Miguel-SLO/2312_BadgePlace/doc/proces-verbaux/2312_SANTOS_ProcesVerbal_20-09-23.docx

# Diplôme SLO

# SANTOS Miguel

# 2312 Badge pour place de travail

# Procès-verbal du mercredi 20 septembre 2023

Présences | État des lieux
- Mr. Santos Miguel - Mr. Bovey Philippe | Programmation du module RFID réalisé. Configuration et programmation du module ESP32.
Problèmes rencontrés | Solutions proposées
- Problèmes de « exception générale » sur le PIC32 - Problèmes de communication avec les modules UART. | Analyse et débogage approfondi. [Problèmes résolus]
Décisions prises | Objectifs jusqu’à prochaine réunion
Réaliser la programmation du PCB jusqu’au vendredi et se concentrer sur la rédaction du rapport ensuite jusqu’au rendu. Préparer une démonstration pour les portes ouvertes | Rendu du rapport le 26/09 Rendu de l’affiche + résumé le 27/09 Portes ouvertes le 29/09

Prochaine réunion planifiée le :

N/A

Projet terminé

Destinataires du procès-verbal :
Grégoire Rossier Doyen de l’ETML-ES | Philippe Bovey Maître de diplôme
Lausanne, le 21 septembre 2023
