Miguel-SLO/2312_BadgePlace/doc/proces-verbaux/2312_SANTOS_ProcesVerbal_13-09-23.docx

# Diplôme SLO

# SANTOS Miguel

# 2312 Badge pour place de travail

# Procès-verbal du mercredi 13 septembre 2023

Présences | État des lieux
- Mr. Santos Miguel - Mr. Bovey Philippe | PCB entièrement monté sans problème apparent (reste à tester certaines lignes de communication)
Problèmes rencontrés | Solutions proposées
Court-circuit entre le VCC et le GND | Un pont entre deux vias s’était formés sous le microcontrôleur [Problème réglé]
Décisions prises | Objectifs jusqu’à prochaine réunion
Finir au plus vite la documentation sur le hardware et commencer celle de la partie software Réalisation du software selon priorités de la séance précédente | - Finir la documentation sur la partie hardware - Réaliser les diagrammes d’états du software - Mettre en lien les différentes parties du software pour pouvoir réaliser une démonstration - Etablir une communication avec le serveur externe

Prochaine réunion planifié le :

Mercredi 20 septembre 2023

15h00 – 16h00

Salle R110 ES

Destinataires du procès-verbal :
Grégoire Rossier Doyen de l’ETML-ES | Philippe Bovey Maître de diplôme
Lausanne, le 19 septembre 2023
