Miguel-SLO/2312_BadgePlace/doc/rapport/Rendu final/2312_BadgePlace_Planification.pdf

2312 Badge pour place de travail | Planning | 2023

## ETML⁻ES

Pré-étude

Design

Revue de schémas

Commande composants

PCB

Revue de PCB

Commande PCB

Montage et tests

Modélisation 3D

Firmware PCB

Software RPI

Mise en service

Documentation

Rendu mémoire

21.août

22.août

23.août

24.août

25.août

26.août

27.août

28.août

29.août

30.août

31.août
01.sept

02.sept

03.sept

04.sept

05.sept

06.sept

07.sept

08.sept

09.sept

10.sept

11.sept

12.sept

13.sept

14.sept

15.sept

Rendu affiche + résumé

Portes ouvertes

Présentation orale

Miguel Santos | SLO | 1

2312 Badge pour place de travail | Planning | 2023

## ETML⁻ES

Pré-étude

Design

Revue de schémas

Commande composants

PCB

Revue de PCB

Commande PCB

Montage et tests

Modélisation 3D

Firmware PCB

Software RPI

Mise en service

Documentation

Rendu mémoire

Rendu affiche + résumé

Portes ouvertes

Présentation orale

16.sept

17.sept

18.sept

19.sept

20.sept

21.sept

22.sept

23.sept

24.sept

25.sept

26.sept

27.sept

28.sept

29.sept

30.sept
01.oct

02.oct

03.oct

04.oct

05.oct

06.oct

07.oct

08.oct

Miguel Santos | SLO | 2
