Miguel-SLO/2312_BadgePlace/doc/rapport/sections/03_Design.tex

\section{Contexte}

    Les formations en École Supérieure se caractérisent par leur approche orientée sur la pratique.
    Dans le cadre de la formation ES, il est demandé la réalisation d'un projet complet lors de la deuxième année. Celle-ci a pour but de nous sensibiliser à toutes les étapes par lesquels un projet doit passer pour être concrétiser.

\section{But du projet}
    \lipsum[1]

\section{Cahier des charges}

    \lipsum[1]
    \lipsum[1]
