Miguel-SLO/2312_BadgePlace/doc/rapport/2312_BadgePlace_ModeDemploi.docx

2312

Mode d’emploi

Connexion / Communication Wi-Fi en cours

Erreur réseau / Wi-Fi introuvable

Connexion au Wi-Fi réussi

Badge RFID accepté

Badge RFID refusé

Avertissement de timeout

Miguel Santos SLO 1

ETML-ES Mode d’emploi 2312 Badge pour place de travail
