Miguel-SLO/2312_BadgePlace/doc/rapport/Rendu final/2312_annexe_firmware/bzrc.pdf

1 /*******************************************************************************
2 | * ________ _________ ____ ____ _____ ________ ______
3 | * |_ __ || _ _ ||_ \ / _||_ _| |_ __ |.' ____ \
4 | * | |_ \_||_/ | | \_| | \/ | | | ______ | |_ \_|| (___ \_|
5 | * | _| _ | | | |\ /| | | | _|______|| _| _ _.____`.
6 | * _| |__/ | _| |_ _| |_\/_| |_ _| |__/ | _| |__/ || \____) |
7 | * |________| |_____| |_____||_____||________| |________| \______.'
8 *
9 ******************************************************************************* 10 *
11 | * File : buzzer.c
12 | * Version : 1.0
13 *
14 ******************************************************************************* 15 *
16 * Description : Managing buzzer state machine and sequences
17 *
18 | * Thanks to robsoncouto on GitHub for musics !
19 | * https://github.com/robsoncouto/arduino-songs.git
20 *
21 ******************************************************************************* 22 *
23 | * Author : Miguel Santos
24 | * Date : 25.09.2023
25 *
26 ******************************************************************************* 27 *
28 | * MPLAB X : 5.45
29 | * XC32 : 2.50
30 | * Harmony : 2.06
31 *
32 ******************************************************************************/ 33
34 #include "bzr.h"
35 #include "peripheral/oc/plib_oc.h"
36
37 /******************************************************************************/ 38
39 /* Define the timer used by the buzzer */
40 #define BZR_TMR_ID TMR_ID_3
41
42 /* Define the OC output used by the buzzer */
43 #define BZR_OC_ID OC_ID_5
44
45 /* Set the volume of the buzzer by changing duty cycle */
46 #define BZR_VOLUME 0.1
47
48 /******************************************************************************/ 49
50 /* Define frequencies of notes in Hz */
51 #define NOTE_B0 31
52 #define NOTE_C1 33
53 #define NOTE_CS1 35
54 #define NOTE_D1 37
55 #define NOTE_DS1 39
56 #define NOTE_E1 41
57 #define NOTE_F1 44
58 #define NOTE_FS1 46
59 #define NOTE_G1 49
60 #define NOTE_GS1 52
61 #define NOTE_A1 55
62 #define NOTE_AS1 58
63 #define NOTE_B1 62
64 #define NOTE_C2 65
65 #define NOTE_CS2 69
66 #define NOTE_D2 73
67 #define NOTE_DS2 78
68 #define NOTE_E2 82
69 #define NOTE_F2 87
70 #define NOTE_FS2 93
71 #define NOTE_G2 98
72 #define NOTE_GS2 104
73 #define NOTE_A2 110

74 #define NOTE_AS2 117
75 #define NOTE_B2 123
76 #define NOTE_C3 131
77 #define NOTE_CS3 139
78 #define NOTE_D3 147
79 #define NOTE_DS3 156
80 #define NOTE_E3 165
81 #define NOTE_F3 175
82 #define NOTE_FS3 185
83 #define NOTE_G3 196
84 #define NOTE_GS3 208
85 #define NOTE_A3 220
86 #define NOTE_AS3 233
87 #define NOTE_B3 247
88 #define NOTE_C4 262
89 #define NOTE_CS4 277
90 #define NOTE_D4 294
91 #define NOTE_DS4 311
92 #define NOTE_E4 330
93 #define NOTE_F4 349
94 #define NOTE_FS4 370
95 #define NOTE_G4 392
96 #define NOTE_GS4 415
97 #define NOTE_A4 440
98 #define NOTE_AS4 466
99 #define NOTE_B4 494
100 #define NOTE_C5 523
101 #define NOTE_CS5 554
102 #define NOTE_D5 587
103 #define NOTE_DS5 622
104 #define NOTE_E5 659
105 #define NOTE_F5 698
106 #define NOTE_FS5 740
107 #define NOTE_G5 784
108 #define NOTE_GS5 831
109 #define NOTE_A5 880
110 #define NOTE_AS5 932
111 #define NOTE_B5 988
112 #define NOTE_C6 1047
113 #define NOTE_CS6 1109
114 #define NOTE_D6 1175
115 #define NOTE_DS6 1245
116 #define NOTE_E6 1319
117 #define NOTE_F6 1397
118 #define NOTE_FS6 1480
119 #define NOTE_G6 1568
120 #define NOTE_GS6 1661
121 #define NOTE_A6 1760
122 #define NOTE_AS6 1865
123 #define NOTE_B6 1976
124 #define NOTE_C7 2093
125 #define NOTE_CS7 2217
126 #define NOTE_D7 2349
127 #define NOTE_DS7 2489
128 #define NOTE_E7 2637
129 #define NOTE_F7 2794
130 #define NOTE_FS7 2960
131 #define NOTE_G7 3136
132 #define NOTE_GS7 3322
133 #define NOTE_A7 3520
134 #define NOTE_AS7 3729
135 #define NOTE_B7 3951
136 #define NOTE_C8 4186
137 #define NOTE_CS8 4435
138 #define NOTE_D8 4699
139 #define NOTE_DS8 4978
140 | #define REST 0
141
142 /******************************************************************************/ 143
144 /* All sequences are defined here */
145
146 /* Test sequence */

147 int16_t BZR_SEQUENCE_TEST[] = { 148 NOTE_A4,4, REST,4, NOTE_A4, 4,
149 };
150
151 /* Super Mario Bros theme - by Koji Kondo*/
152 int16_t BZR_SEQUENCE_MARIO[] = {
153 NOTE_E5, 8, NOTE_E5,8, REST,8, NOTE_E5,8, REST,8, NOTE_C5,8, NOTE_E5,8, //1 154 NOTE_G5,4, REST,4, NOTE_G4,8, REST,4,
155 NOTE_C5,-4, NOTE_G4,8, REST,4, NOTE_E4,-4, // 3
156 NOTE_A4,4, NOTE_B4,4, NOTE_AS4,8, NOTE_A4,4,
157 NOTE_G4,-8, NOTE_E5,-8, NOTE_G5,-8, NOTE_A5,4, NOTE_F5,8, NOTE_G5,8, 158 REST,8, NOTE_E5,4,NOTE_C5,8, NOTE_D5,8, NOTE_B4,-4,
159 NOTE_C5,-4, NOTE_G4,8, REST,4, NOTE_E4,-4, // repeats from 3
160 NOTE_A4,4, NOTE_B4,4, NOTE_AS4,8, NOTE_A4,4,
161 NOTE_G4,-8, NOTE_E5,-8, NOTE_G5,-8, NOTE_A5,4, NOTE_F5,8, NOTE_G5,8,
162 REST,8, NOTE_E5,4,NOTE_C5,8, NOTE_D5,8, NOTE_B4,-4,
163 REST,4, NOTE_G5,8, NOTE_FS5,8, NOTE_F5,8, NOTE_DS5,4, NOTE_E5,8,//7
164 REST,8, NOTE_GS4,8, NOTE_A4,8, NOTE_C4,8, REST,8, NOTE_A4,8, NOTE_C5,8, NOTE_D5,8, 165 REST,4, NOTE_DS5,4, REST,8, NOTE_D5,-4,
166 NOTE_C5,2, REST,2,
167 REST,4, NOTE_G5,8, NOTE_FS5,8, NOTE_F5,8, NOTE_DS5,4, NOTE_E5,8,//repeats from 7 168 REST,8, NOTE_GS4,8, NOTE_A4,8, NOTE_C4,8, REST,8, NOTE_A4,8, NOTE_C5,8, NOTE_D5,8, 169 REST,4, NOTE_DS5,4, REST,8, NOTE_D5,-4,
170 NOTE_C5,2, REST,2,
171 NOTE_C5,8, NOTE_C5,4, NOTE_C5,8, REST,8, NOTE_C5,8, NOTE_D5,4,//11
172 NOTE_E5,8, NOTE_C5,4, NOTE_A4,8, NOTE_G4,2,
173 NOTE_C5,8, NOTE_C5,4, NOTE_C5,8, REST,8, NOTE_C5,8, NOTE_D5,8, NOTE_E5,8,//13 174 REST,1,
175 NOTE_C5,8, NOTE_C5,4, NOTE_C5,8, REST,8, NOTE_C5,8, NOTE_D5,4,
176 NOTE_E5,8, NOTE_C5,4, NOTE_A4,8, NOTE_G4,2,
177 NOTE_E5,8, NOTE_E5,8, REST,8, NOTE_E5,8, REST,8, NOTE_C5,8, NOTE_E5,4, 178 NOTE_G5,4, REST,4, NOTE_G4,4, REST,4,
179 NOTE_C5,-4, NOTE_G4,8, REST,4, NOTE_E4,-4, // 19
180 NOTE_A4,4, NOTE_B4,4, NOTE_AS4,8, NOTE_A4,4,
181 NOTE_G4,-8, NOTE_E5,-8, NOTE_G5,-8, NOTE_A5,4, NOTE_F5,8, NOTE_G5,8, 182 REST,8, NOTE_E5,4, NOTE_C5,8, NOTE_D5,8, NOTE_B4,-4,
183 NOTE_C5,-4, NOTE_G4,8, REST,4, NOTE_E4,-4, // repeats from 19
184 NOTE_A4,4, NOTE_B4,4, NOTE_AS4,8, NOTE_A4,4,
185 NOTE_G4,-8, NOTE_E5,-8, NOTE_G5,-8, NOTE_A5,4, NOTE_F5,8, NOTE_G5,8, 186 REST,8, NOTE_E5,4, NOTE_C5,8, NOTE_D5,8, NOTE_B4,-4,
187 NOTE_E5,8, NOTE_C5,4, NOTE_G4,8, REST,4, NOTE_GS4,4,//23
188 NOTE_A4,8, NOTE_F5,4, NOTE_F5,8, NOTE_A4,2,
189 NOTE_D5,-8, NOTE_A5,-8, NOTE_A5,-8, NOTE_A5,-8, NOTE_G5,-8, NOTE_F5,-8, 190 NOTE_E5,8, NOTE_C5,4, NOTE_A4,8, NOTE_G4,2, //26
191 NOTE_E5,8, NOTE_C5,4, NOTE_G4,8, REST,4, NOTE_GS4,4,
192 NOTE_A4,8, NOTE_F5,4, NOTE_F5,8, NOTE_A4,2,
193 NOTE_B4,8, NOTE_F5,4, NOTE_F5,8, NOTE_F5,-8, NOTE_E5,-8, NOTE_D5,-8, 194 NOTE_C5,8, NOTE_E4,4, NOTE_E4,8, NOTE_C4,2,
195 NOTE_E5,8, NOTE_C5,4, NOTE_G4,8, REST,4, NOTE_GS4,4,//repeats from 23 196 NOTE_A4,8, NOTE_F5,4, NOTE_F5,8, NOTE_A4,2,
197 NOTE_D5,-8, NOTE_A5,-8, NOTE_A5,-8, NOTE_A5,-8, NOTE_G5,-8, NOTE_F5,-8, 198 NOTE_E5,8, NOTE_C5,4, NOTE_A4,8, NOTE_G4,2, //26
199 NOTE_E5,8, NOTE_C5,4, NOTE_G4,8, REST,4, NOTE_GS4,4,
200 NOTE_A4,8, NOTE_F5,4, NOTE_F5,8, NOTE_A4,2,
201 NOTE_B4,8, NOTE_F5,4, NOTE_F5,8, NOTE_F5,-8, NOTE_E5,-8, NOTE_D5,-8, 202 NOTE_C5,8, NOTE_E4,4, NOTE_E4,8, NOTE_C4,2,
203 NOTE_C5,8, NOTE_C5,4, NOTE_C5,8, REST,8, NOTE_C5,8, NOTE_D5,8, NOTE_E5,8, 204 REST,1,
205 NOTE_C5,8, NOTE_C5,4, NOTE_C5,8, REST,8, NOTE_C5,8, NOTE_D5,4, //33
206 NOTE_E5,8, NOTE_C5,4, NOTE_A4,8, NOTE_G4,2,
207 NOTE_E5,8, NOTE_E5,8, REST,8, NOTE_E5,8, REST,8, NOTE_C5,8, NOTE_E5,4, 208 NOTE_G5,4, REST,4, NOTE_G4,4, REST,4,
209 NOTE_E5,8, NOTE_C5,4, NOTE_G4,8, REST,4, NOTE_GS4,4,
210 NOTE_A4,8, NOTE_F5,4, NOTE_F5,8, NOTE_A4,2,
211 NOTE_D5,-8, NOTE_A5,-8, NOTE_A5,-8, NOTE_A5,-8, NOTE_G5,-8, NOTE_F5,-8, 212 NOTE_E5,8, NOTE_C5,4, NOTE_A4,8, NOTE_G4,2, //40
213 NOTE_E5,8, NOTE_C5,4, NOTE_G4,8, REST,4, NOTE_GS4,4,
214 NOTE_A4,8, NOTE_F5,4, NOTE_F5,8, NOTE_A4,2,
215 NOTE_B4,8, NOTE_F5,4, NOTE_F5,8, NOTE_F5,-8, NOTE_E5,-8, NOTE_D5,-8, 216 NOTE_C5,8, NOTE_E4,4, NOTE_E4,8, NOTE_C4,2,
217 //game over sound
218 NOTE_C5,-4, NOTE_G4,-4, NOTE_E4,4, //45
219 NOTE_A4,-8, NOTE_B4,-8, NOTE_A4,-8, NOTE_GS4,-8, NOTE_AS4,-8, NOTE_GS4,-8,

220 NOTE_G4,8, NOTE_D4,8, NOTE_E4,-2,
221
222 };
223 /* Dart Vader theme (Imperial March) - Star wars */
224 int16_t BZR_SEQUENCE_IMPERIAL[] = {
225 NOTE_A4, -4, NOTE_A4, -4, NOTE_A4, 16, NOTE_A4, 16,
226 | NOTE_A4, 16, NOTE_A4, 16, NOTE_F4, 8, REST, 8,
227 NOTE_A4, -4, NOTE_A4, -4, NOTE_A4, 16, NOTE_A4, 16,
228 | NOTE_A4, 16, NOTE_A4, 16, NOTE_F4, 8, REST, 8,
229 | NOTE_A4, 4, NOTE_A4, 4, NOTE_A4, 4,
230 | NOTE_F4, -8, NOTE_C5, 16, NOTE_A4, 4,
231 | NOTE_F4, -8, NOTE_C5, 16, NOTE_A4, 2,
232 | NOTE_E5, 4, NOTE_E5, 4, NOTE_E5, 4,
233 | NOTE_F5, -8, NOTE_C5, 16, NOTE_A4, 4,
234 | NOTE_F4, -8, NOTE_C5, 16, NOTE_A4, 2,
235 | NOTE_A5, 4, NOTE_A4, -8, NOTE_A4, 16,
236 | NOTE_A5, 4, NOTE_GS5, -8, NOTE_G5, 16,
237 | NOTE_DS5, 16, NOTE_D5, 16, NOTE_DS5, 8, REST, 8,
238 | NOTE_A4, 8, NOTE_DS5, 4, NOTE_D5, -8, NOTE_CS5, 16,
239 | NOTE_C5, 16, NOTE_B4, 16, NOTE_C5, 16, REST, 8,
240 | NOTE_F4, 8, NOTE_GS4, 4, NOTE_F4, -8, NOTE_A4, -16,
241 | NOTE_C5, 4, NOTE_A4, -8, NOTE_C5, 16, NOTE_E5, 2,
242 | NOTE_A5, 4, NOTE_A4, -8, NOTE_A4, 16,
243 | NOTE_A5, 4, NOTE_GS5, -8, NOTE_G5, 16,
244 | NOTE_DS5, 16, NOTE_D5, 16, NOTE_DS5, 8, REST, 8,
245 | NOTE_A4, 8, NOTE_DS5, 4, NOTE_D5, -8, NOTE_CS5, 16,
246 | NOTE_C5, 16, NOTE_B4, 16, NOTE_C5, 16, REST, 8,
247 | NOTE_F4, 8, NOTE_GS4, 4, NOTE_F4, -8, NOTE_A4, -16,
248 | NOTE_A4, 4, NOTE_F4, -8, NOTE_C5, 16,
249 | NOTE_A4, 2,
250 };
251
252 /******************************************************************************/ 253
254 /* Hold informations about sequences */
255 S_BZR_SEQ BZR_SEQUENCES[] = {
256 /* TESTING */
257 {
258 .tempo = 200,
259 .size = sizeof(BZR_SEQUENCE_TEST), 260 .notes = BZR_SEQUENCE_TEST,
261 },
262 /* MARIO BROS SONG */
263 {
264 .tempo = 200,
265 .size = sizeof(BZR_SEQUENCE_MARIO), 266 .notes = BZR_SEQUENCE_MARIO,
267 },
268 /* IMPERIAL MARCH */
269 {
270 .tempo = 120,
271 .size = sizeof(BZR_SEQUENCE_IMPERIAL), 272 .notes = BZR_SEQUENCE_IMPERIAL,
273 },
274 };
275
276 /******************************************************************************/ 277
278 /* Declaration of global application data */
279 BZR_DATA bzrData;
280
281 /******************************************************************************/ 282
283 /* Static functions declaration */
284
285 static void BZR_SetFrequency(uint16_t frequency);
286 static void BZR_SetCounter(int8_t tempo);
287
288 /******************************************************************************/ 289
290 /**
291 * @brief BZR_Initialize
292 *

293 * Initialize buzzer state machine 294 *
295 * @param void
296 * @return void
297 */
298 void BZR_Initialize ( void )
299 {
300 /* Place the buzzer state machine in its initial state. */ 301 bzrData.state = BZR_STATE_IDLE;
302
303 /* Flag to indicate a new sequence available */
304 bzrData.newSequence = false;
305
306 /* Calculate timer frequency only one time */
307 bzrData.tmrFrequency = (uint32_t)(SYS_CLK_FREQ /
308 PLIB_TMR_PrescaleGet(BZR_TMR_ID)); 309
310 /* Init counter used to count time of notes */
311 CNT_Initialize(&bzrData.counterPlay, 0x00);
312 }
313
314 /******************************************************************************/ 315
316 /**
317 * @brief BZR_Tasks
318 *
319 * Execute buzzer state machine, should be called cyclically 320 *
321 * @param void
322 * @return void
323 */
324 void BZR_Tasks ( void )
325 {
326
327 /* Check the application's current state. */ 328 switch ( bzrData.state )
329 {
330 /* Buzzer waiting for new sequence */ 331 case BZR_STATE_IDLE:
332 {
333 if(bzrData.newSequence)
334 {
335 bzrData.state = BZR_STATE_NOTE; 336 }
337 break;
338 }
339
340 /* Buzzer getting the note to play */
341 case BZR_STATE_NOTE:
342 {
343 BZR_SetFrequency(bzrData.currentNote[0]); 344 BZR_SetCounter(bzrData.currentNote[1]); 345 bzrData.state = BZR_STATE_PLAYING;
346 break;
347 }
348
349 /* Buzzer playing the note and waiting */ 350 case BZR_STATE_PLAYING:
351 {
352 if(CNT_Check(&bzrData.counterPlay))
353 {
354 if(bzrData.currentNote >= bzrData.lastNote) 355 {
356 PLIB_TMR_Stop(BZR_TMR_ID);
357 PLIB_OC_Disable(BZR_OC_ID);
358 bzrData.newSequence = false; 359 bzrData.state = BZR_STATE_IDLE; 360 }
361 else
362 {
363 bzrData.currentNote += 2; 364 bzrData.state = BZR_STATE_NOTE; 365 }

366 }
367 break;
368 }
369
370 /* The default state should never be executed. */
371 default:
372 {
373 /* TODO: Handle error in application's state machine. */ 374 break;
375 }
376 }
377 }
378
379 /******************************************************************************/ 380
381 /**
382 * @brief BZR_PlaySequence
383 *
384 * Play a music sequence using the state machine
385 *
386 | * @param | E_BZR_SEQ song Call the music you wann play !
387 * @return void
388 */
389 void BZR_PlaySequence(E_BZR_SEQ song)
390 {
391 bzrData.sequence = BZR_SEQUENCES[song].notes; 392
393 bzrData.tempo = BZR_SEQUENCES[song].tempo; 394
395 bzrData.currentNote = bzrData.sequence;
396
397 bzrData.lastNote = bzrData.sequence + BZR_SEQUENCES[song].size / 2 - 2; 398
399 bzrData.newSequence = true;
400 }
401
402 /******************************************************************************/ 403
404 /**
405 * @brief BZR_SetFrequency
406 *
407 * Set the frequency of the timer to play a note 408 * Start the timer and OC except if frequency is 0 409 *
410 | * @param | uint16_t frequency Frequency to play
411 * @return void
412 */
413 static void BZR_SetFrequency(uint16_t frequency) 414 {
415 uint16_t period_tmr;
416
417 PLIB_TMR_Stop(BZR_TMR_ID); 418 PLIB_OC_Disable(BZR_OC_ID); 419
420 if(frequency != 0)
421 {
422 period_tmr = (uint16_t)( bzrData.tmrFrequency / frequency); 423
424 PLIB_TMR_Period16BitSet(BZR_TMR_ID, period_tmr);
425 PLIB_OC_PulseWidth16BitSet(BZR_OC_ID, period_tmr * BZR_VOLUME); 426
427 PLIB_TMR_Start(BZR_TMR_ID);
428 PLIB_OC_Enable(BZR_OC_ID);
429 }
430 }
431
432 /******************************************************************************/ 433
434 /**
435 * @brief BZR_SetCounter
436 *
437 * Set the duration of the note, using musical tempo 438 * (whole, half, quarter, eigth, ...)

439 *
440 | * @param | int8_t tempo note tempo
441 * @return void
442 */
443 static void BZR_SetCounter(int8_t tempo) 444 {
445 uint32_t counter_ms;
446
447 if(tempo > 0)
448 {
449 counter_ms = (uint32_t)((60000 * 4 / bzrData.tempo) / tempo); 450 }
451 else if(tempo < 0)
452 {
453 counter_ms = (uint32_t)((60000 * 4 / bzrData.tempo)/ abs(tempo)); 454 counter_ms = counter_ms * 1.5;
455 }
456 else
457 {
458 counter_ms = 0;
459 }
460
461 CNT_Set(&bzrData.counterPlay, counter_ms); 462 CNT_Reset(&bzrData.counterPlay);
463 }
464
465 /******************************************************************************/ 466
467 /* End of File ****************************************************************/ 468
