Miguel-SLO/2312_BadgePlace/doc/rapport/Rendu final/2312_annexe_firmware/esph.pdf

1 /*******************************************************************************
2 | * ________ _________ ____ ____ _____ ________ ______
3 | * |_ __ || _ _ ||_ \ / _||_ _| |_ __ |.' ____ \
4 | * | |_ \_||_/ | | \_| | \/ | | | ______ | |_ \_|| (___ \_|
5 | * | _| _ | | | |\ /| | | | _|______|| _| _ _.____`.
6 | * _| |__/ | _| |_ _| |_\/_| |_ _| |__/ | _| |__/ || \____) |
7 | * |________| |_____| |_____||_____||________| |________| \______.'
8 *
9 ******************************************************************************* 10 *
11 | * File : esp.h
12 | * Version : 1.0
13 *
14 ******************************************************************************* 15 *
16 * Description : Managing ESP32 state machine and commands
17 *
18 ******************************************************************************* 19 *
20 | * Author : Miguel Santos
21 | * Date : 25.09.2023
22 *
23 ******************************************************************************* 24 *
25 | * MPLAB X : 5.45
26 | * XC32 : 2.50
27 | * Harmony : 2.06
28 *
29 ******************************************************************************/ 30
31 #ifndef _ESP_H
32 #define _ESP_H
33
34 /******************************************************************************/ 35
36 #include <stdint.h>
37 #include <stdbool.h>
38 #include "system_config.h"
39 #include "system_definitions.h" 40 #include "modules/fifo.h"
41 #include "modules/counter.h"
42
43 /******************************************************************************/ 44
45 /* Buffers sizes */
46
47 #define ESP_FIFO_SIZE 50 48 #define AT_CMD_SIZE 50
49 #define AT_DATA_SIZE 50
50 #define AT_ACK_SIZE 10
51
52 /******************************************************************************/ 53
54 /* AT commands to send */
55 | #define AT_CMD_AT "AT"
56 | #define AT_CMD_RST "AT+RST"
57 #define AT_CMD_CWMODEIS "AT+CWMODE=1"
58 | #define AT_CMD_CWMODE "AT+CWMODE?"
59 | #define AT_CMD_CWJAP "AT+CWJAP=\"ES-SLO-2\",\"slo-etml-es\""
60
61 /* AT acknowledge responses */
62 | #define AT_ACK_OK "OK"
63 | #define AT_ACK_ERROR "ERROR"
64
65 /******************************************************************************/ 66
67 /* Structure of packets communication as defined by ESP32 datasheet */
68 typedef struct
69 {
70 char command[AT_CMD_SIZE];
71 char data[AT_DATA_SIZE]; 72 char ack[AT_ACK_SIZE];
73

74 } S_AT_PACKET;
75
76 /******************************************************************************/ 77
78 /* ESP state machine */

### 79 typedef enum

80 {
81 /* Waiting for a command */ 82 ESP_STATE_IDLE,
83
84 /* Transmitting a command */ 85 ESP_STATE_TRANSMIT,
86
87 /* Receiving a command */
88 ESP_STATE_RECEIVE,
89
90 /* Translating the UART message */ 91 ESP_STATE_TRANSLATE,
92
93 /* Waiting for main application */ 94 ESP_STATE_WAIT,
95
96 } E_ESP_STATES;
97
98 /******************************************************************************/ 99
100 /* ESP32 structure of global data */
101 typedef struct
102 {
103 /* Application's current states */ 104 E_ESP_STATES state;
105
106 /* Applications's flags */
107 bool transmit;
108 bool receive;
109 bool translate;
110 bool wait;
111 bool newMessage;
112
113 /* Applications COUNTERS */ 114 S_Counter cntReceive;
115 S_Counter cntWait;
116
117 /* Application's FIFOS descriptors */ 118 S_Fifo fifoDesc_tx;
119 S_Fifo fifoDesc_rx;
120
121 /* Application's FIFOS buffers */ 122 uint8_t fifoBuff_tx[ESP_FIFO_SIZE]; 123 uint8_t fifoBuff_rx[ESP_FIFO_SIZE]; 124
125 /* Buffer to store response commands */ 126 char resBuffer[ESP_FIFO_SIZE];
127
128 /* Pointer to last char received */ 129 char *p_resBuffer;
130
131 /* Store response as different fields */ 132 S_AT_PACKET atResponse;
133
134 } ESP_DATA;
135
136 /******************************************************************************/ 137
138 /**
139 * @brief ESP_Initialize
140 *
141 * Initialize ESP32 state machine, counters and FIFOs 142 *
143 * @param void
144 * @return void
145 */
146 void ESP_Initialize ( void );

147
148 /******************************************************************************/ 149
150 /**
151 * @brief ESP_Tasks
152 *
153 * Execute ESP32 state machine, should be called cyclically 154 *
155 * @param void
156 * @return void
157 */
158 void ESP_Tasks( void );
159
160 /******************************************************************************/ 161
162 /**
163 * @brief ESP_SendCommand
164 *
165 * Send a command to the ESP32, managed by state machine
166 *
167 * @param char Command to send ; Use constant definitions
168 * @return bool True = command send ; False = Not allowed to send a command 169 */
170 bool ESP_SendCommand( char *command );
171
172 /******************************************************************************/ 173
174 #endif /* _ESP_H */
175
176 /* End of File ****************************************************************/ 177
