Miguel-SLO/2312_BadgePlace/doc/rapport/Rendu final/2312_annexe_firmware/SerialTimerc.pdf

1 /*******************************************************************************
2 | * ________ _________ ____ ____ _____ ________ ______
3 | * |_ __ || _ _ ||_ \ / _||_ _| |_ __ |.' ____ \
4 | * | |_ \_||_/ | | \_| | \/ | | | ______ | |_ \_|| (___ \_|
5 | * | _| _ | | | |\ /| | | | _|______|| _| _ _.____`.
6 | * _| |__/ | _| |_ _| |_\/_| |_ _| |__/ | _| |__/ || \____) |
7 | * |________| |_____| |_____||_____||________| |________| \______.'
8 *
9 ******************************************************************************* 10 *
11 | * File : SerialTimer.c
12 | * Version : 1.0
13 *
14 ******************************************************************************* 15 *
16 * Description : Emulate a serial port on a GPIO pin using a timer
17 *
18 ******************************************************************************* 19 *
20 | * Author : Miguel Santos
21 | * Date : 14.09.2023
22 *
23 ******************************************************************************* 24 *
25 | * MPLAB X : 5.45
26 | * XC32 : 2.50
27 | * Harmony : 2.06
28 *
29 ******************************************************************************/ 30
31 #include "system_definitions.h"
32 #include "SerialTimer.h"
33
34 /* Pin where the serial datas will be output */
35 #define SERIAL_PIN LATDbits.LATD0
36
37 /* Pin to control the timer related to the serial emulator */ 38 #define STR_TMR_ID DRV_TMR_INDEX_1
39
40 /* Number of bits to transmit per data */
41 #define SERIAL_BITS 5
42
43 /******************************************************************************/ 44
45 uint8_t strBuffer[STR_BUFFER_SIZE];
46 uint8_t *strPointer;
47 uint8_t *strLast;
48 uint8_t bitPosition;
49
50 /******************************************************************************/ 51
52 void STR_Init( void )
53 {
54 uint8_t i_buffer;
55
56 for(i_buffer = 0 ; i_buffer < STR_BUFFER_SIZE ; i_buffer++) 57 {
58 strBuffer[i_buffer] = STR_BUFFER_DEFAULT;
59 }
60 strPointer = strBuffer;
61 bitPosition= 0;
62 }
63
64 /******************************************************************************/ 65
66 void STR_AddBuffer(uint8_t *data, uint8_t size)
67 {
68 uint8_t i_data;
69
70 for(i_data = 0; i_data < size ; i_data++) 71 {
72 strBuffer[i_data] = *(data + i_data); 73 }

74
75 strLast = strBuffer + size - 1;
76 }
77
78 /******************************************************************************/ 79

### 80 void STR_Start( void )

81 {
82 DRV_TMR_Start(STR_TMR_ID);
83 }
84
85 /******************************************************************************/ 86

### 87 void STR_CallBack( void )

88 {
89 SERIAL_PIN = (*strPointer >> bitPosition) & 0x01; 90
91 bitPosition++;
92
93 /* Go back to lsb when reached limit */

### 94 if(bitPosition>= SERIAL_BITS)

95 {
96 bitPosition= 0;
97 strPointer++;
98 }
99
100 /* Disable timer when reached end of buffer */ 101 if(strPointer > strLast)
102 {
103 DRV_TMR_Stop(STR_TMR_ID);
104 strPointer = strBuffer; 105 }
106 }
107
108 /* End of File ****************************************************************/ 109
