Miguel-SLO/2312_BadgePlace/doc/captures/clearance_esp32.png

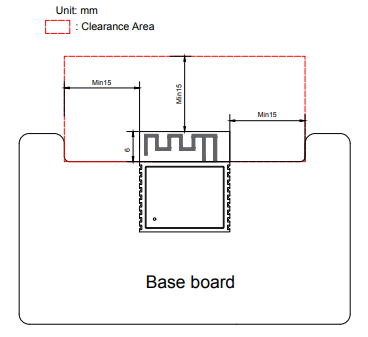
doc/captures/clearance_esp32.png
