Miguel-SLO/2312_BadgePlace/doc/captures/ESP32_Boot_putty.PNG

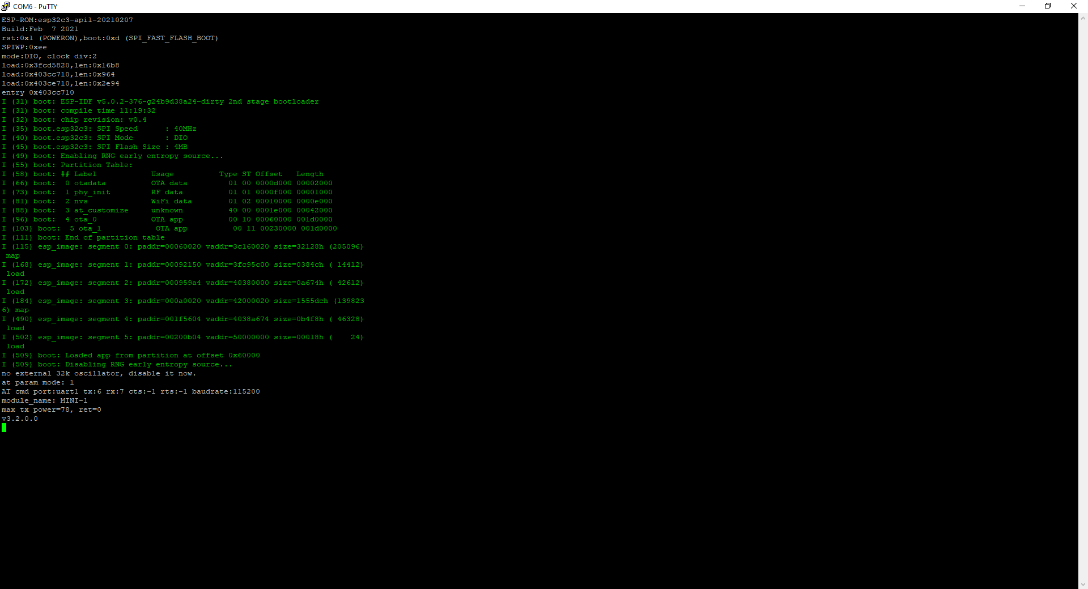
doc/captures/ESP32_Boot_putty.PNG
