Miguel-SLO/2312_BadgePlace/doc/captures/ESP/CMD_AT.png

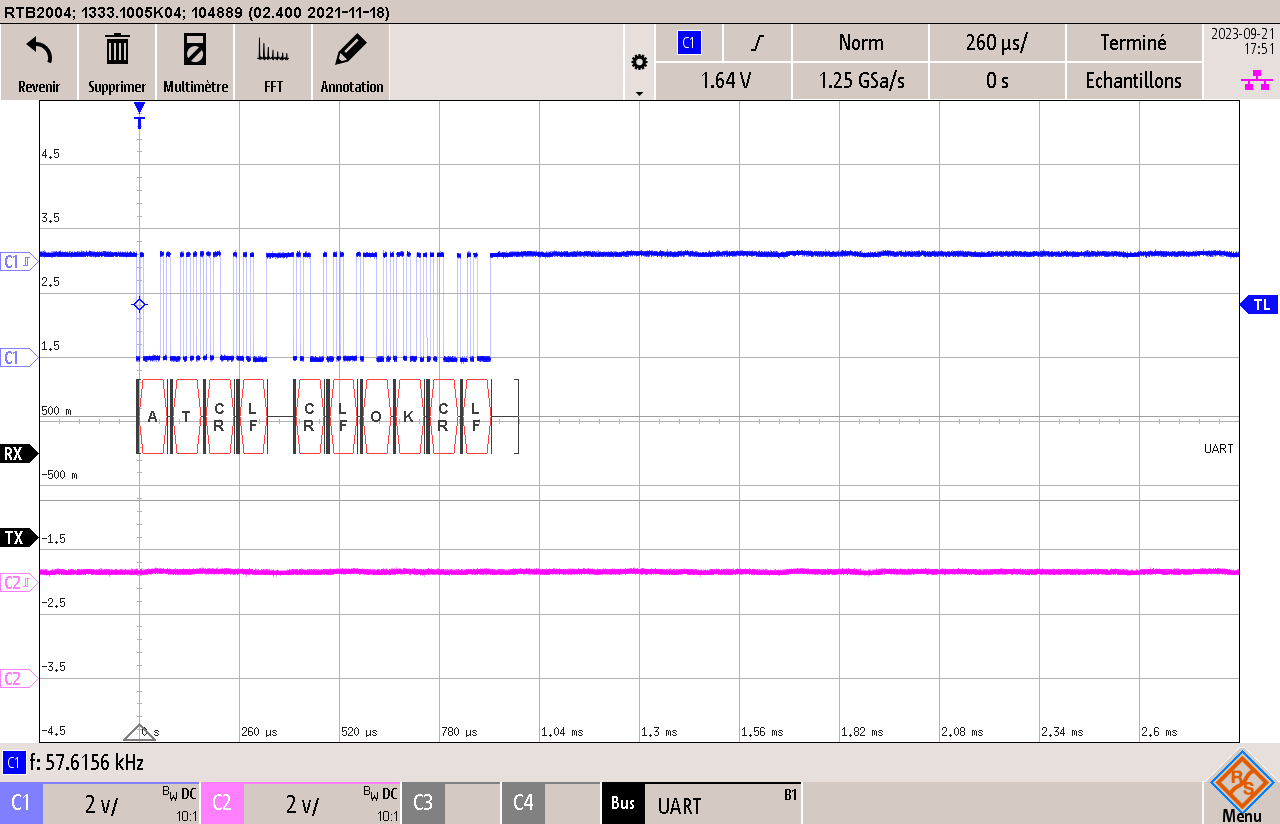
doc/captures/ESP/CMD_AT.png
