Miguel-SLO/2312_BadgePlace/doc/captures/ESP/WifiGotIP.png

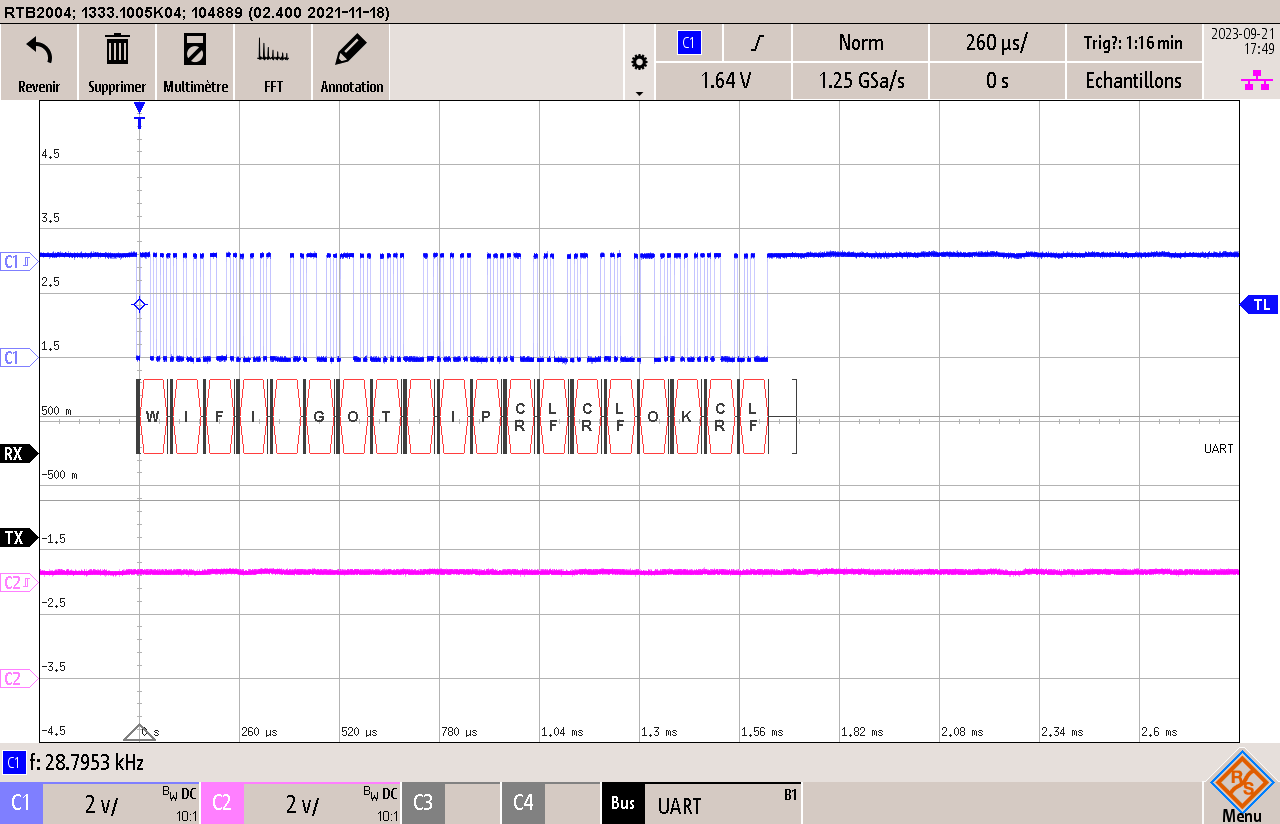
doc/captures/ESP/WifiGotIP.png
