Miguel-SLO/2312_BadgePlace/doc/captures/flash_esp32_c3.PNG

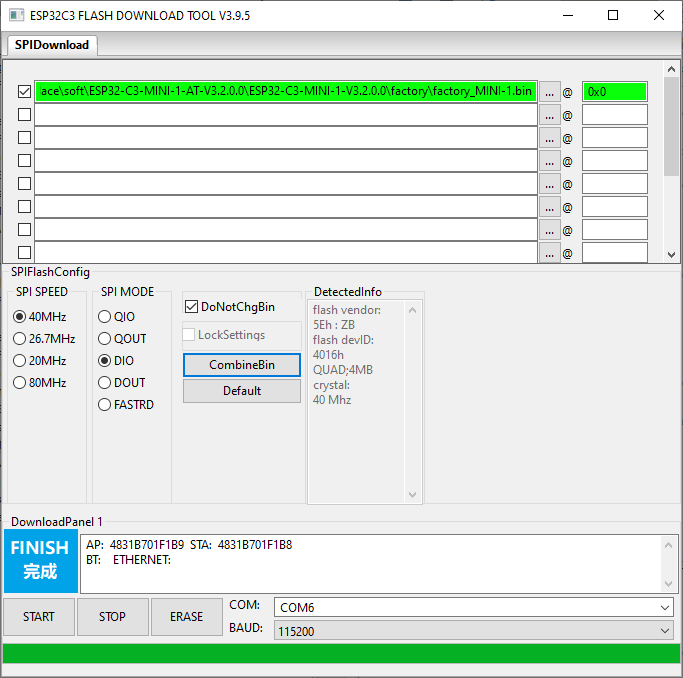
doc/captures/flash_esp32_c3.PNG
