Miguel-SLO/2312_BadgePlace/doc/captures/MPLAB/Configuration_USART.PNG

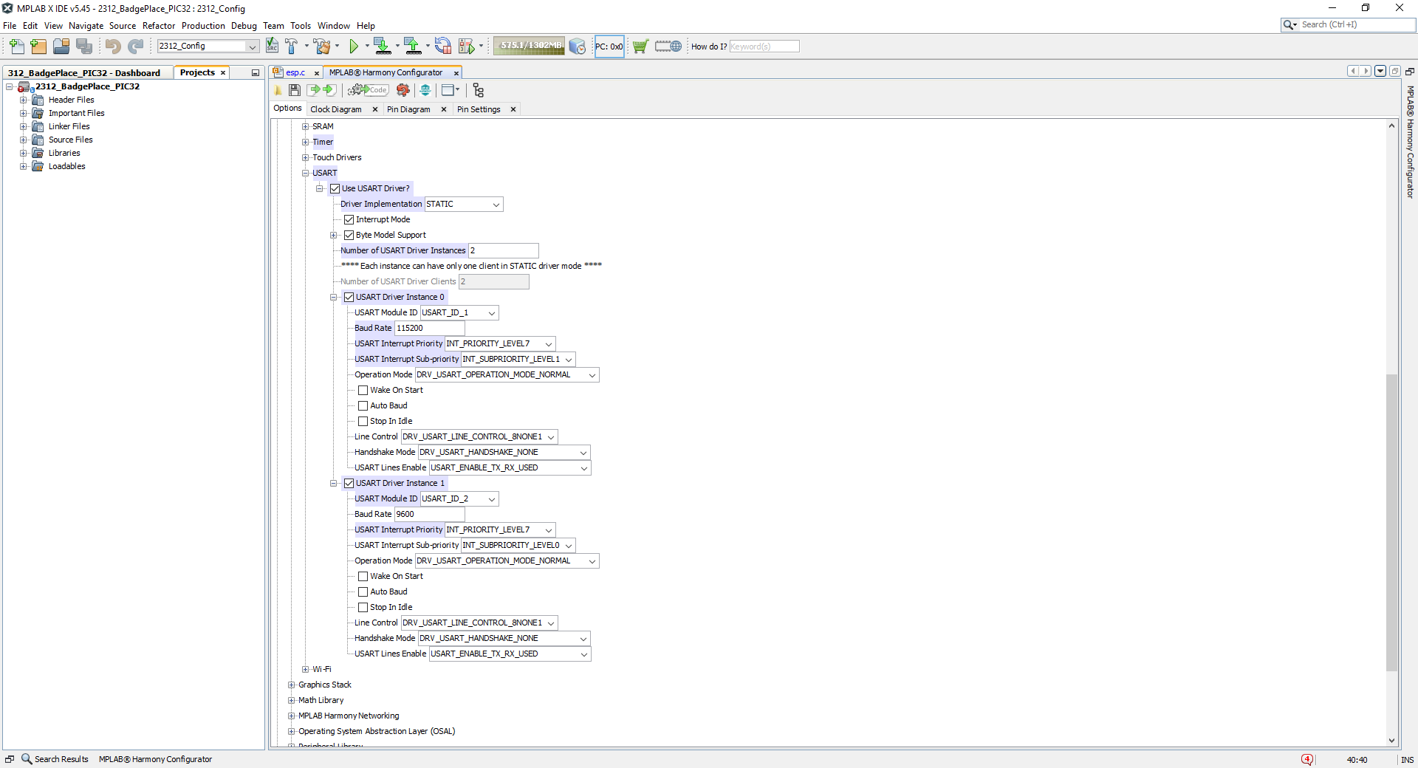
doc/captures/MPLAB/Configuration_USART.PNG
