Miguel-SLO/2312_BadgePlace/doc/captures/MPLAB/réception_command-ATCWINIT.png

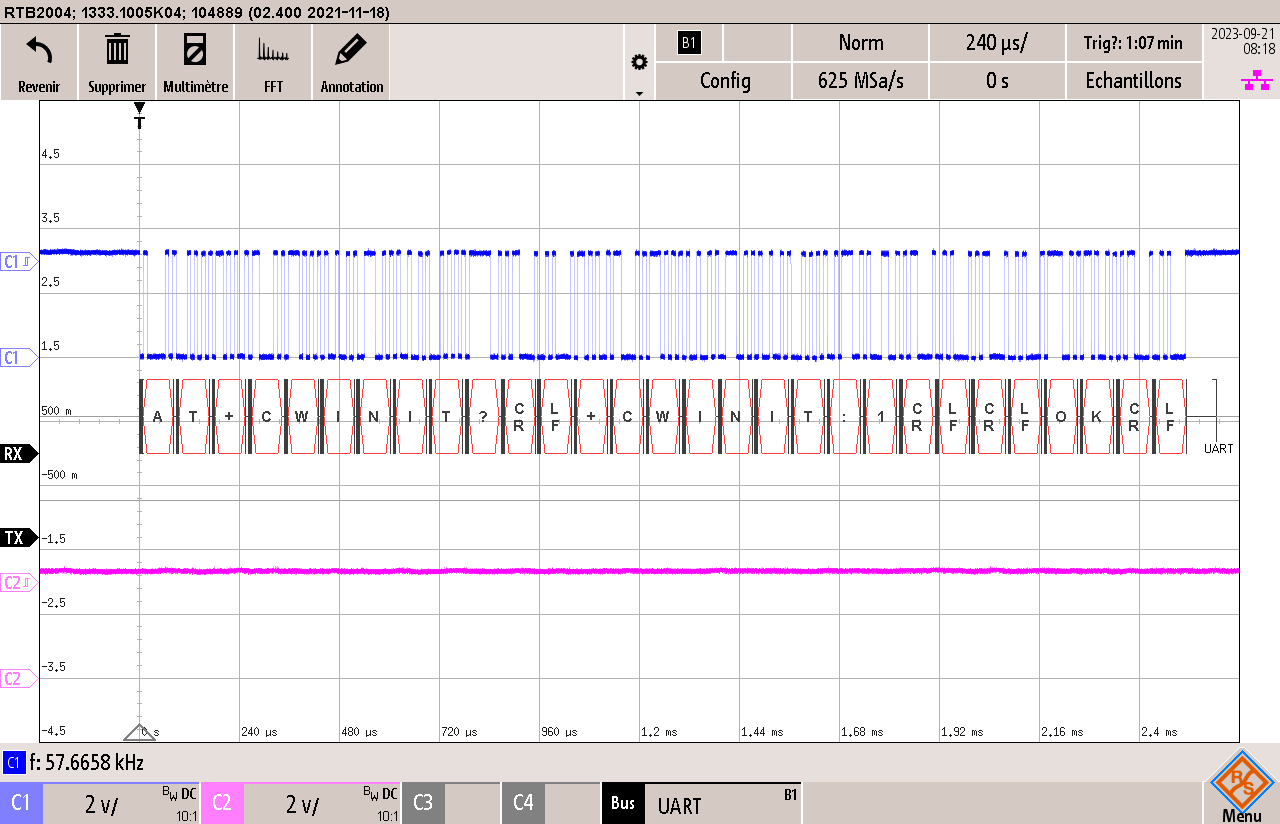
doc/captures/MPLAB/réception_command-ATCWINIT.png
