Miguel-SLO/2312_BadgePlace/doc/captures/pic32_config_timers.PNG

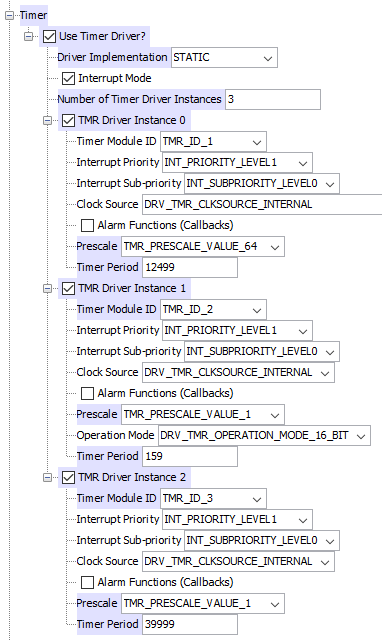
doc/captures/pic32_config_timers.PNG
