Miguel-SLO/2312_BadgePlace/doc/captures/pic32_config_usart.PNG

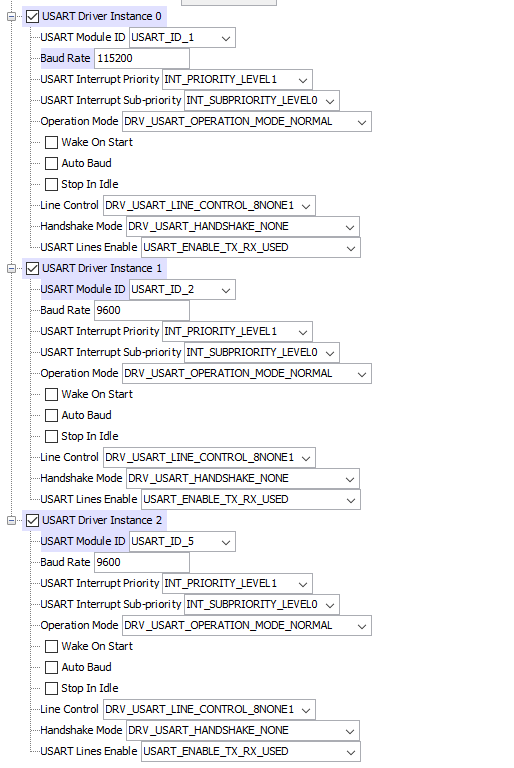
doc/captures/pic32_config_usart.PNG
