Miguel-SLO/2312_BadgePlace/doc/captures/placemement_esp32.png

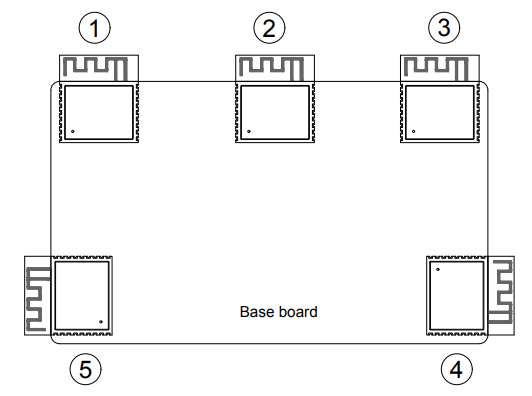
doc/captures/placemement_esp32.png
