Miguel-SLO/2312_BadgePlace/doc/captures/placemement_esp32_annoté.png

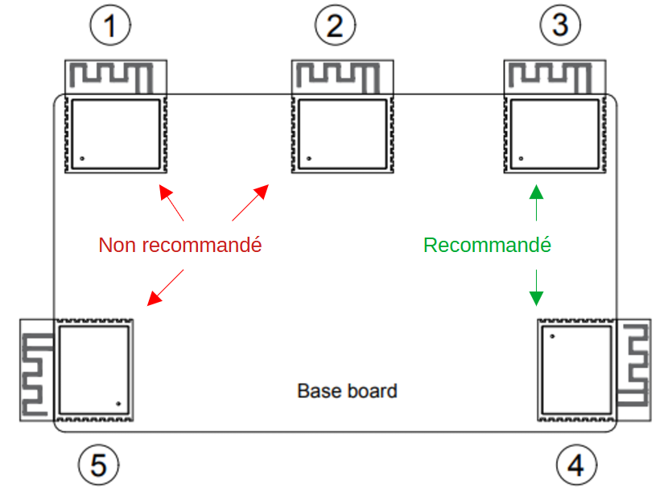
doc/captures/placemement_esp32_annoté.png
