Miguel-SLO/2312_BadgePlace/doc/firmware/ConfigHarmony/Harmony_OC.PNG

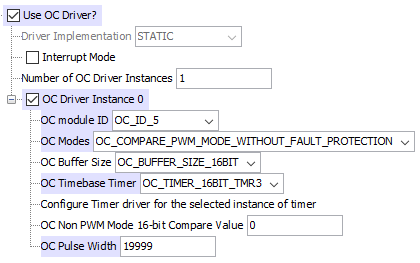
doc/firmware/ConfigHarmony/Harmony_OC.PNG
