Miguel-SLO/2312_BadgePlace/doc/firmware/ConfigHarmony/Harmony_TMR.PNG

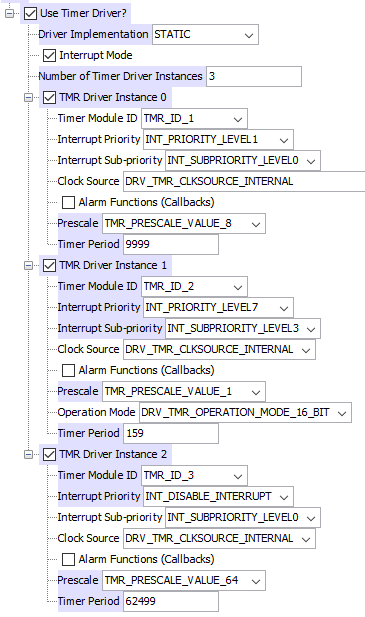
doc/firmware/ConfigHarmony/Harmony_TMR.PNG
