Miguel-SLO/2312_BadgePlace/doc/firmware/ConfigHarmony/Harmony_UART.PNG

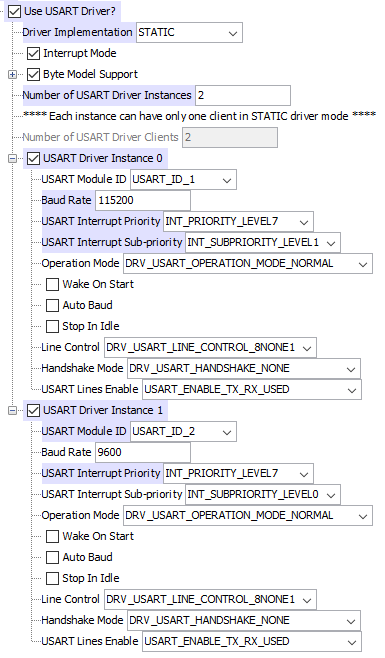
doc/firmware/ConfigHarmony/Harmony_UART.PNG
