Miguel-SLO/2312_BadgePlace/doc/rapport/2312_SchemasBlocs/2312_Images_Schemas/bluetooth.png

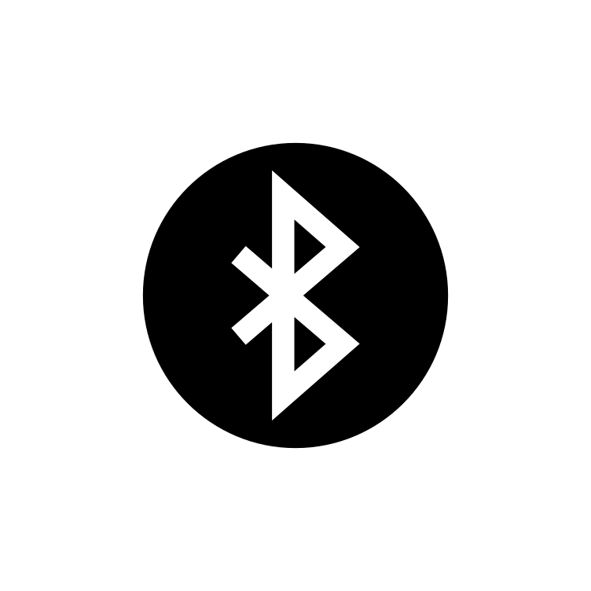
doc/rapport/2312_SchemasBlocs/2312_Images_Schemas/bluetooth.png
