Miguel-SLO/2312_BadgePlace/hard/2312_BadgePlaceTravail-BOM-TEMPLATE.xlsx

ETML-ES |  | Liste de matériel
Nom du projet : |  | Badge pour place de travail |  | Auteur : | Miguel Santos |  | PCB : | A
N° de projet : |  | 2312 |  | Date : | 2023-08-29 |  | Version : | 1.0
Column=Description | Column=Designator | Column=Quantity | Column=Manufacturer 1 | Column=Manufacturer Part Number 1 | Column=Supplier 1 | Column=Supplier Part Number 1 | Column=Supplier Unit Price 1 | Column=In stock
