Miguel-SLO/2312_BadgePlace/hard/2312_Boitier/2312_FullCase.step

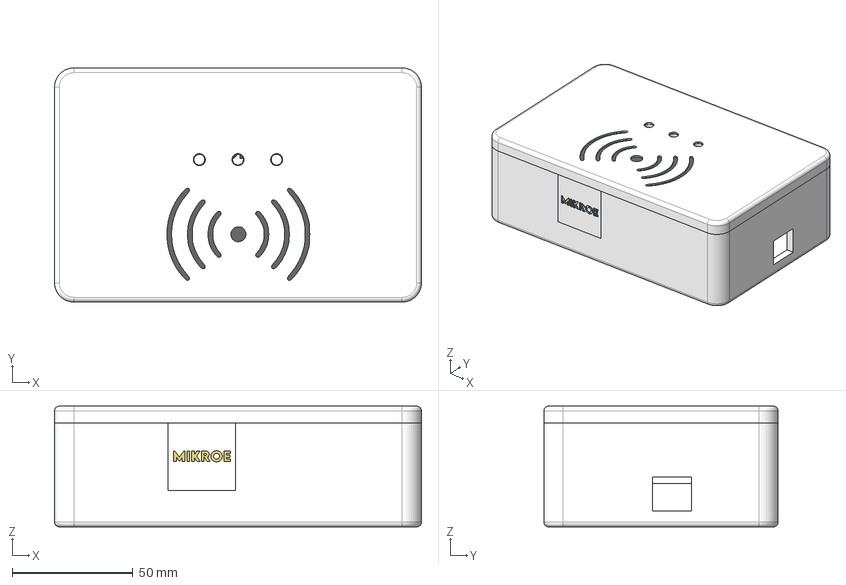
[picture p99: CAD file, 2023-09-27]
hard/2312_Boitier/2312_FullCase.step
152.0 x 97.0 x 50.0 mm
Bottom_case
Bottom_text
top_case
Corps001
Mikroe_cache
Corps
