Miguel-SLO/2312_BadgePlace/hard/2312_Boitier/2312_Case-2312_Bottom.step

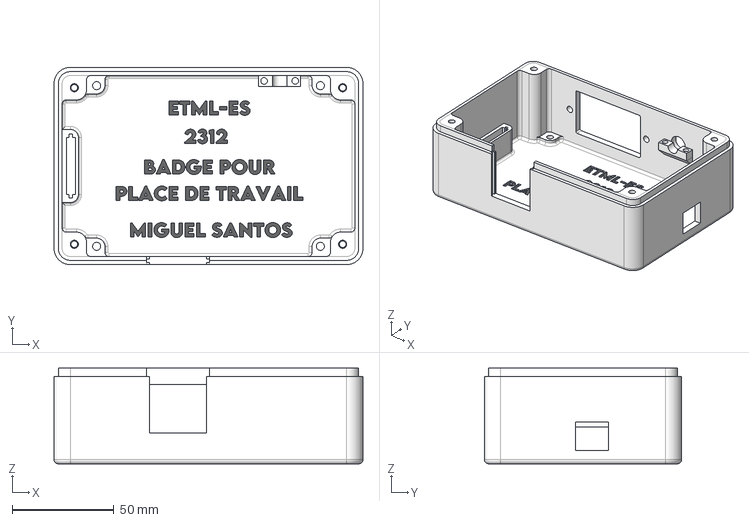
[picture p101: CAD file, 2023-10-04]
hard/2312_Boitier/2312_Case-2312_Bottom.step
152.0 x 97.0 x 47.0 mm
Bottom_case
Bottom_text
