Miguel-SLO/2312_BadgePlace/hard/2312_Composants/#_STEP-EXTERNE/e_0100.2571_002.step

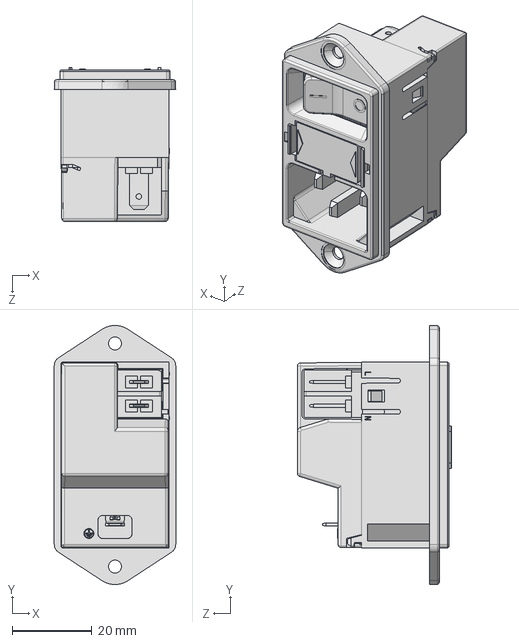
[picture p102: CAD file, 2023-08-31]
hard/2312_Composants/#_STEP-EXTERNE/e_0100.2571_002.step
30.5 x 65.0 x 38.7 mm
