Miguel-SLO/2312_BadgePlace/hard/2312_Composants/ADW1203HLW/ADW1203HLW.step

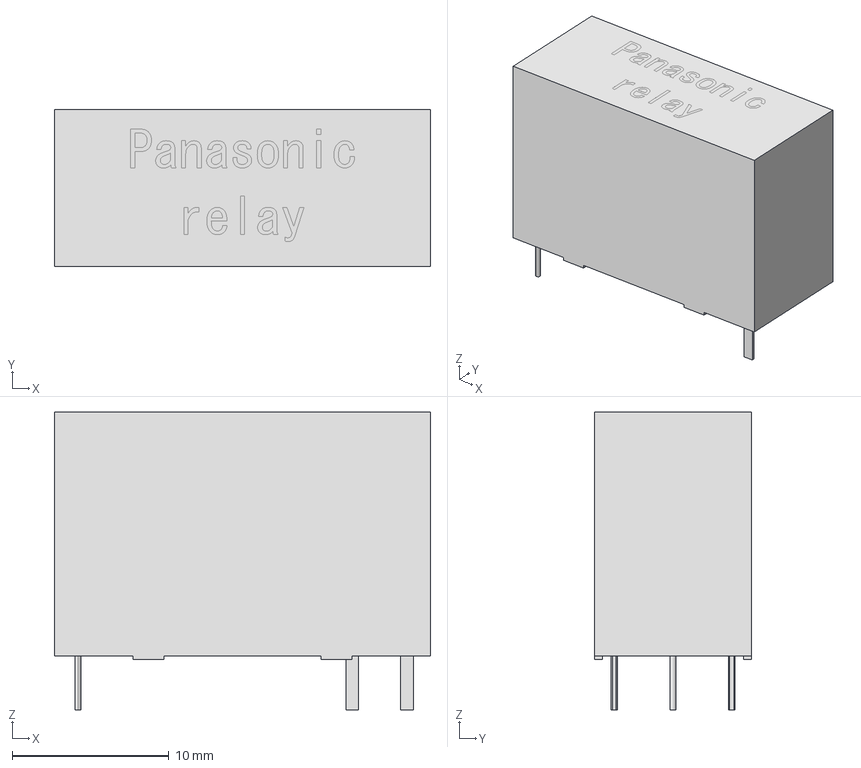
[picture p103: CAD file, 2023-08-25]
hard/2312_Composants/ADW1203HLW/ADW1203HLW.step
24.0 x 10.0 x 19.0 mm
