Miguel-SLO/2312_BadgePlace/hard/2312_Composants/CEM-1201_42/CUI_CEM-1201_42.step

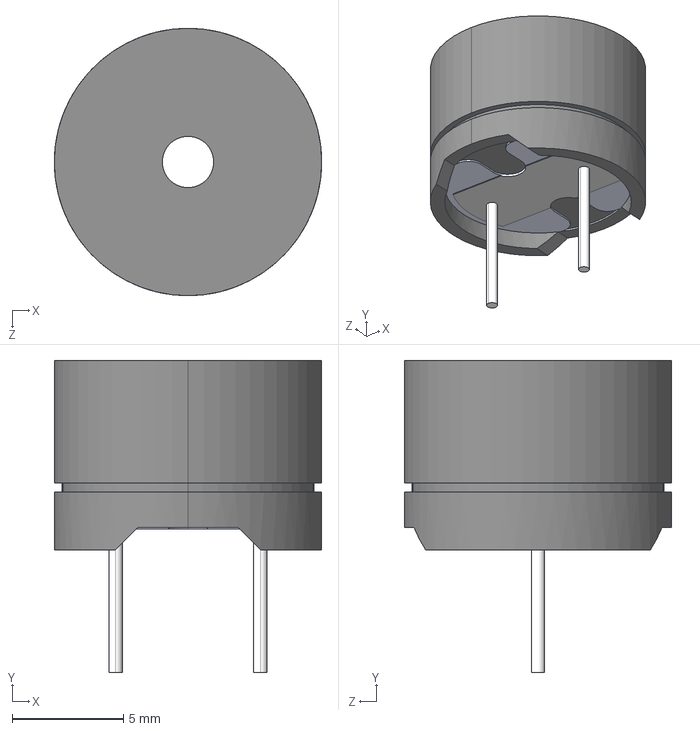
[picture p104: CAD file, 2023-08-27]
hard/2312_Composants/CEM-1201_42/CUI_CEM-1201_42.step
12.0 x 14.0 x 12.0 mm
