Miguel-SLO/2312_BadgePlace/hard/2312_Composants/CRJ011-ML3-TH/CUI_DEVICES_CRJ011-ML3-TH.step

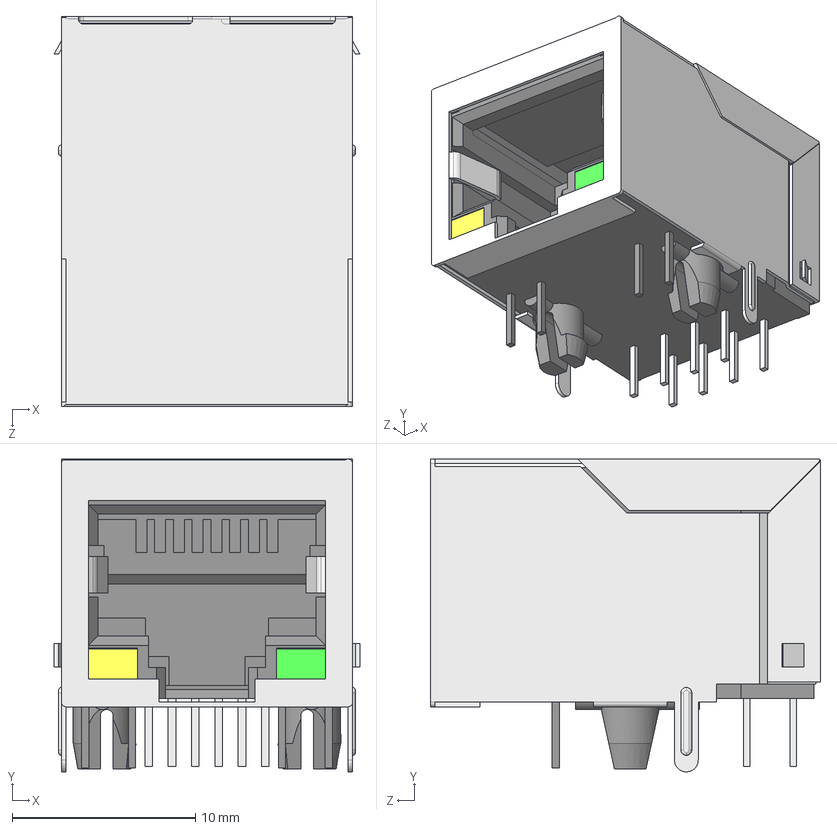
[picture p105: CAD file, 2023-08-26]
hard/2312_Composants/CRJ011-ML3-TH/CUI_DEVICES_CRJ011-ML3-TH.step
16.7 x 17.1 x 21.3 mm
