Miguel-SLO/2312_BadgePlace/hard/2312_Composants/CUI_CMT-0904-83T/CMT-0904-83T.step

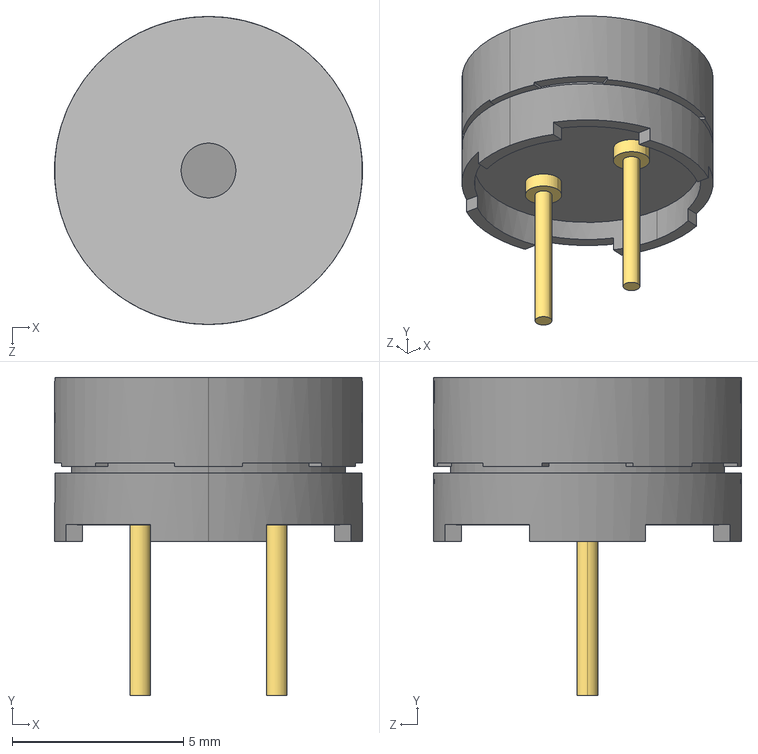
[picture p106: CAD file, 2023-08-27]
hard/2312_Composants/CUI_CMT-0904-83T/CMT-0904-83T.step
9.00 x 9.30 x 9.00 mm
