Miguel-SLO/2312_BadgePlace/hard/2312_Composants/ESP32-C3-WROOM-02-N4/ESP32-C3-WROOM-02-N4.stp

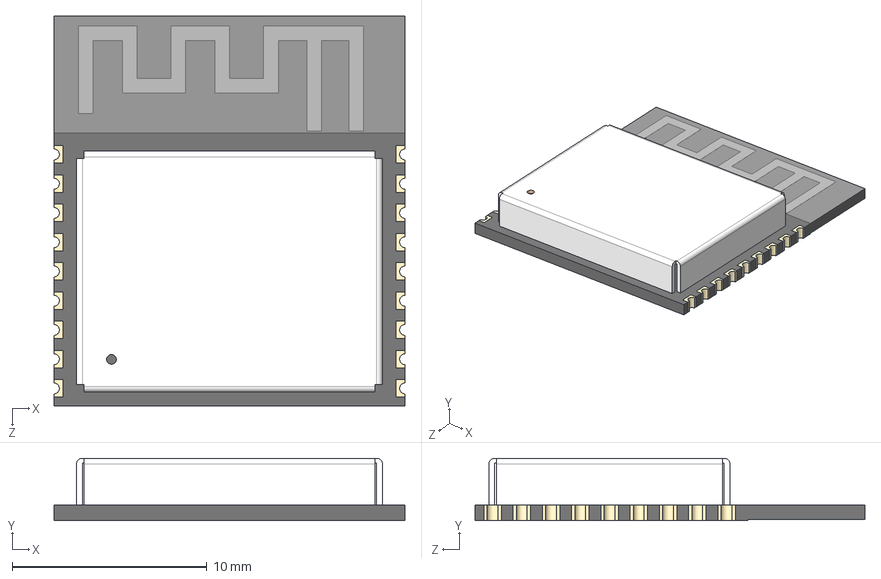
[picture p107: CAD file, 2023-08-27]
hard/2312_Composants/ESP32-C3-WROOM-02-N4/ESP32-C3-WROOM-02-N4.stp
18.0 x 3.20 x 20.0 mm
