Miguel-SLO/2312_BadgePlace/hard/2312_Composants/LAN8720A-CP-TR-ABC/QFN24-6X6_MC_MCH.step

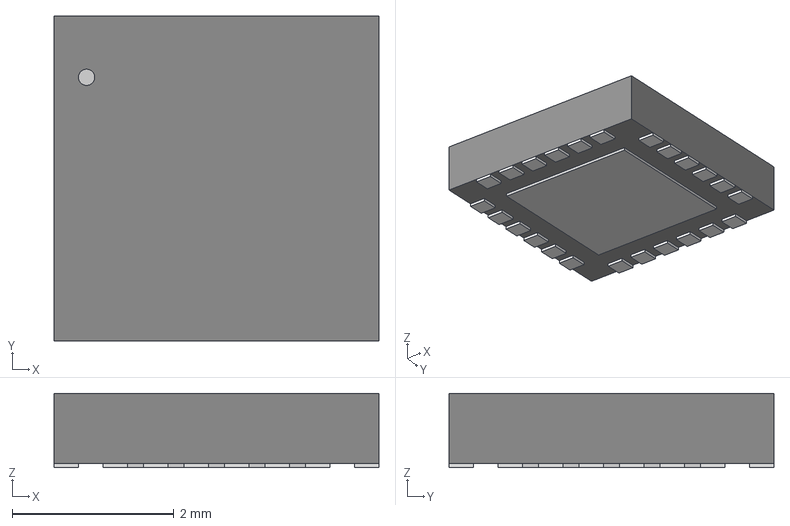
[picture p108: CAD file, 2023-08-26]
hard/2312_Composants/LAN8720A-CP-TR-ABC/QFN24-6X6_MC_MCH.step
4.01 x 4.01 x 0.917 mm
