Miguel-SLO/2312_BadgePlace/hard/2312_Composants/MBR0580S1-7/MBR0580S1-7_DIO.step

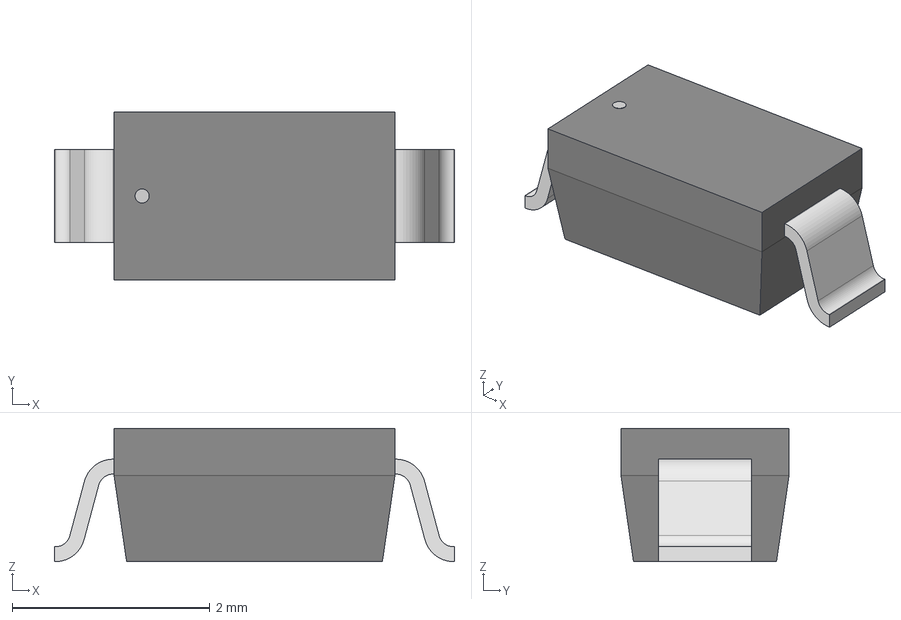
[picture p109: CAD file, 2023-08-27]
hard/2312_Composants/MBR0580S1-7/MBR0580S1-7_DIO.step
4.05 x 1.70 x 1.35 mm
