Miguel-SLO/2312_BadgePlace/hard/2312_Composants/MMBTA06-7-F/SOT23.stp

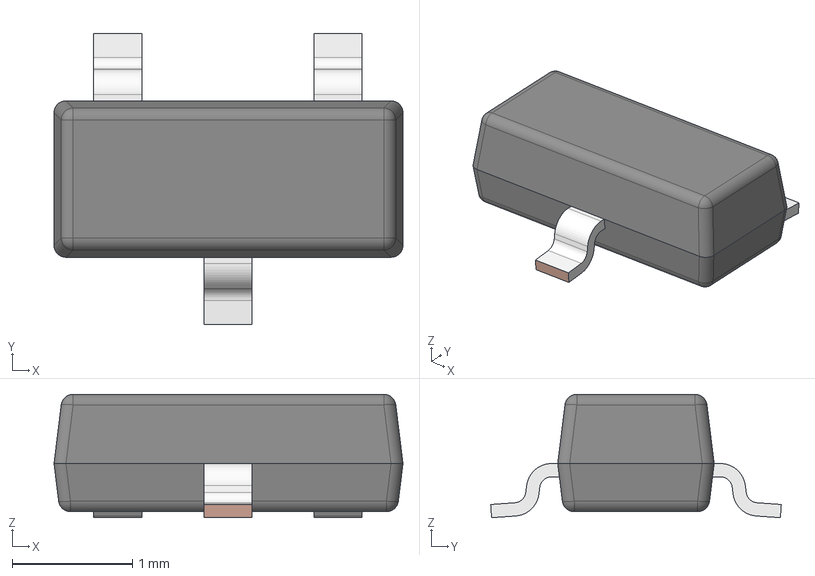
[picture p110: CAD file, 2023-08-27]
hard/2312_Composants/MMBTA06-7-F/SOT23.stp
2.90 x 2.42 x 1.03 mm
CP01
CP02
LDF
