Miguel-SLO/2312_BadgePlace/hard/2312_Composants/PIC32MX795F512H-80I-PT/TQFP64_10x10MC_MCH.step

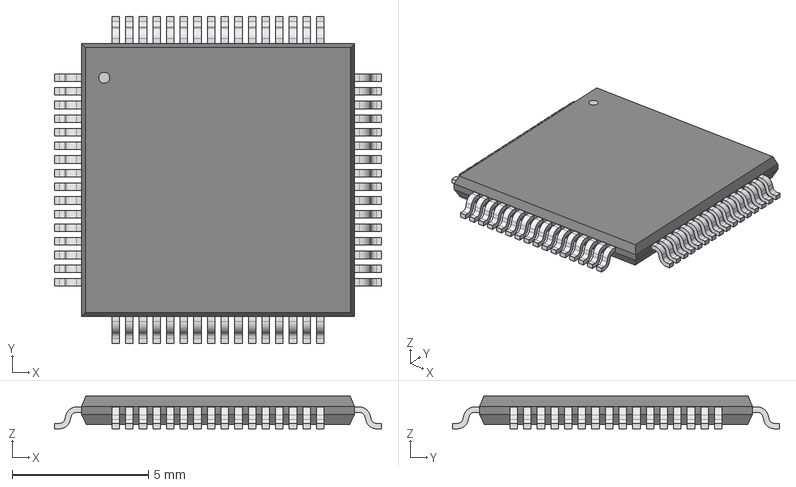
[picture p111: CAD file, 2023-08-26]
hard/2312_Composants/PIC32MX795F512H-80I-PT/TQFP64_10x10MC_MCH.step
12.0 x 12.0 x 1.20 mm
