Miguel-SLO/2312_BadgePlace/hard/2312_Composants/RAC05-3.3SK/RAC05-3.3SK.STEP

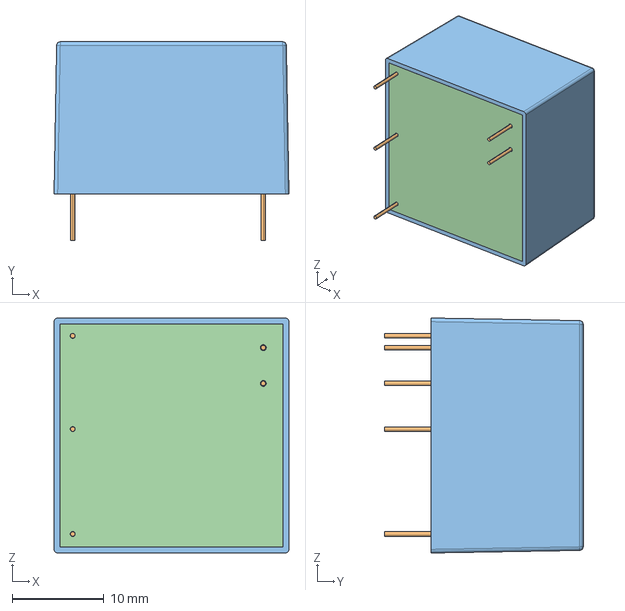
[picture p112: CAD file, 2023-08-25]
hard/2312_Composants/RAC05-3.3SK/RAC05-3.3SK.STEP
25.6 x 21.6 x 25.6 mm
