Miguel-SLO/2312_BadgePlace/hard/2312_Composants/TLC5973D/D0008A.stp

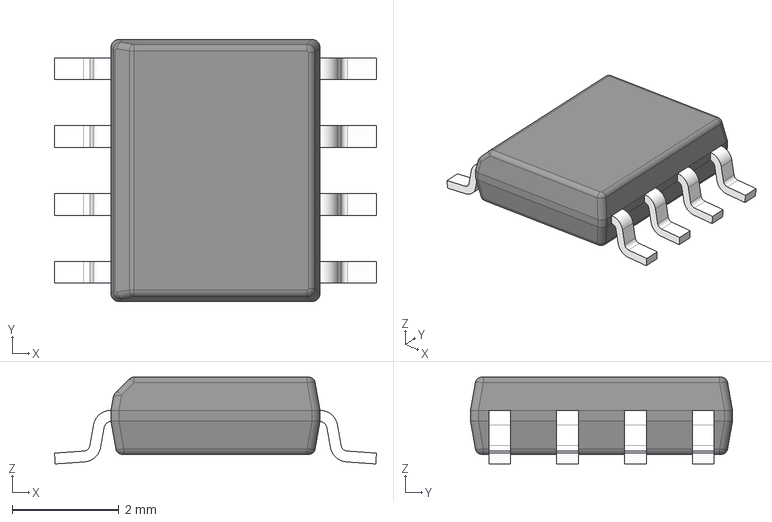
[picture p113: CAD file, 2023-08-27]
hard/2312_Composants/TLC5973D/D0008A.stp
6.02 x 4.90 x 1.63 mm
BODY-SO
LEAD-D0008A x 8
