Miguel-SLO/2312_BadgePlace/hard/2312_Boitier/2312_Case-2312_Top.3mf

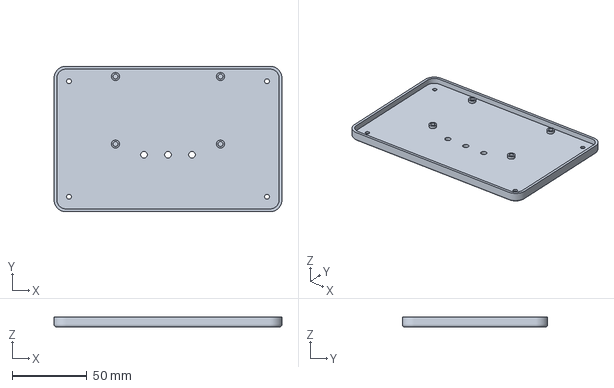
[picture p115: CAD file, 2023-10-04]
hard/2312_Boitier/2312_Case-2312_Top.3mf
152.0 x 97.0 x 7.00 mm
