Miguel-SLO/2312_BadgePlace/hard/2312_Composants/#_STEP-EXTERNE/Chilli_UART-B1.step

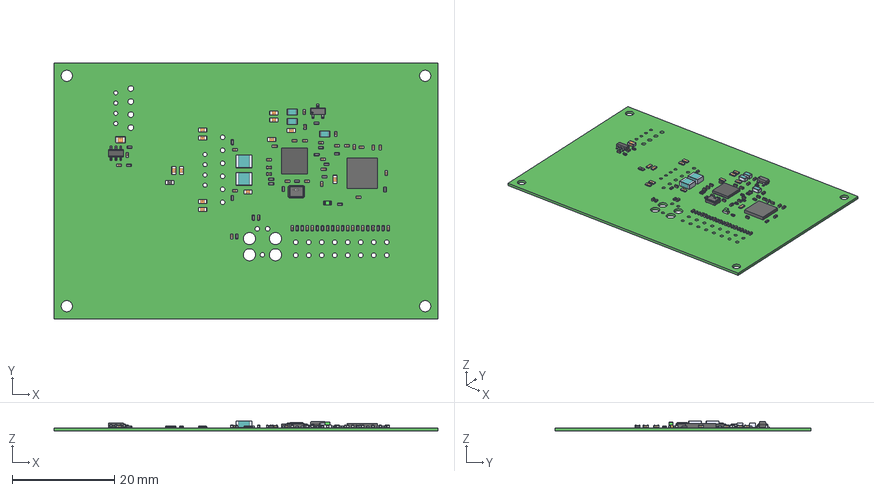
[picture p116: CAD file, 2023-08-31]
hard/2312_Composants/#_STEP-EXTERNE/Chilli_UART-B1.step
75.0 x 50.0 x 2.04 mm
Board
User_Library-Chip_Resistor2 x 28
cap_0402 x 39
User_Library-SOT457_body
User_Library-SOT457_pin x 6
User_Library-0805_SMD_Capacitor
User_Library-0603_SMD_Capacitor(1) x 12
User_Library-Chip_Inductor_(3) x 3
User_Library-0603_SMD_Resistor
User_Library-MAX9984
User_Library-ABM8G
User_Library-SOT23-3
Extruded
User_Library-led0603_GRE
