Miguel-SLO/2312_BadgePlace/hard/2312_Boitier/2312_BadgePlace_3D/2312_Top_case.stl

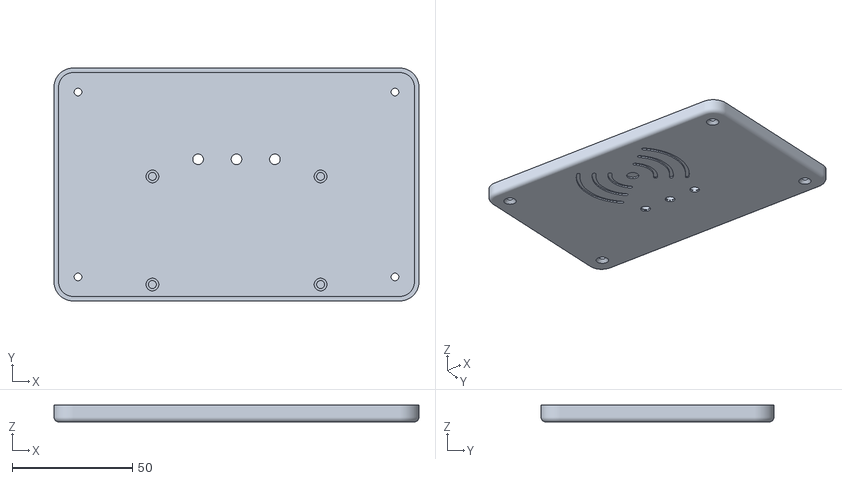
[picture p117: CAD file, 2023-09-27]
hard/2312_Boitier/2312_BadgePlace_3D/2312_Top_case.stl
152.0 x 97.0 x 7.00
