Miguel-SLO/2312_BadgePlace/hard/2312_Boitier/2312_Case-2312_Holder.3mf

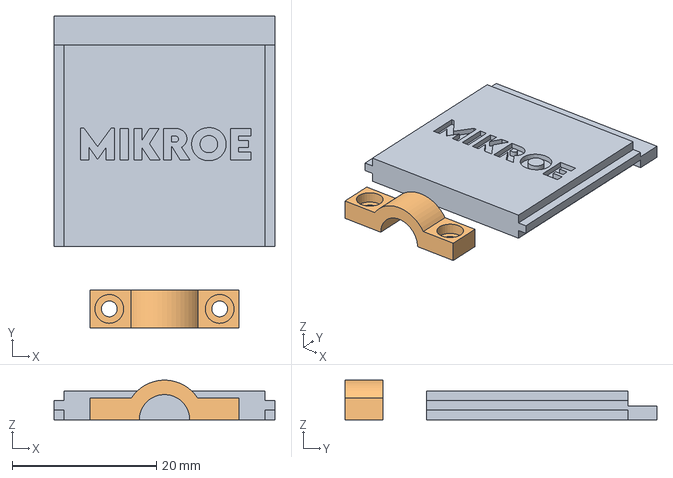
[picture p118: CAD file, 2023-09-28]
hard/2312_Boitier/2312_Case-2312_Holder.3mf
30.6 x 43.2 x 5.49 mm
2312_Case-2312_Mikroe.stl
2312_Case-2312_Holder.stl
