Miguel-SLO/2312_BadgePlace/hard/2312_Boitier/2312_BadgePlace_3D/2312_Cable_holder.stl

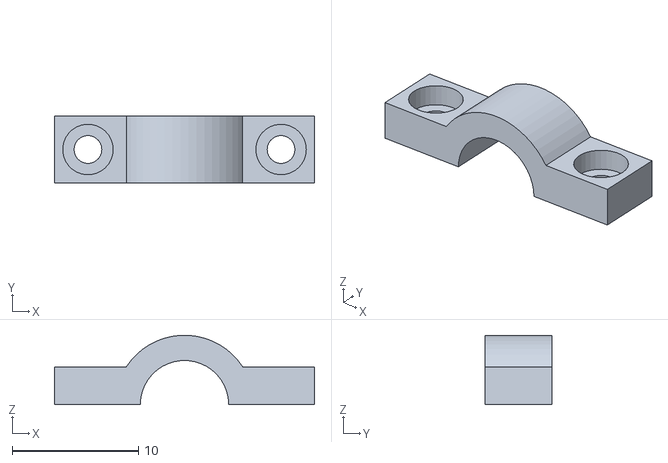
[picture p119: CAD file, 2023-09-27]
hard/2312_Boitier/2312_BadgePlace_3D/2312_Cable_holder.stl
20.6 x 5.30 x 5.49
