Miguel-SLO/2312_BadgePlace/hard/2312_Boitier/2312_Case-2312_Mikroe.stl

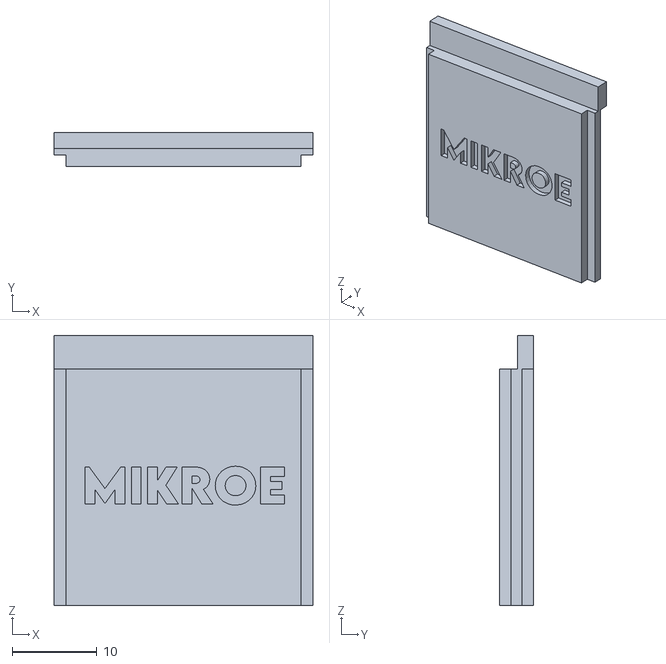
[picture p120: CAD file, 2023-09-27]
hard/2312_Boitier/2312_Case-2312_Mikroe.stl
30.6 x 4.00 x 31.9
