Miguel-SLO/2312_BadgePlace/(list of files, cad)

Other CAD files:
hard/2312_Boitier/2312_Case-2312_Bottom.3mf
hard/2312_Boitier/2312_Case-2312_Bottom.stl
hard/2312_Boitier/2312_Case-2312_Holder.stl
hard/2312_Boitier/2312_Case-2312_Top.stl
