Miguel-SLO/2312_BadgePlace/doc/rapport/Rendu final/2312_BadgePlace_Schematiques.pdf

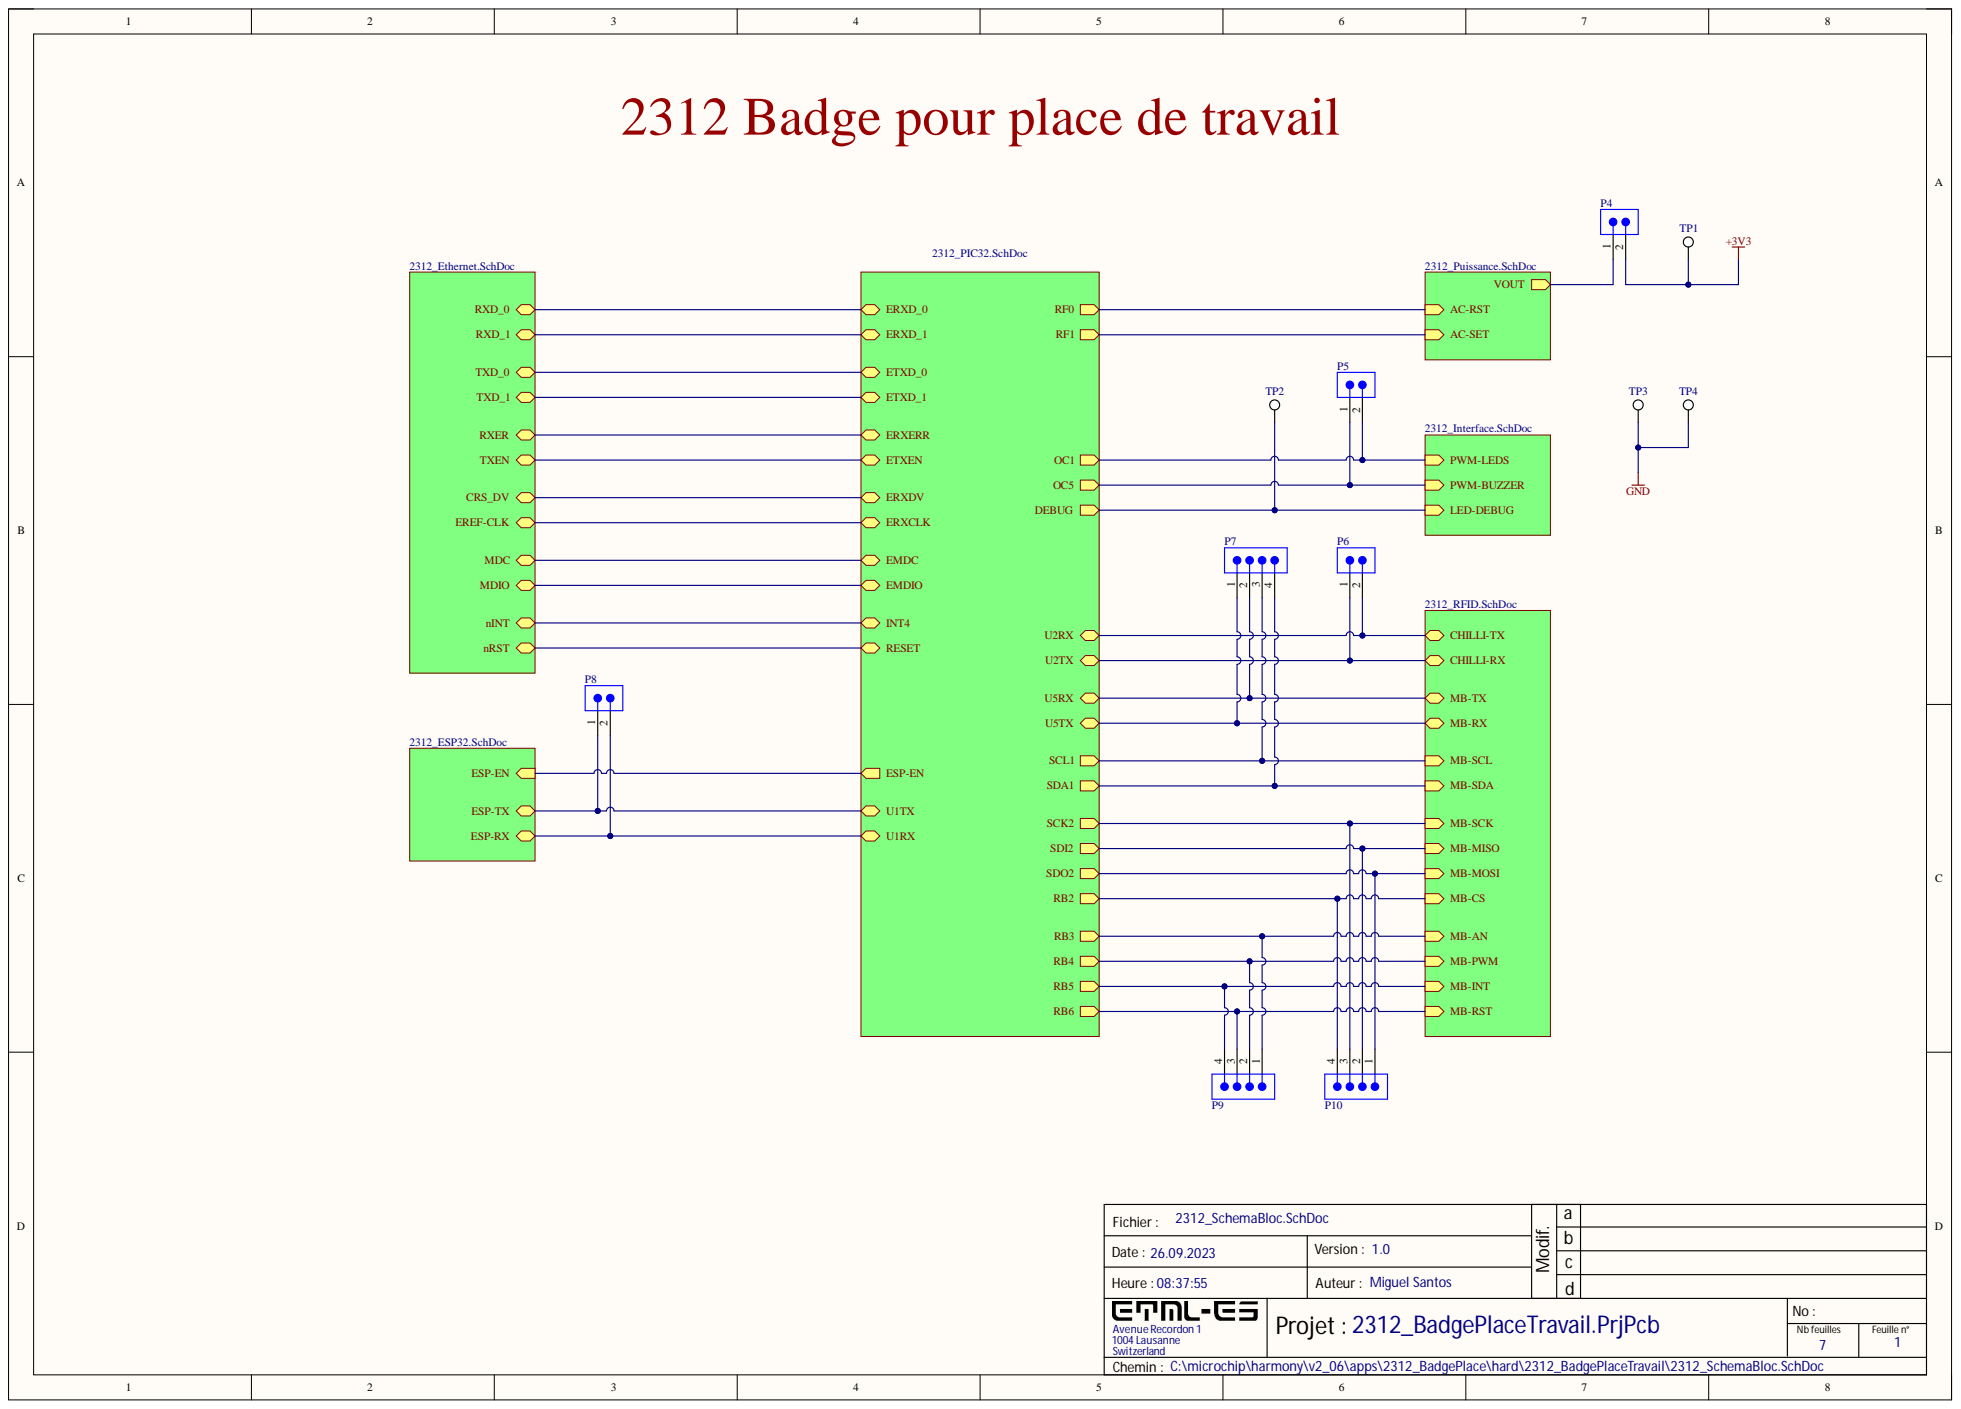
[picture p125: page 1]

2312 Badge pour place de travail

2 3 1 2_SchemaBloc. SchDoc Fichie r :

abcd

Date : 2 6. 09. 2023 | Ve rsion : 1 . 0

H eure : 08: 3 7 : 55 | Auteur : Miguel Santos
Aven ue Reco rd o n La usa e Switzerland | Projet : 2312_BadgePlaceT ravail.PrjPcb | No

N b feuilles | Feuille n°

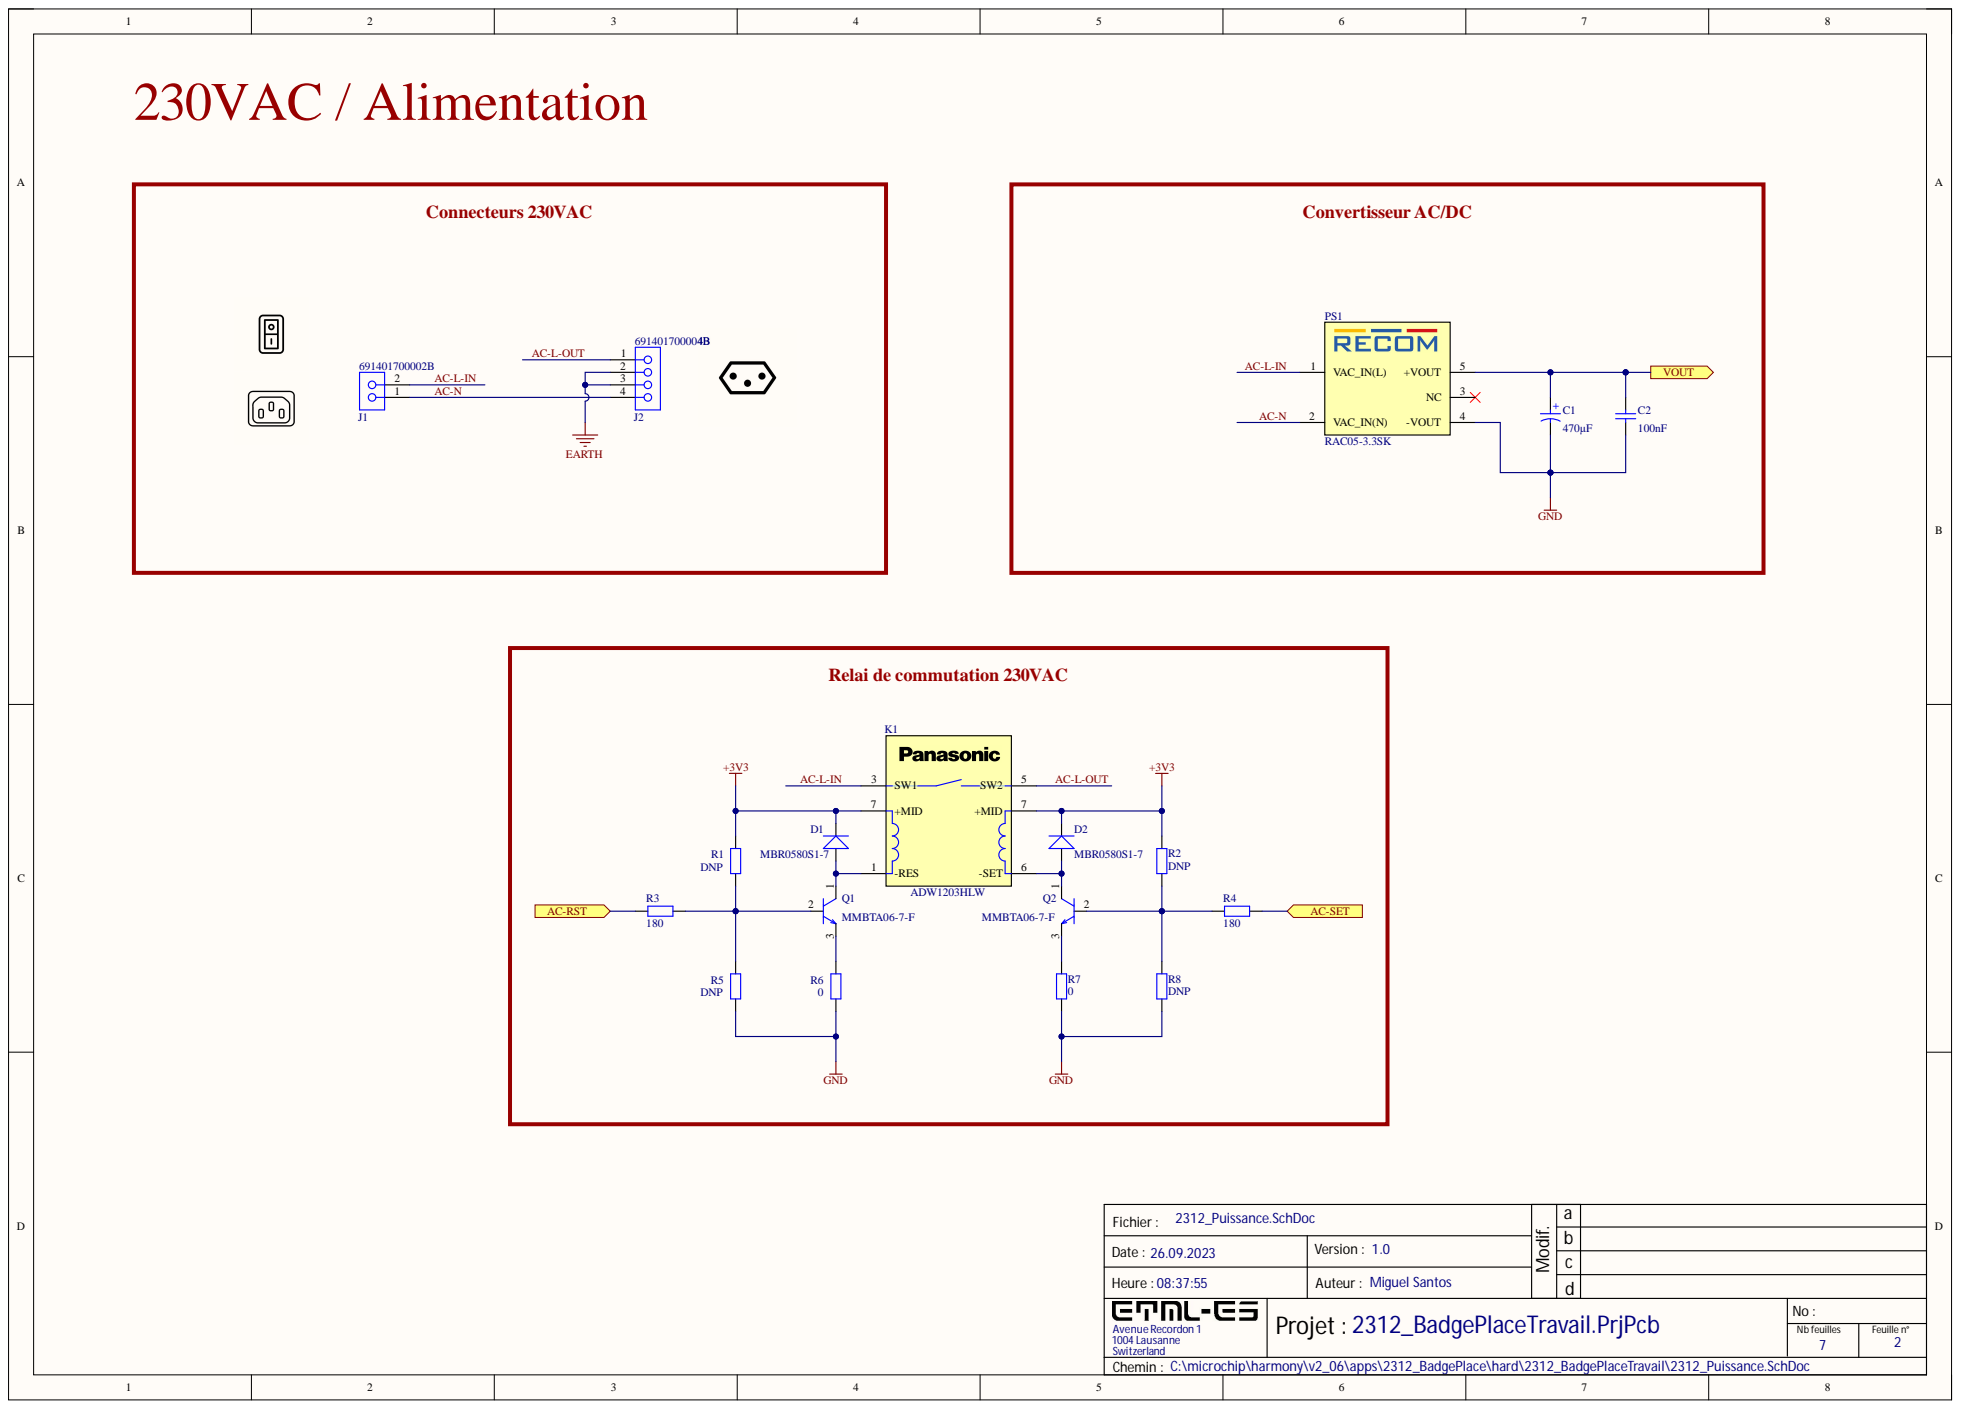
[picture p126: page 2]

2312_Puissance.SchDoc Fichier : | | a

Date : 26.09.2023 | Version : 1.0

Heure : 08:37:55 | Auteur : Miguel Santos
Avenue Recordon 1 1004 Lausanne Switzerland | Projet : 2312_BadgePlaceTravail.PrjPcb | No :

Nb feuilles | Feuille n°

Chemin : C:\microchip\harmony\v2_06\apps\2312_BadgePlace\hard\2312_BadgePlaceTravail\2312_Puissance.SchDoc

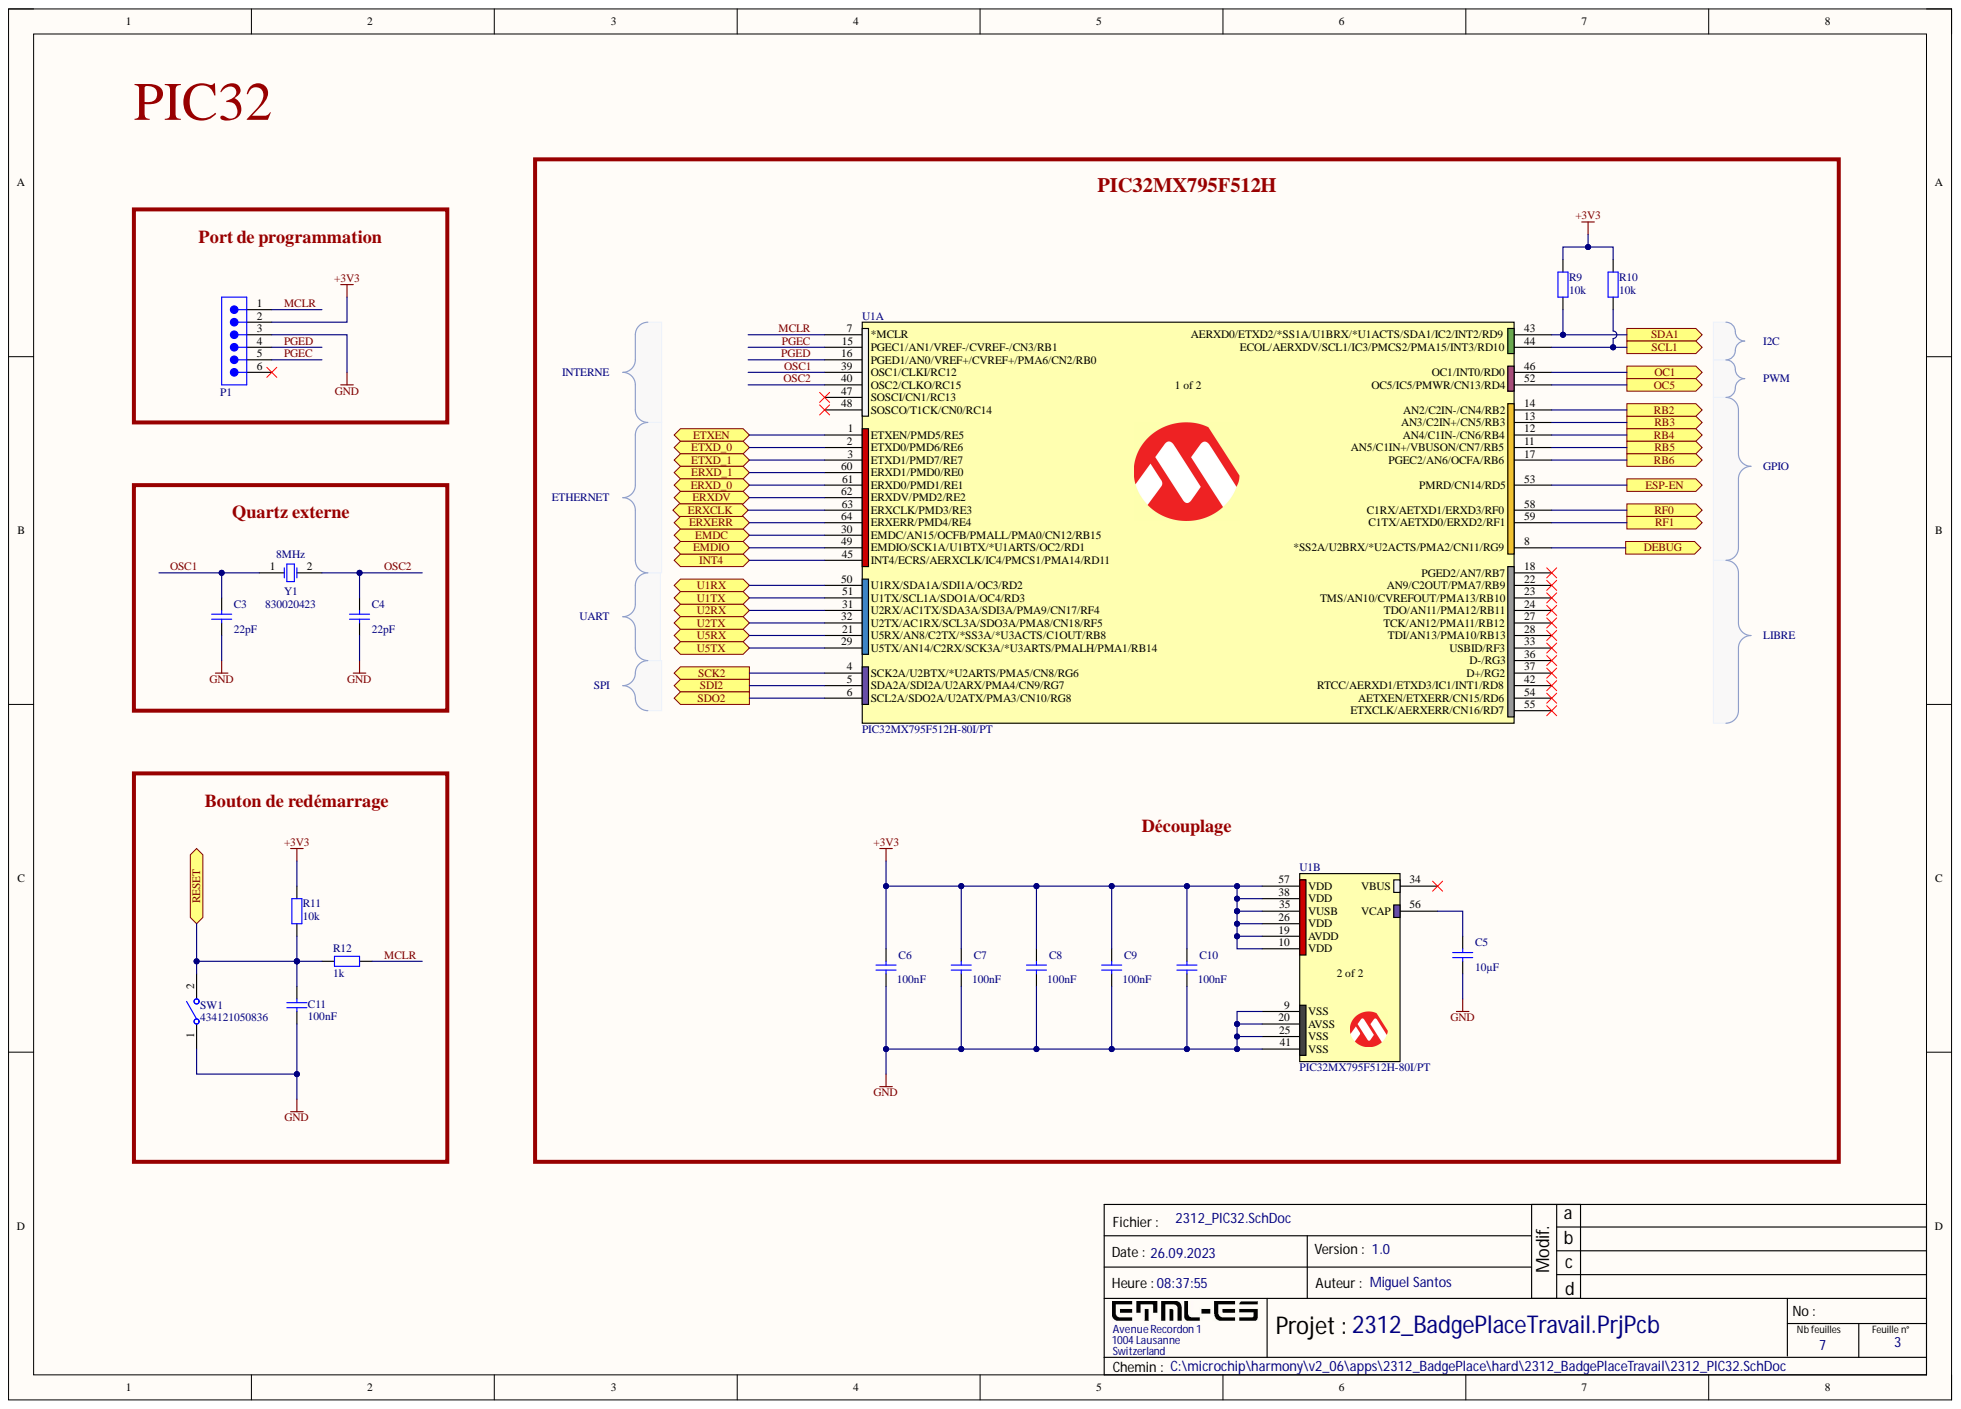
[picture p127: page 3]

2 3 1 2_PI C3 2 . SchDoc Fichie r :

abcd

Date : 2 6. 09. 2023 | Ve rsion : 1 . 0

H eure : 08: 3 7 : 55 | Auteur : Miguel Santos

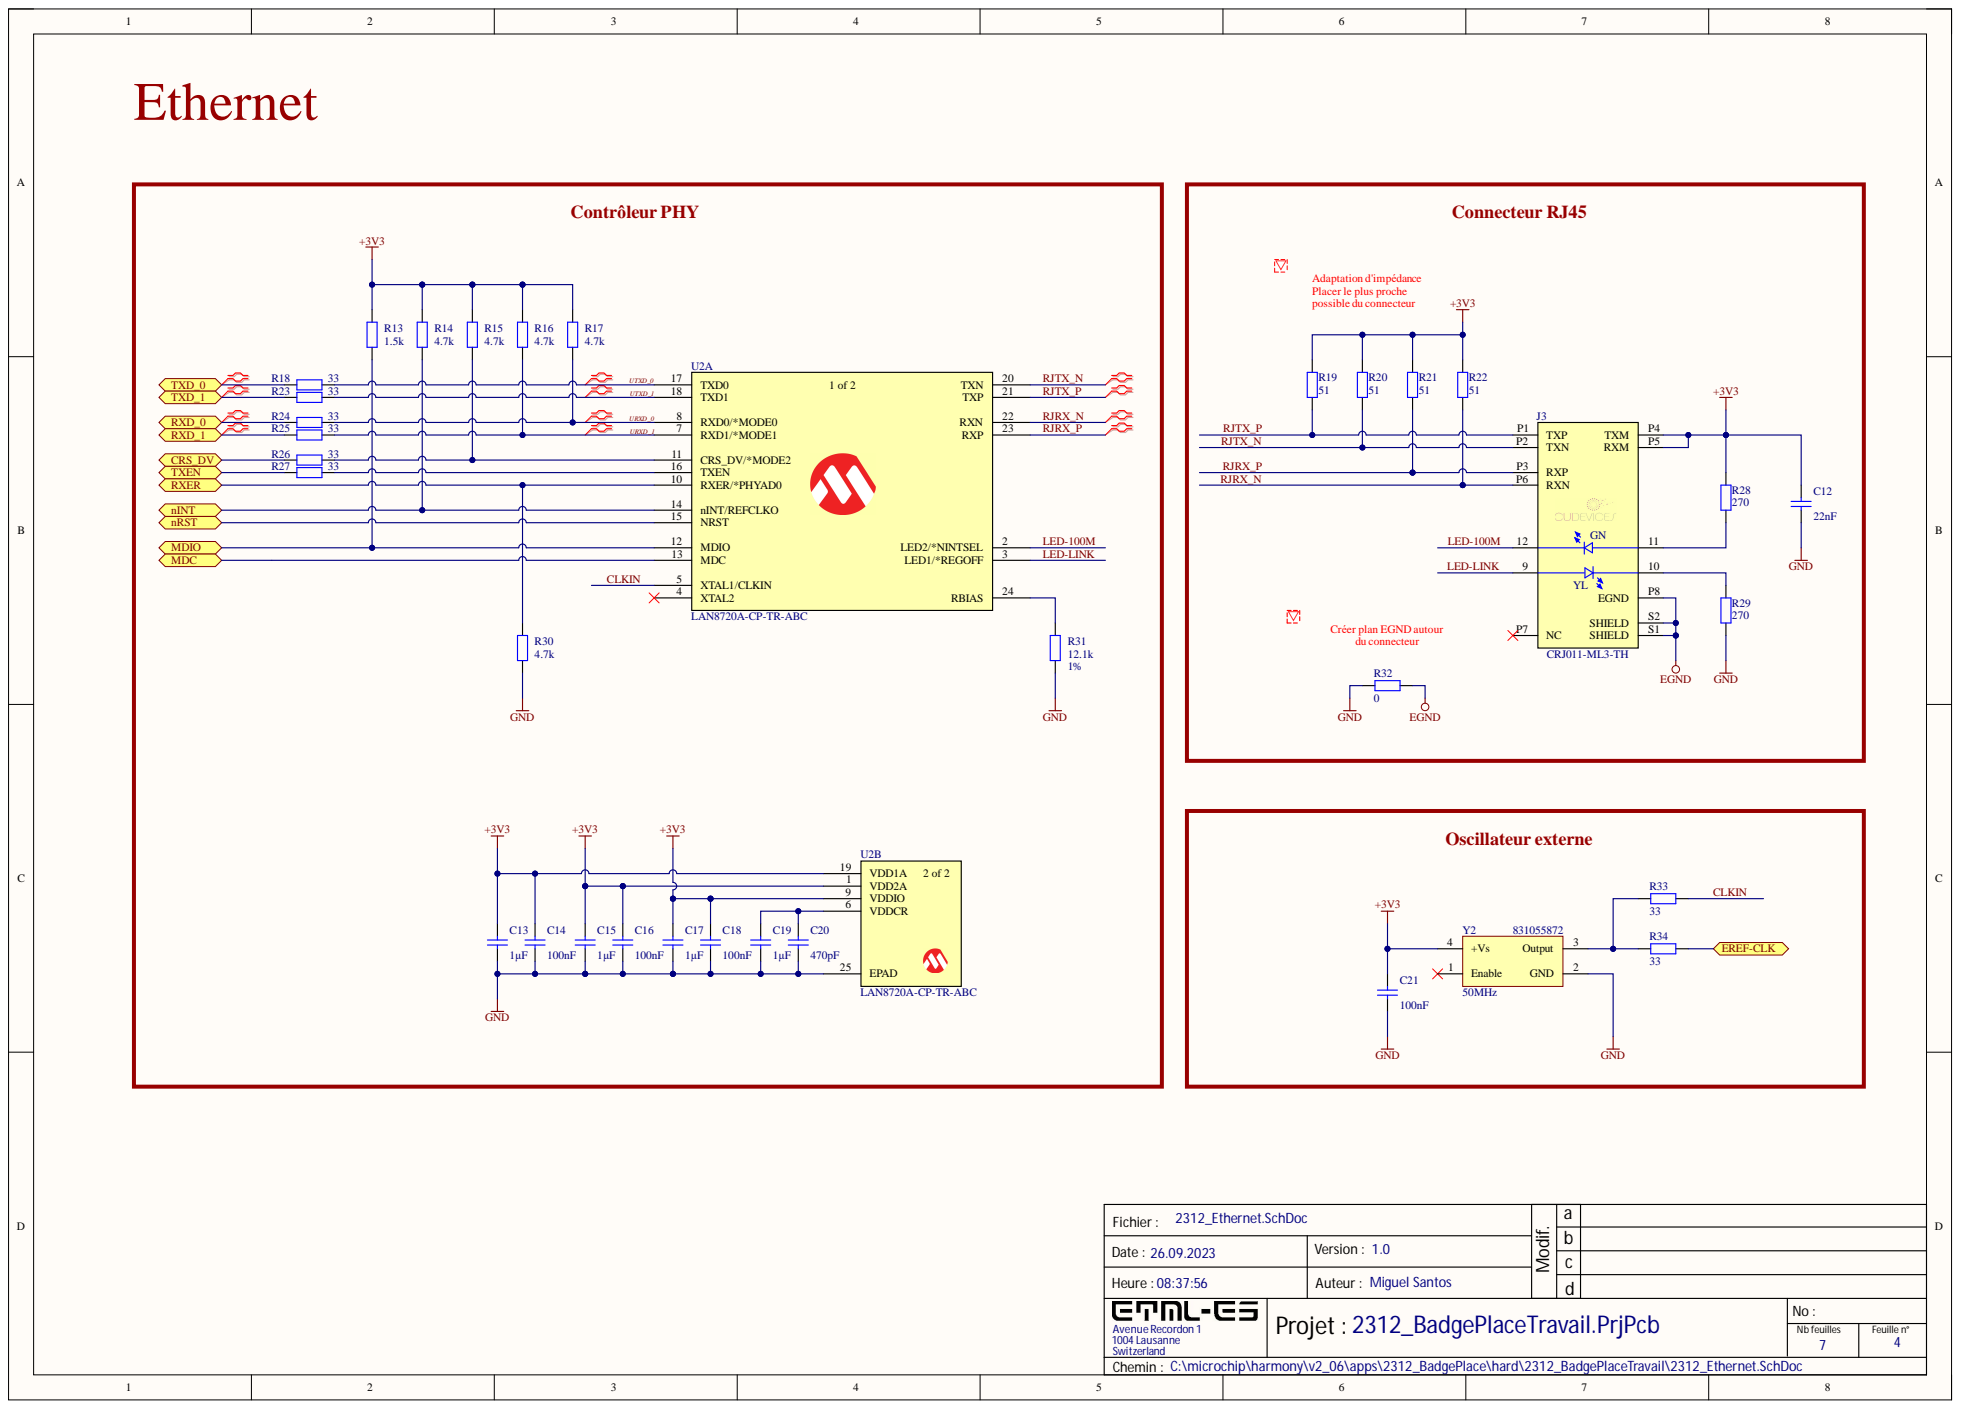
[picture p128: page 4]

Adaptation d'impédance
Placer le plus proche
possible du connecteur

nINT/REFCLKO 14
NRST 15

+3V3 | | MDIO 12

CLKIN | XTAL1/CLKIN 5

Créer plan EGND autour
du connecteur

2312_Ethernet.SchDoc Fichier : | | a

Date : 26.09.2023 | Version : 1.0

Heure : 08:37:56 | Auteur : Miguel Santos

Chemin : C:\microchip\harmony\v2_06\apps\2312_BadgePlace\hard\2312_BadgePlaceTravail\2312_Ethernet.SchDoc

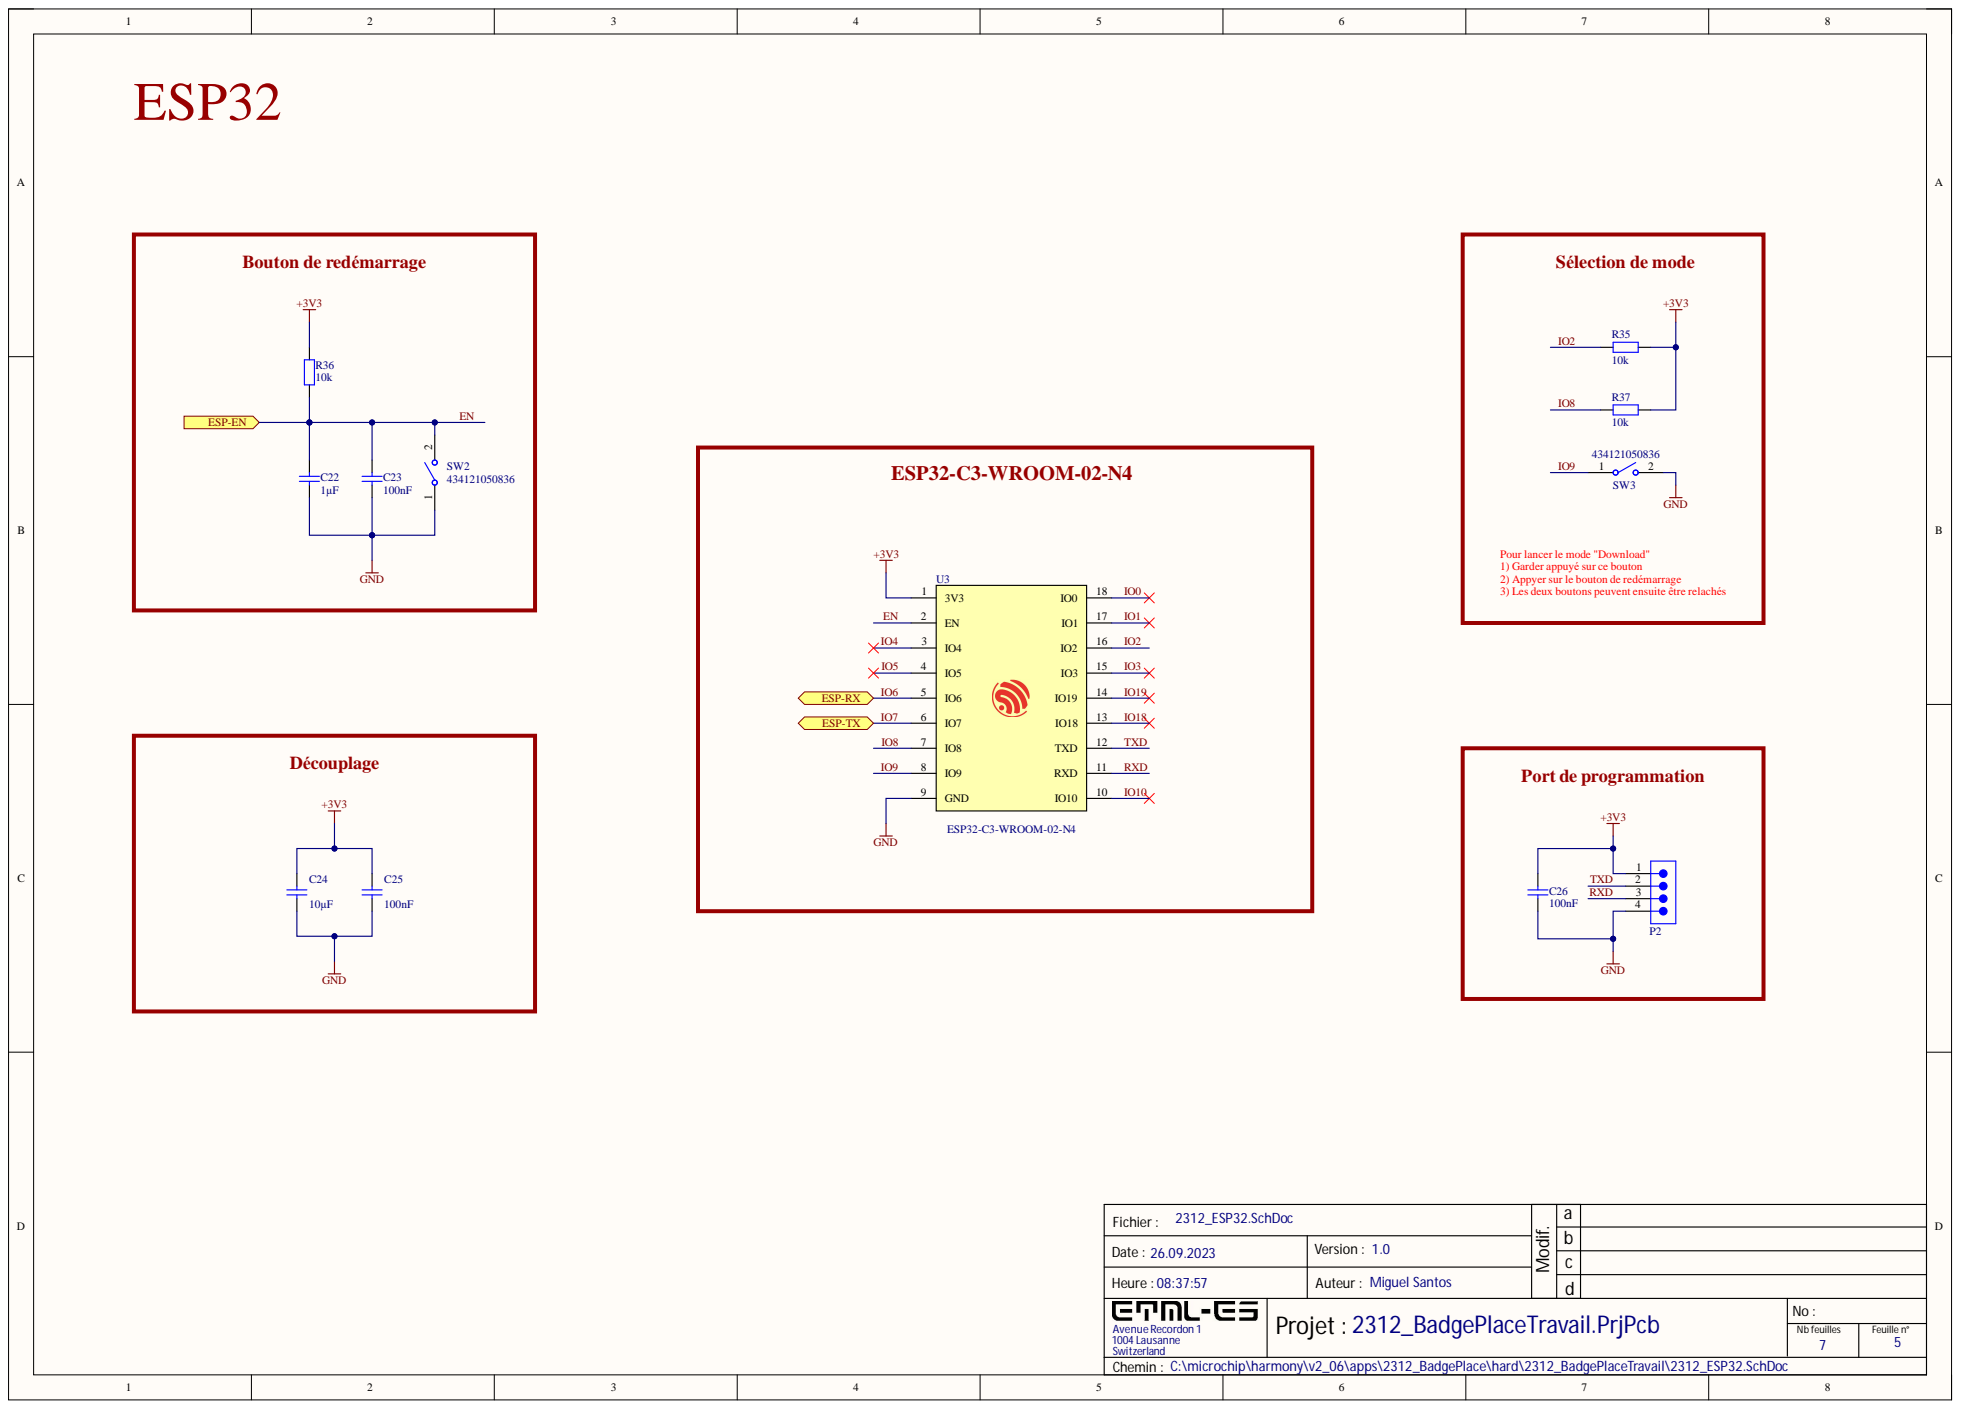
[picture p129: page 5]

lancer
Garder appuy
Appyer
Les deux boutons peuvent ensui

2 3 1 2_ESP3 2 . SchD oc Fichie r :

abcd

Date : 2 6. 09. 2023 | Ve rsion : 1 . 0

H eure : 08: 3 7 : 57 | Auteur : Miguel Santos

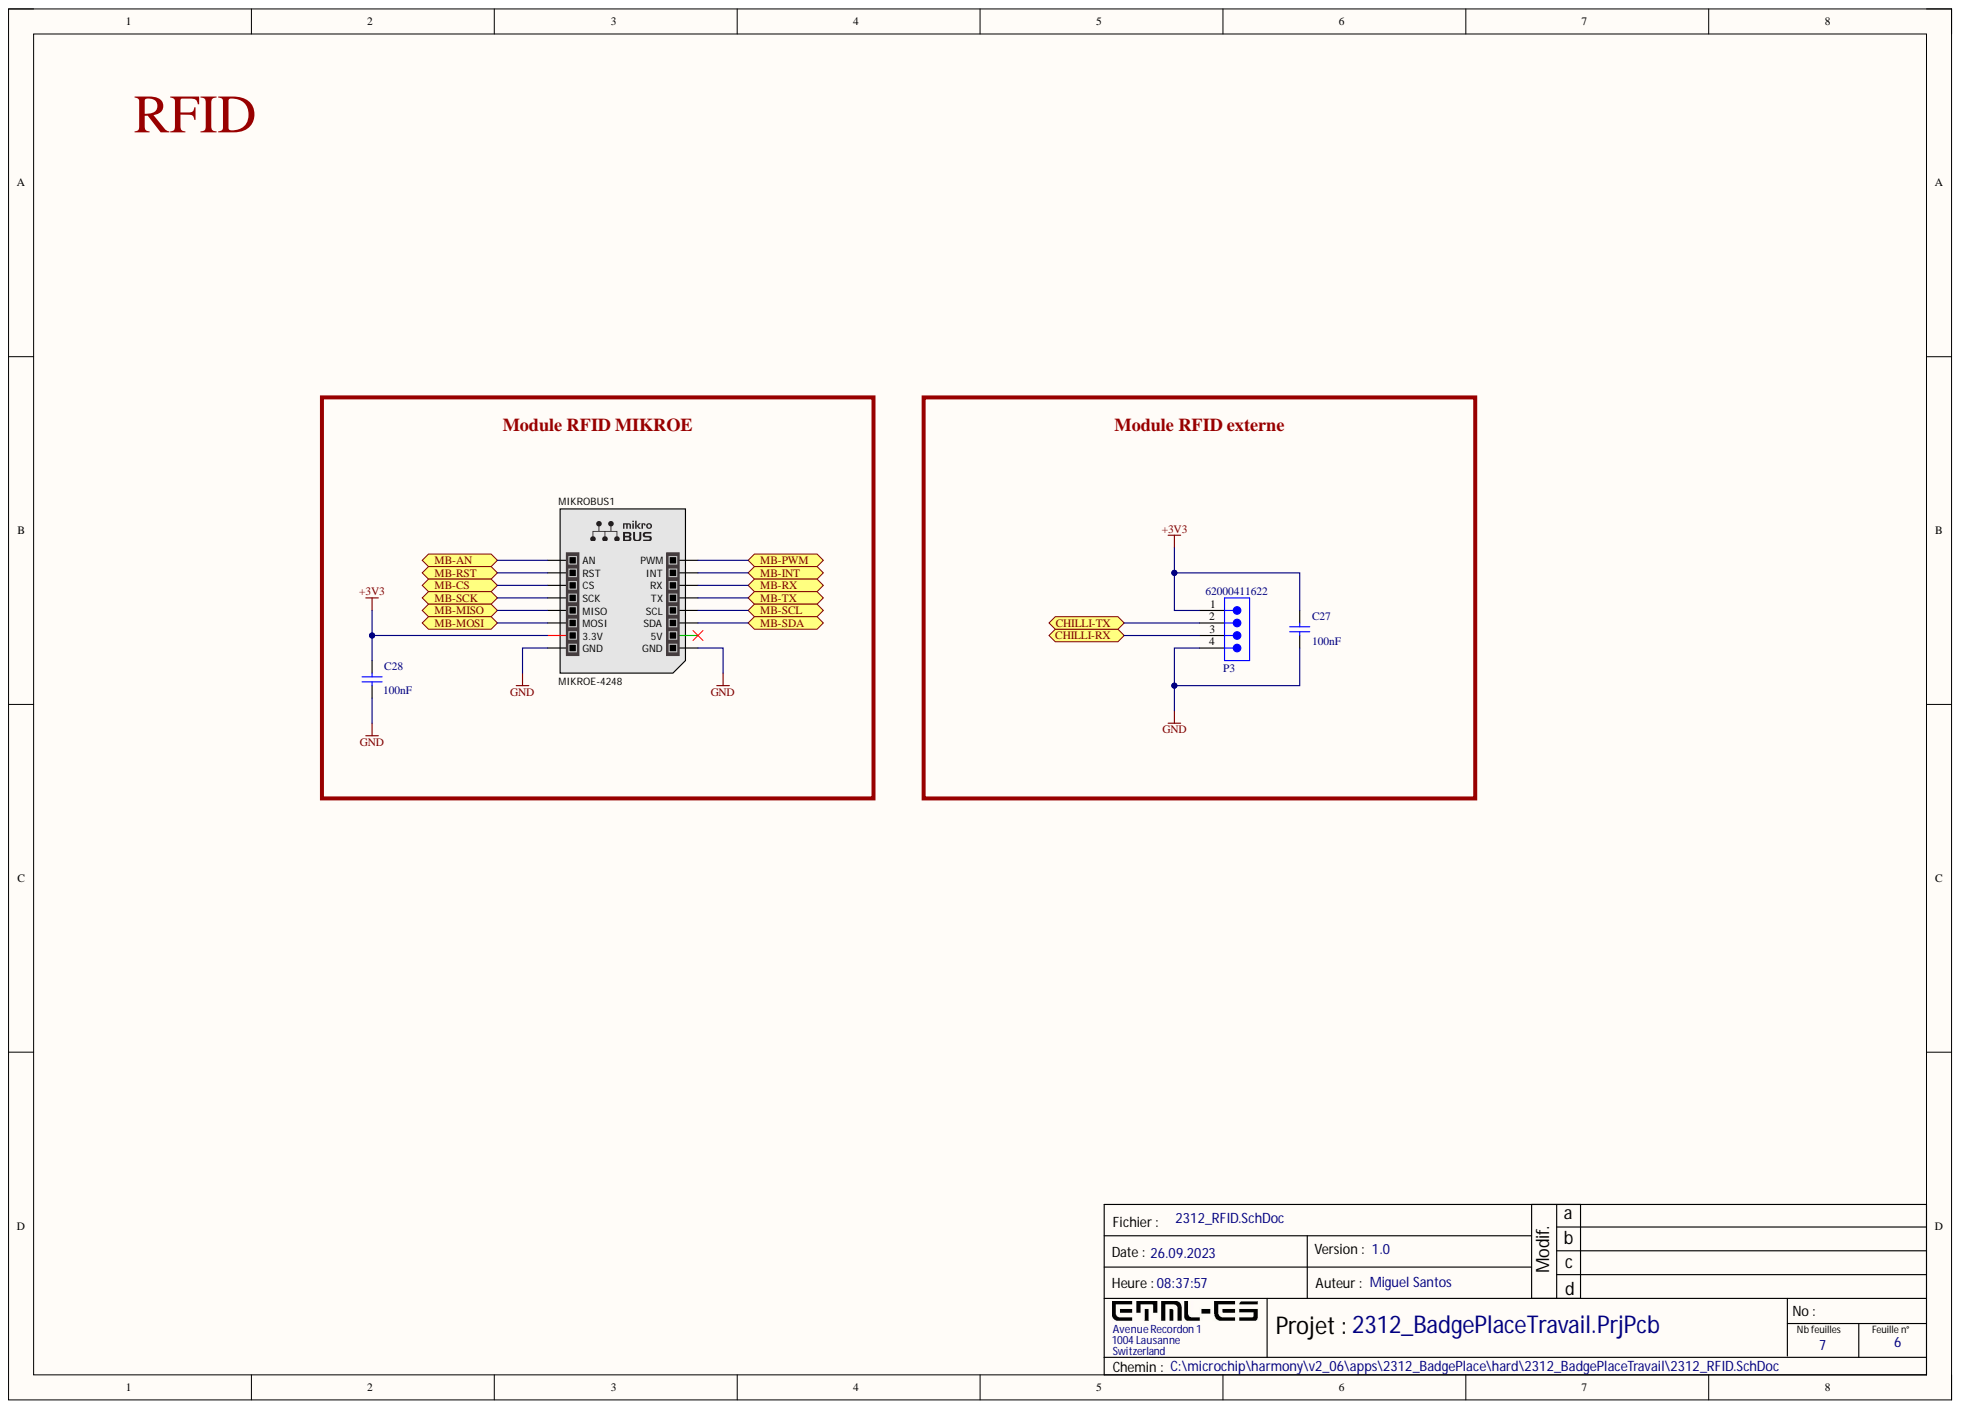
[picture p130: page 6]

2 3 1 2_R F I D . SchDoc Fichie r :

abcd

Date : 2 6. 09. 2023 | Ve rsion : 1 . 0

H eure : 08: 3 7 : 57 | Auteur : Miguel Santos

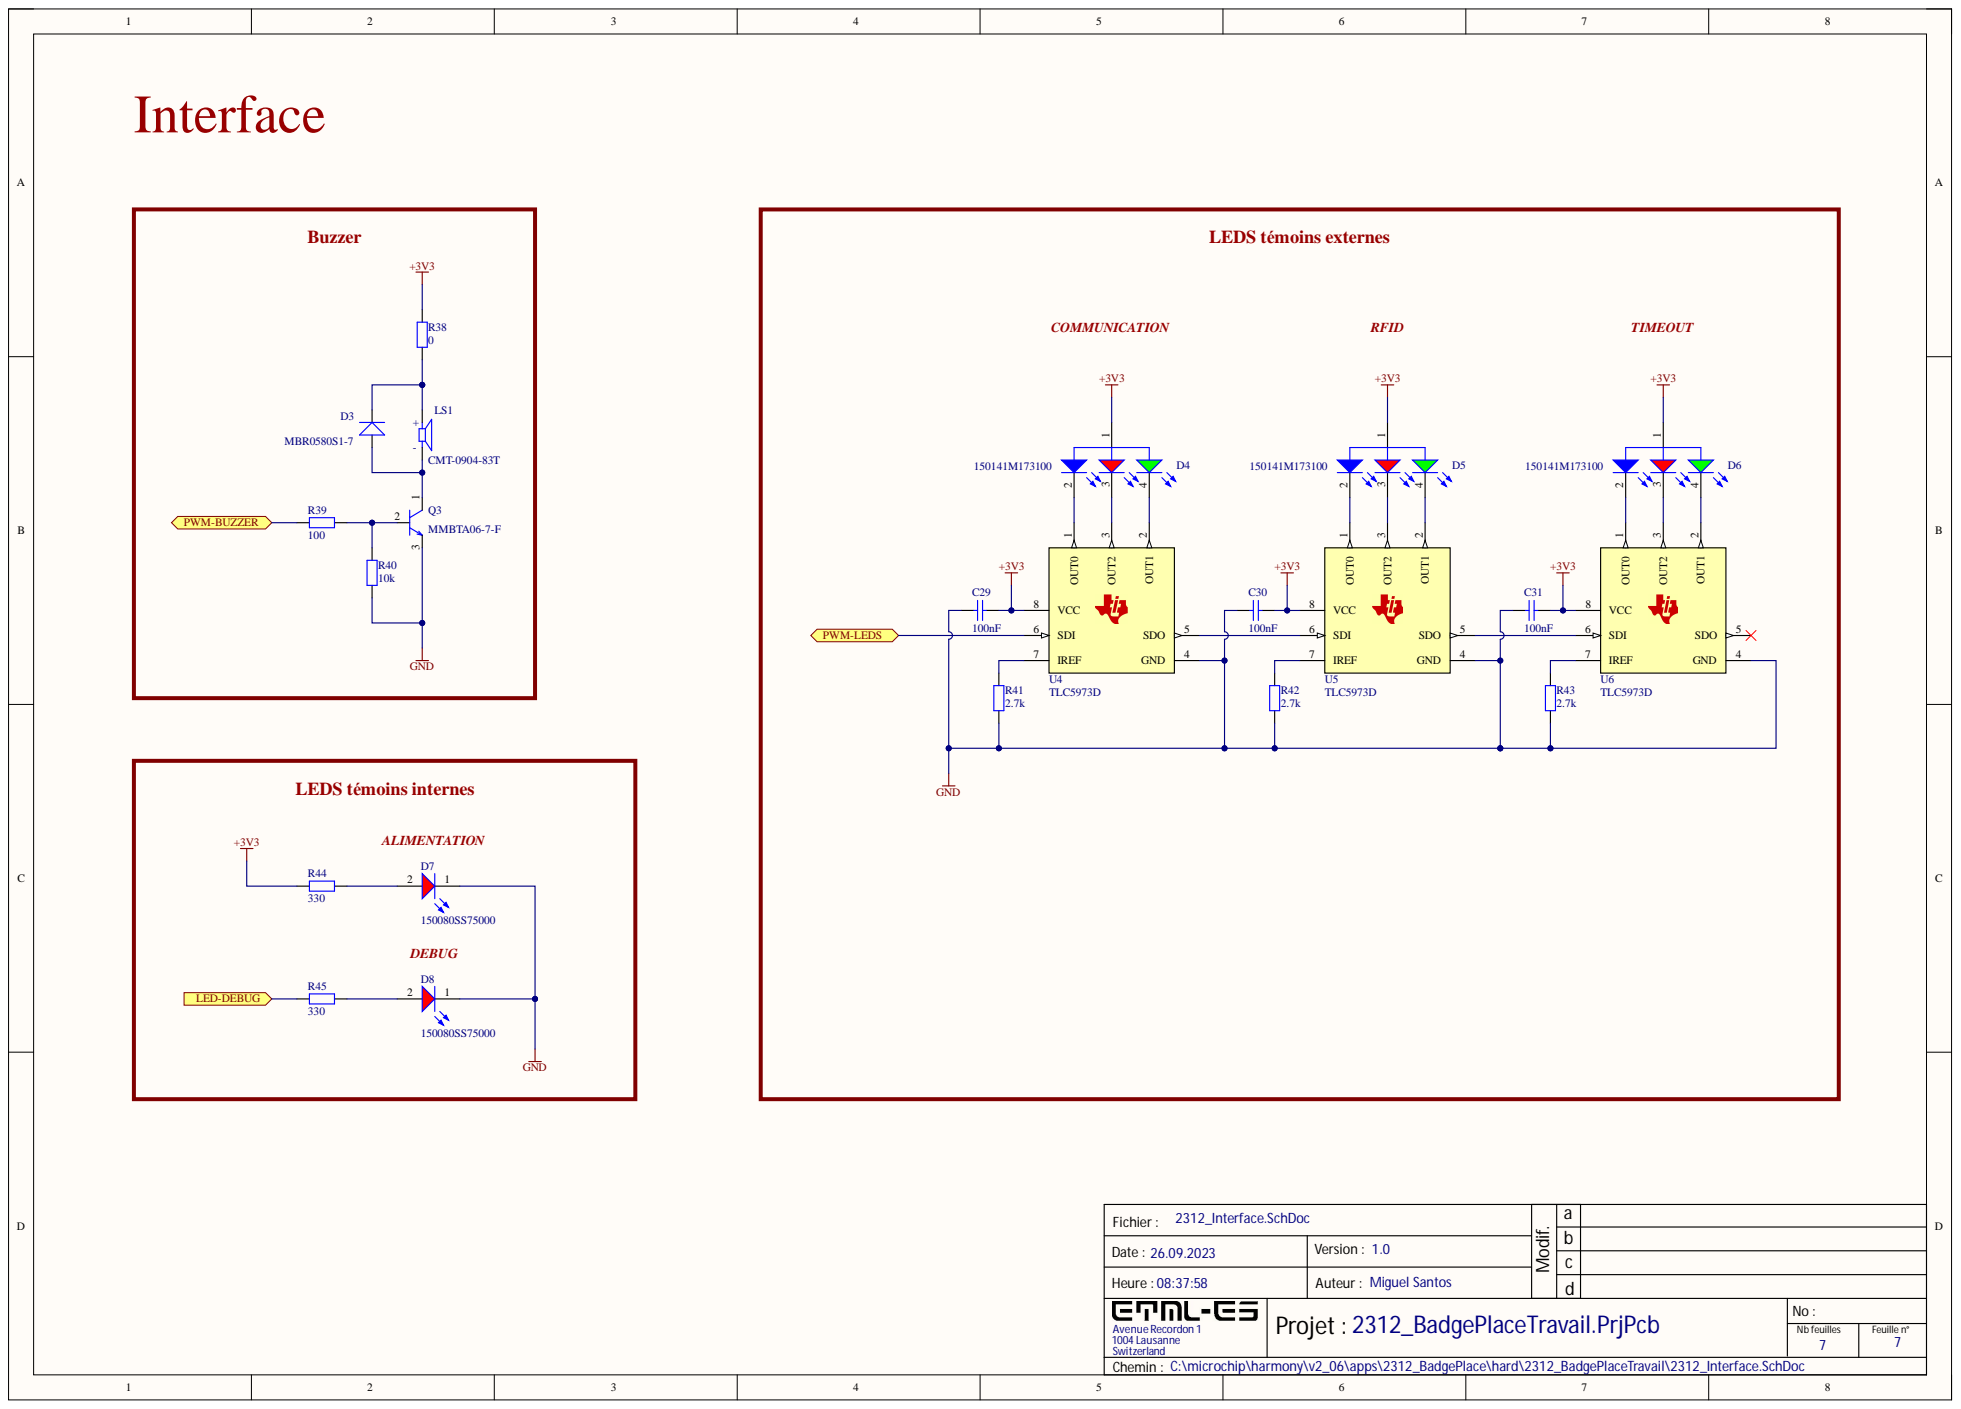
[picture p131: page 7]

2312_Interface.SchDoc Fichier : | | a

Date : 26.09.2023 | Version : 1.0

Heure : 08:37:58 | Auteur : Miguel Santos

Chemin : C:\microchip\harmony\v2_06\apps\2312_BadgePlace\hard\2312_BadgePlaceTravail\2312_Interface.SchDoc
