Miguel-SLO/2312_BadgePlace/hard/2312_BadgePlaceTravail/2312_BadgePlaceTravail.pdf

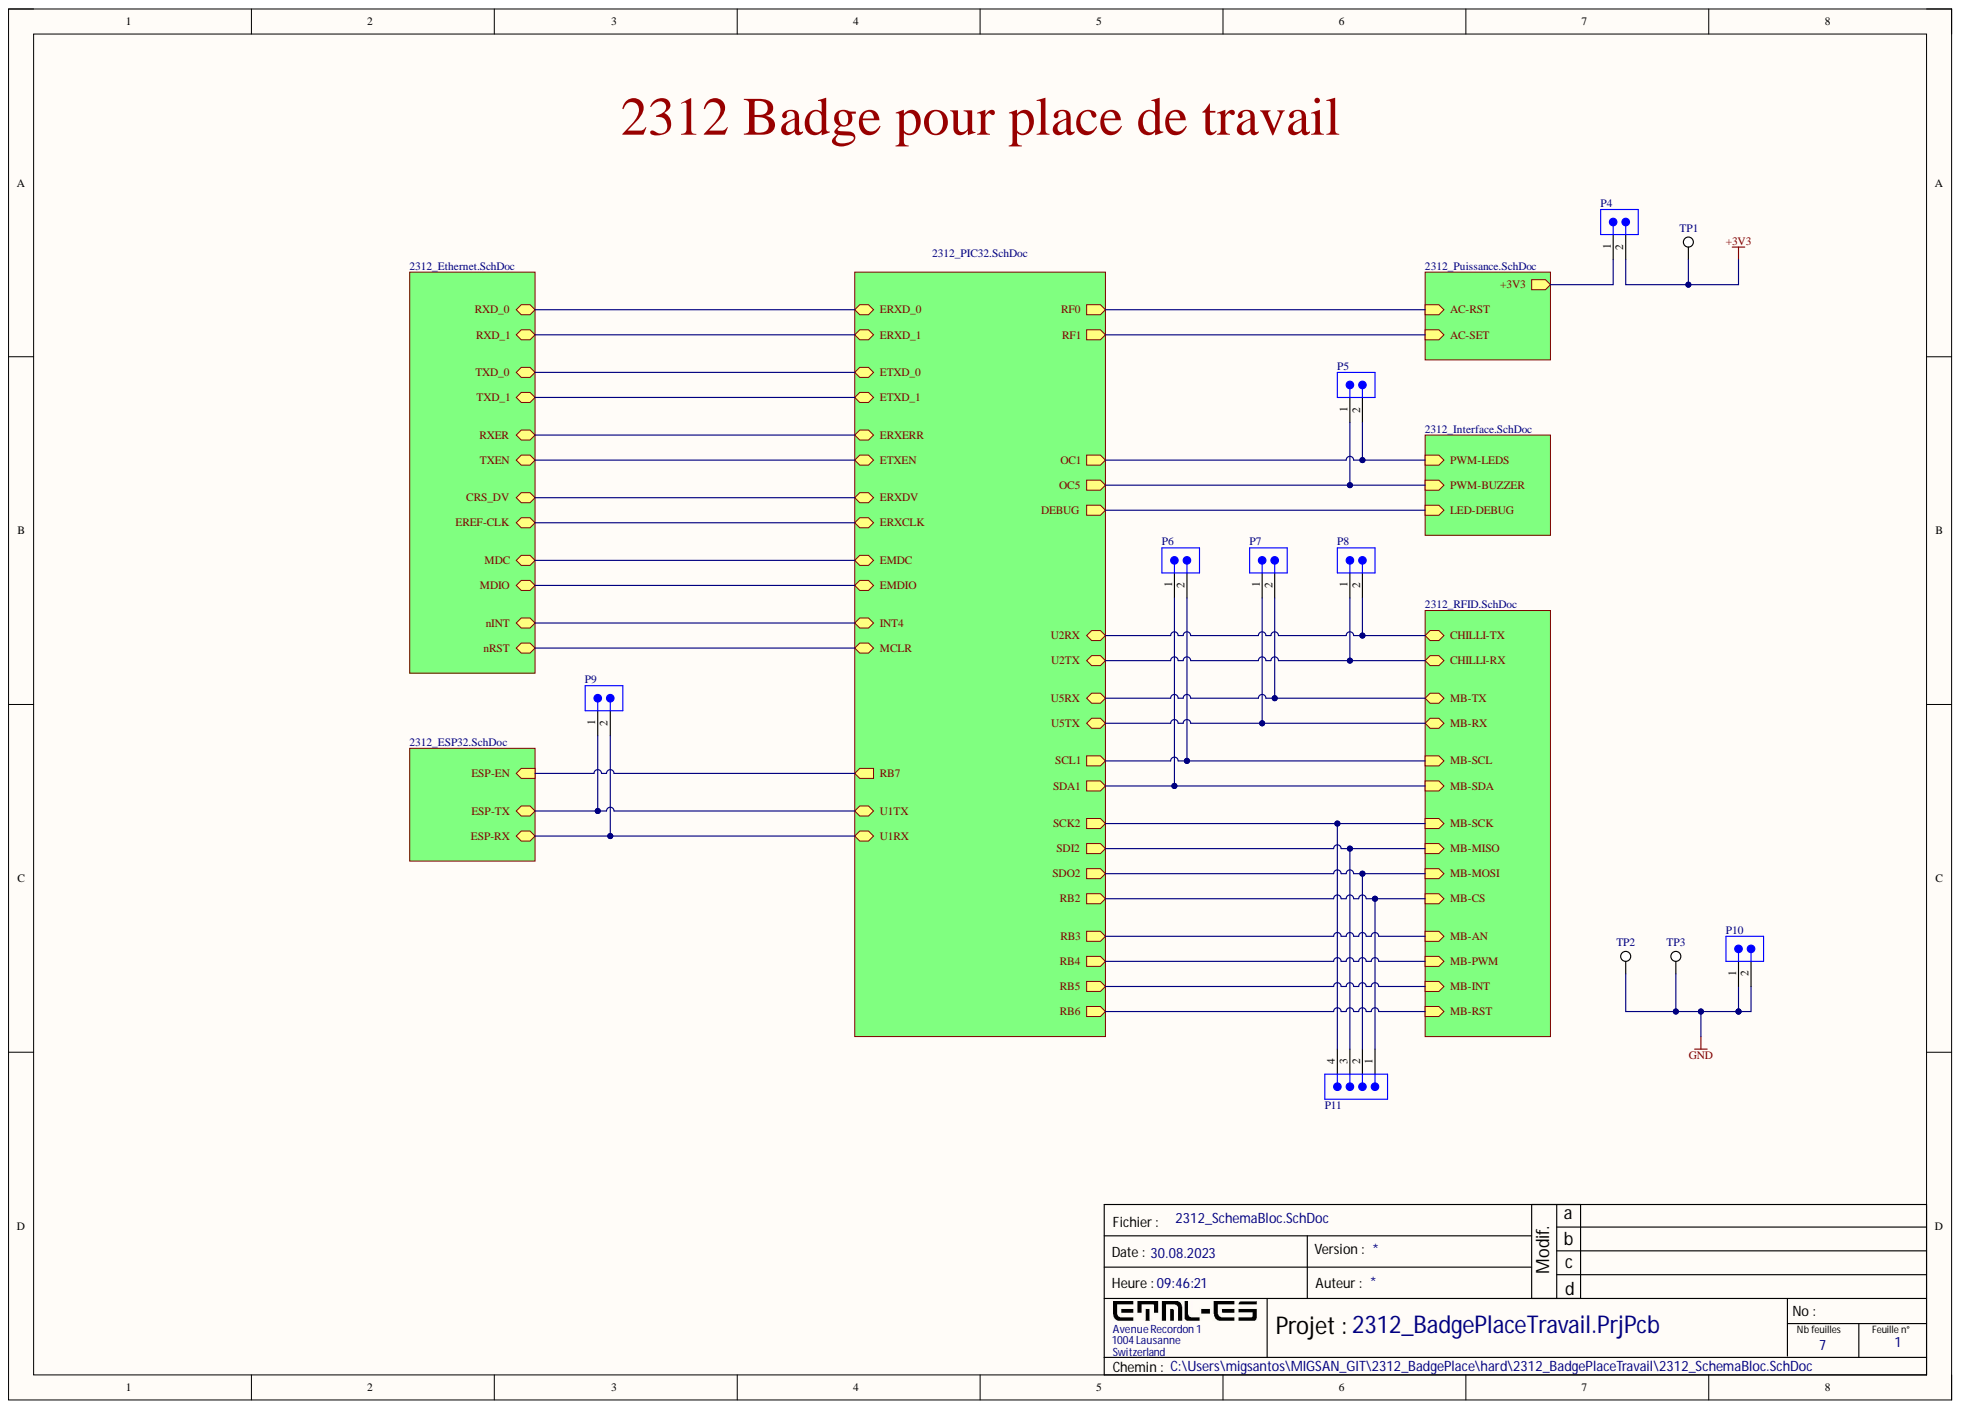
[picture p132: page 1]

2312 Badge pour place de travail

2 3 1 2_SchemaB loc. SchDoc F i chi e r :

abcd

Date : 30. 08. 2023 | Ve rsion : *

H eure : 09: 46: 21 | Auteur : *
Aven ue Reco rd o n La usa e Switzerland | Projet : 2312_BadgePlaceT ravail.PrjPcb | No

N b feuilles | Feuille n°

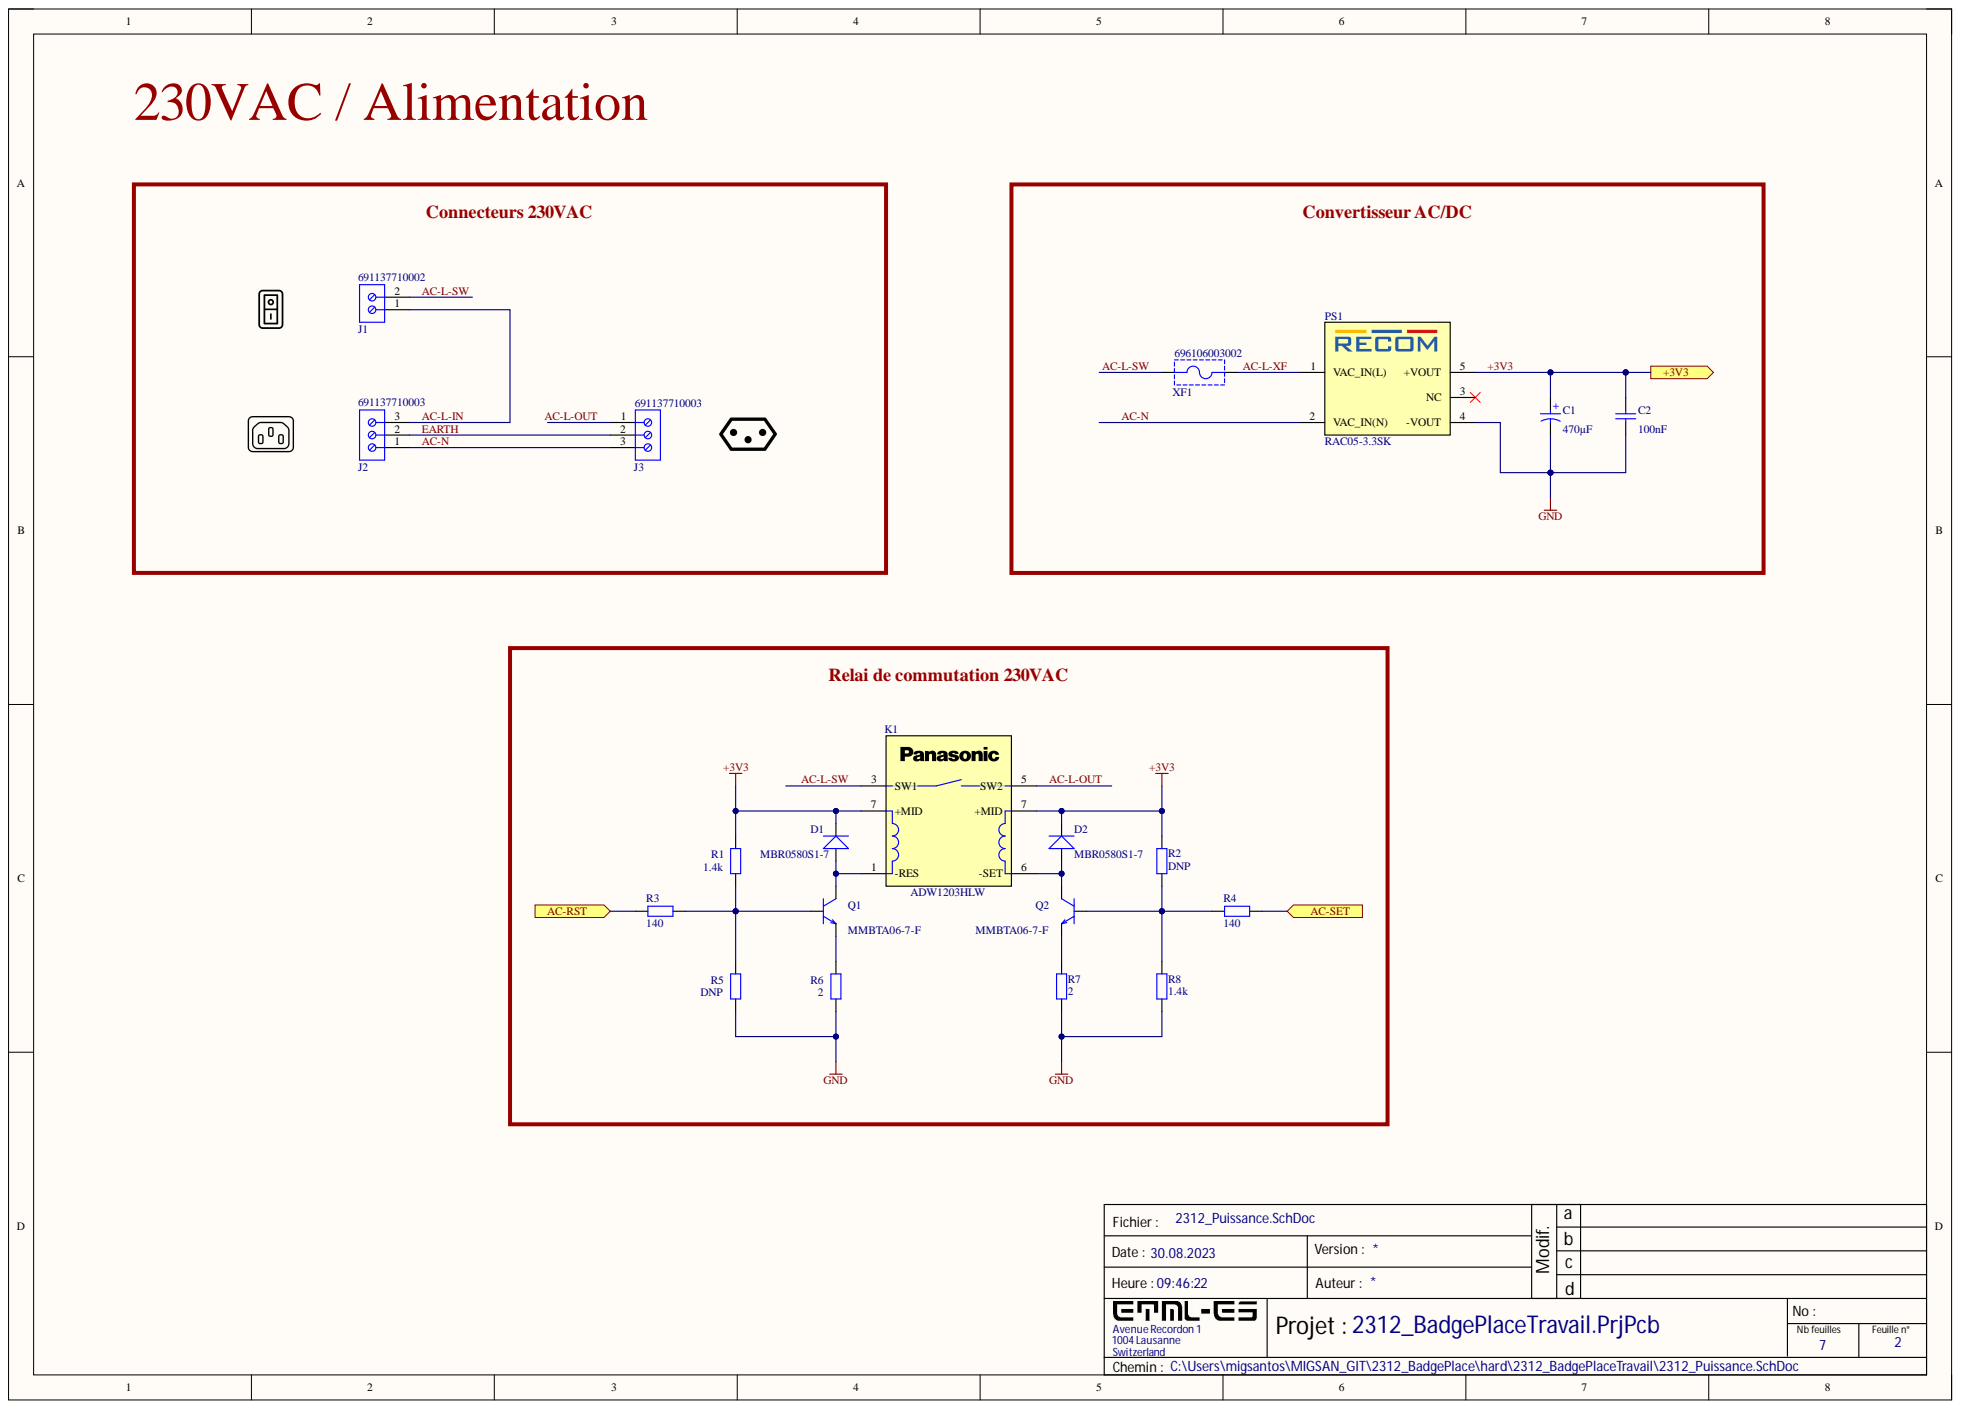
[picture p133: page 2]

2312_Puissance.SchDoc Fichier : | | a

Date : 30.08.2023 | Version : *

Heure : 09:46:22 | Auteur : *
Avenue Recordon 1 1004 Lausanne Switzerland | Projet : 2312_BadgePlaceTravail.PrjPcb | No :

Nb feuilles 7 | Feuille n° 2

Chemin : C:\Users\migsantos\MIGSAN_GIT\2312_BadgePlace\hard\2312_BadgePlaceTravail\2312_Puissance.SchDoc

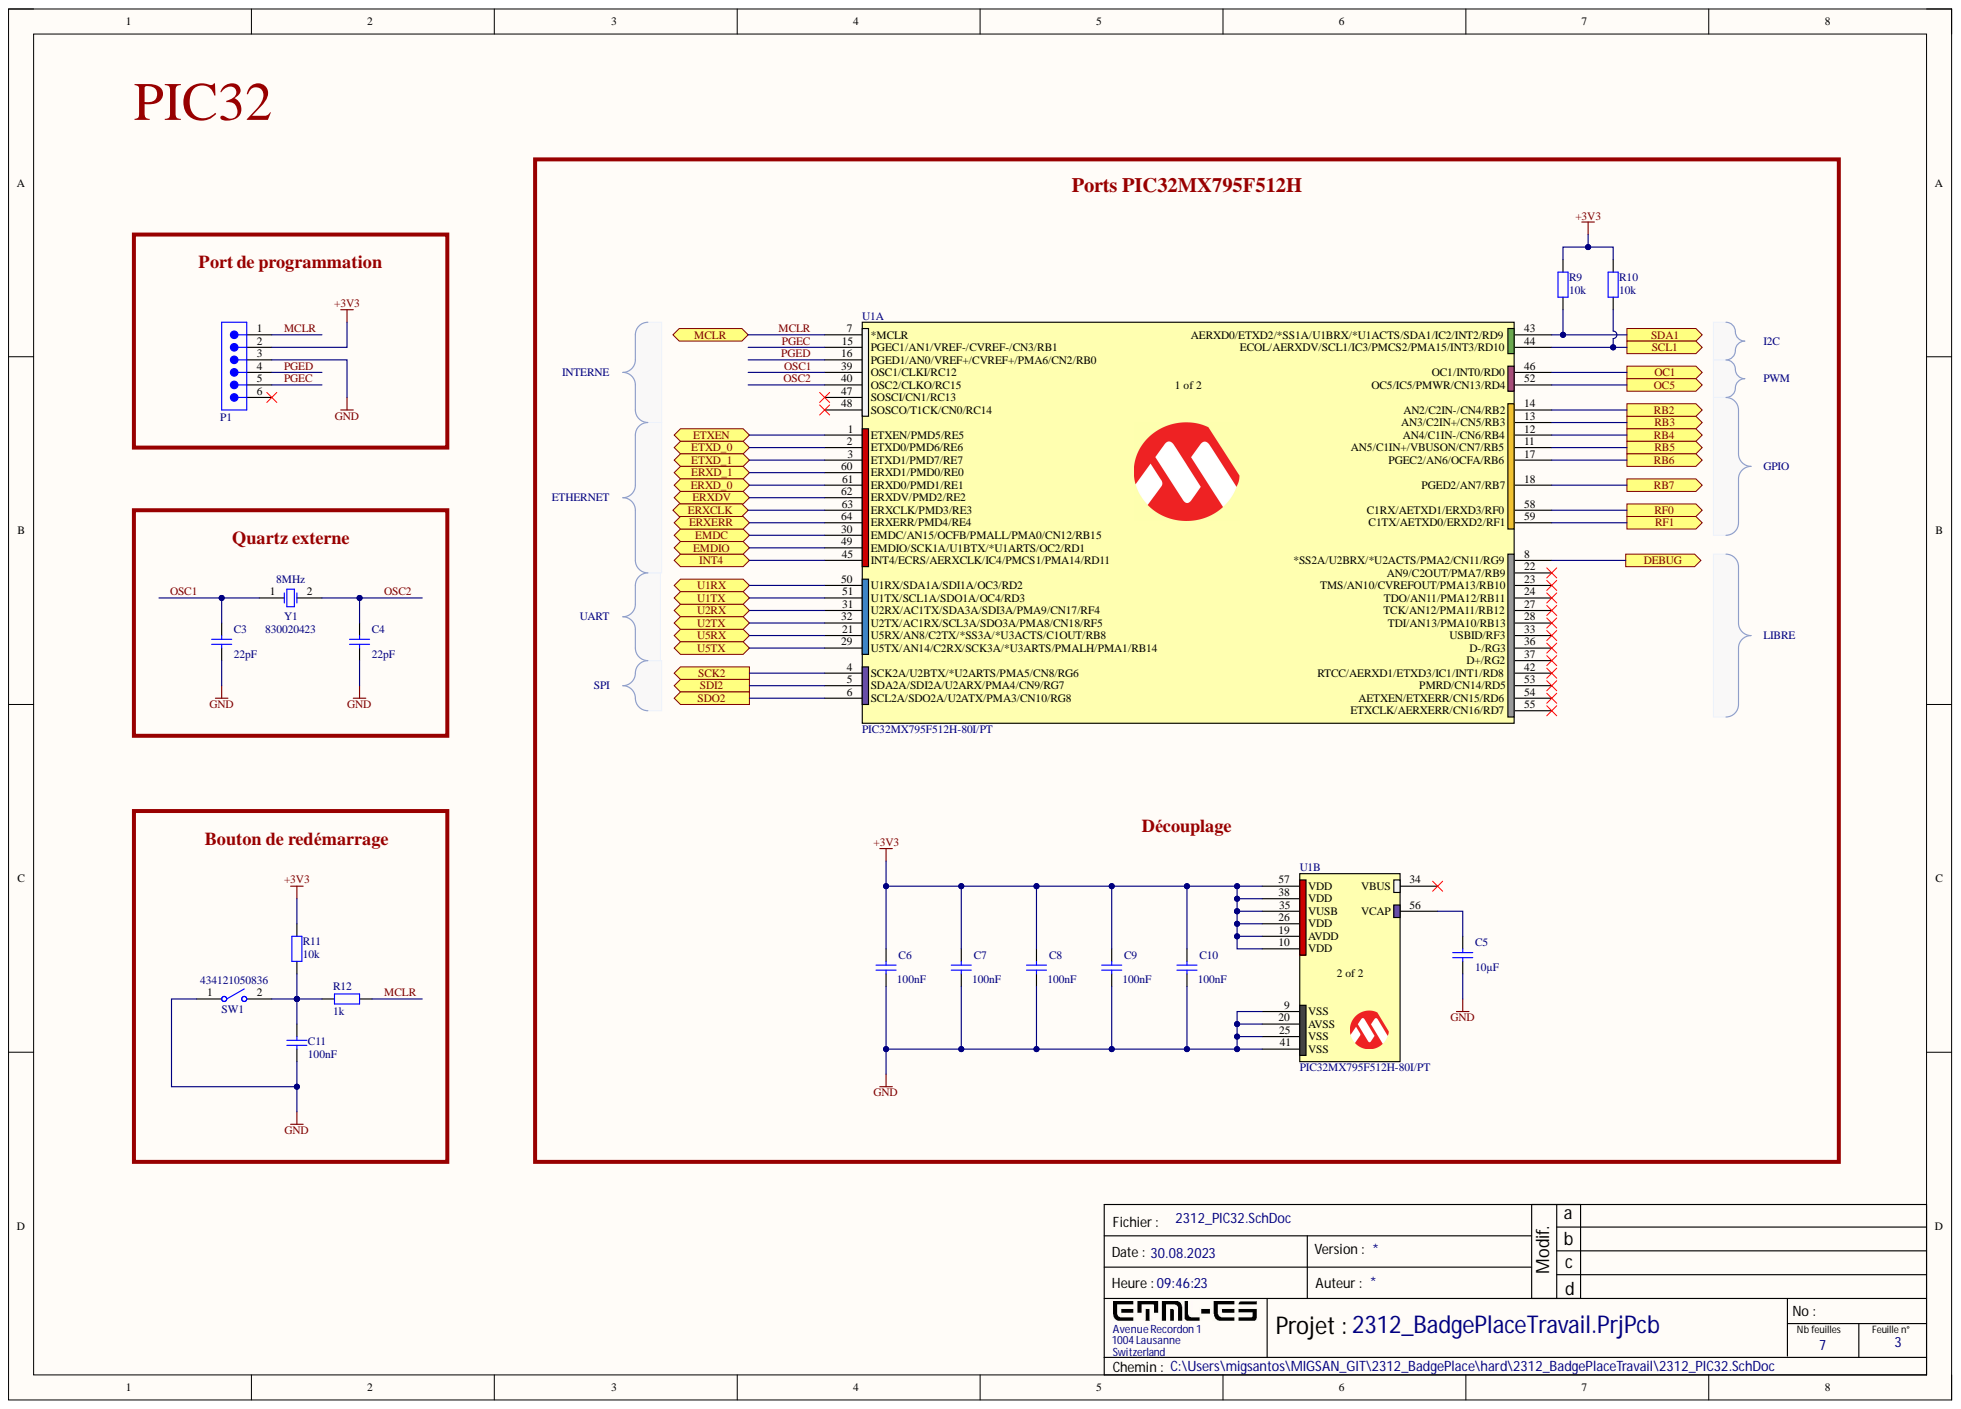
[picture p134: page 3]

2 3 1 2_PI C3 2 . SchDoc F i chi e r :

abcd

Date : 30. 08. 2023 | Ve rsion : *

H eure : 09: 46: 23 | Auteur : *

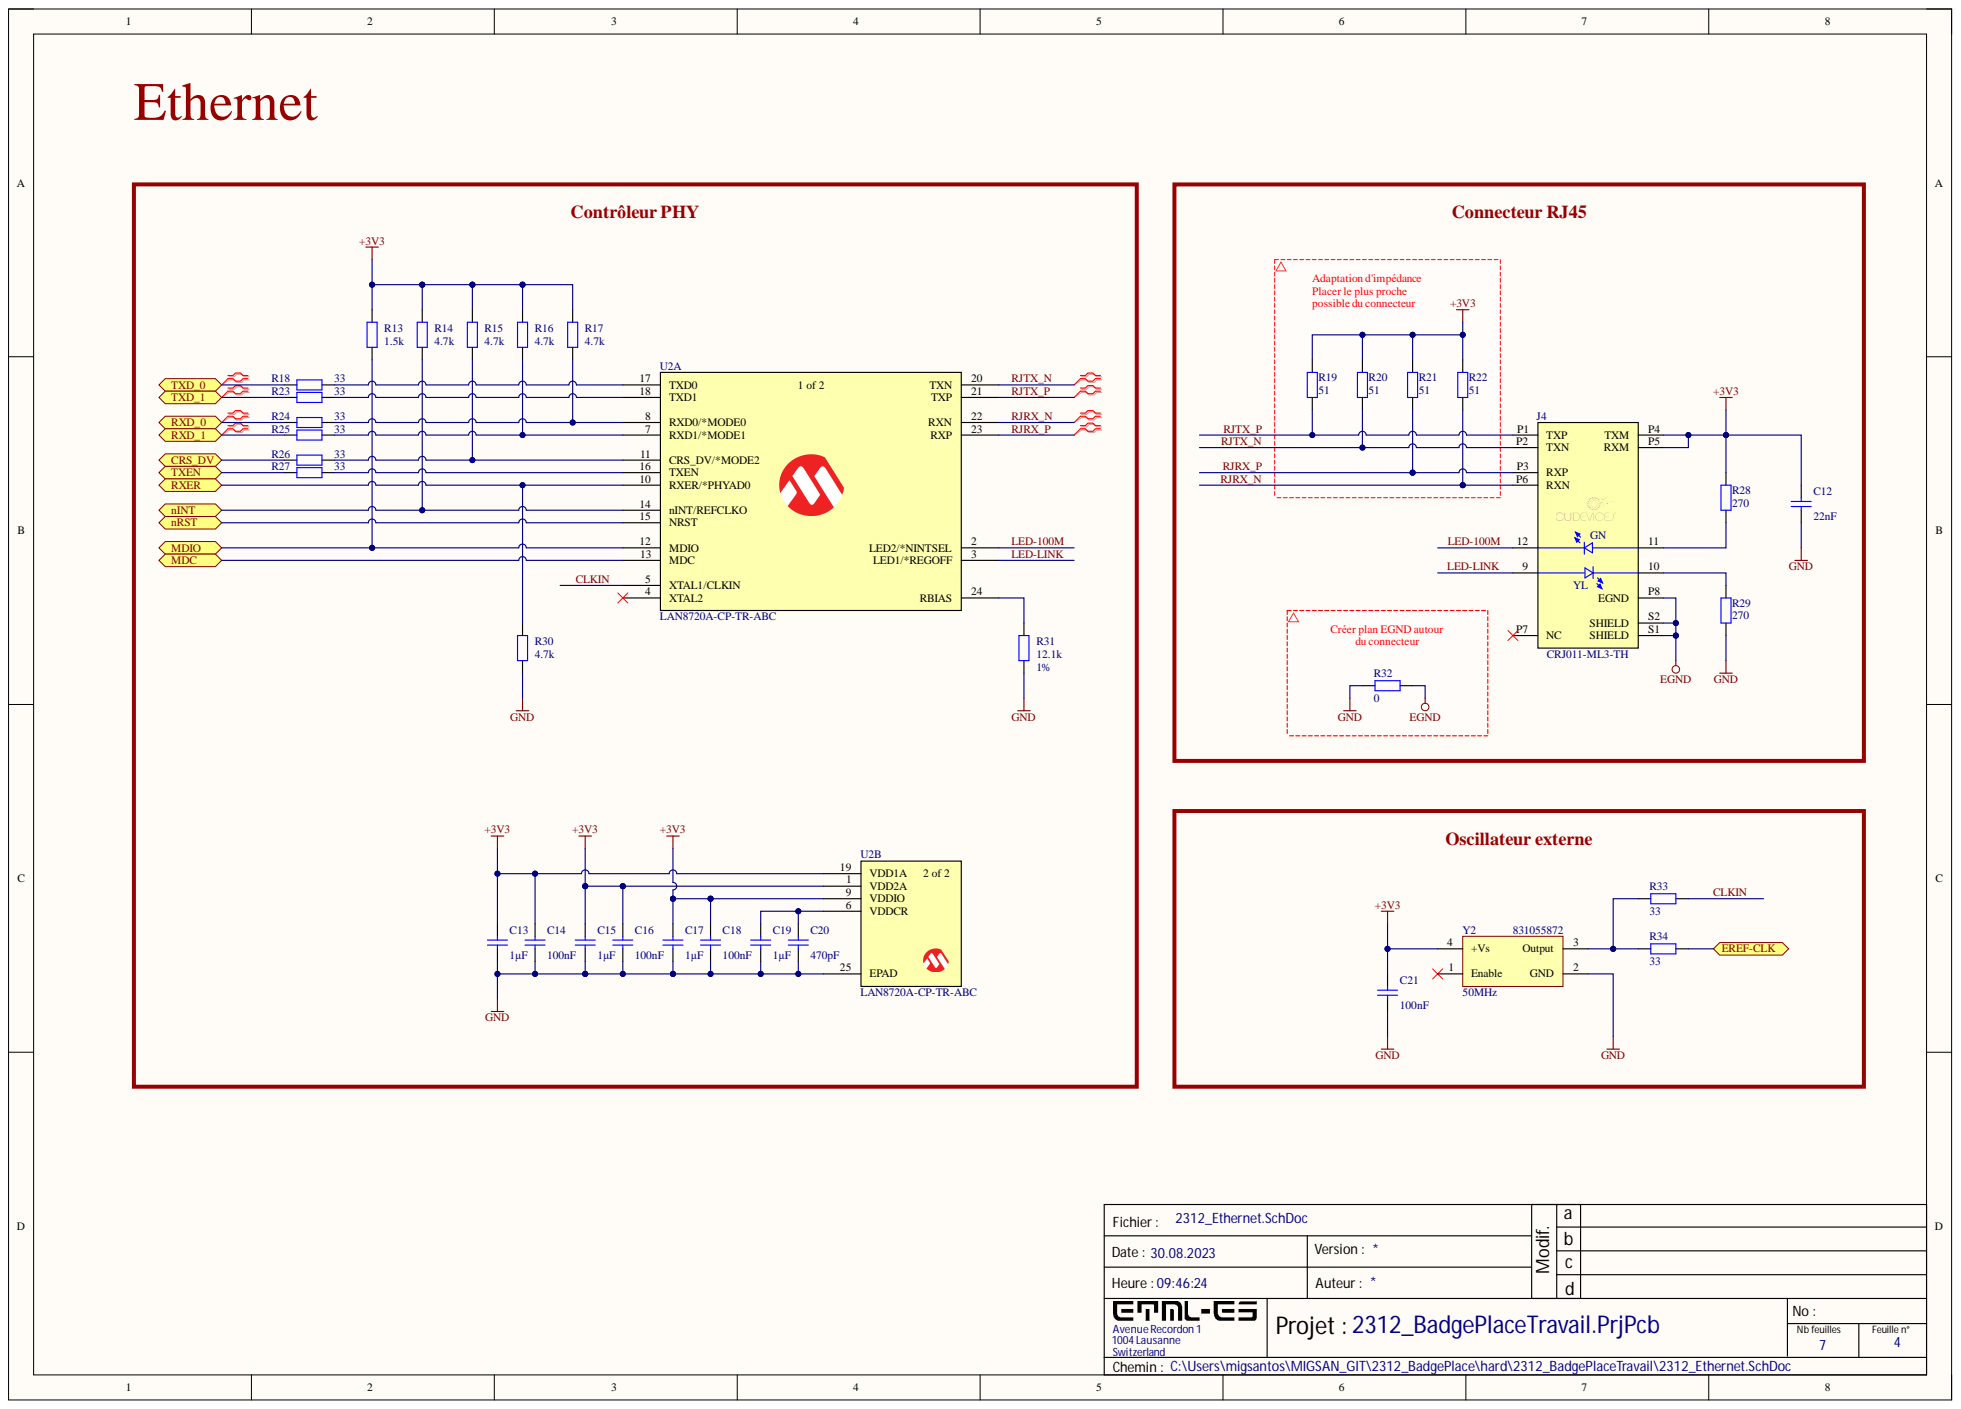
[picture p135: page 4]

Adaptation d'impédance
Placer le plus proche
possible du connecteur

TXEN 16

RXP P3

nINT/REFCLKO 14
NRST 15

+3V3 | | MDIO 12

CLKIN | XTAL1/CLKIN 5 XTAL2 4

Créer plan EGND autour
du connecteur

2312_Ethernet.SchDoc Fichier : | | a

Date : 30.08.2023 | Version : *

Heure : 09:46:24 | Auteur : *
Avenue Recordon 1 1004 Lausanne Switzerland | Projet : 2312_BadgePlaceTravail.PrjPcb | No :

Nb feuilles 7 | Feuille n° 4

Chemin : C:\Users\migsantos\MIGSAN_GIT\2312_BadgePlace\hard\2312_BadgePlaceTravail\2312_Ethernet.SchDoc

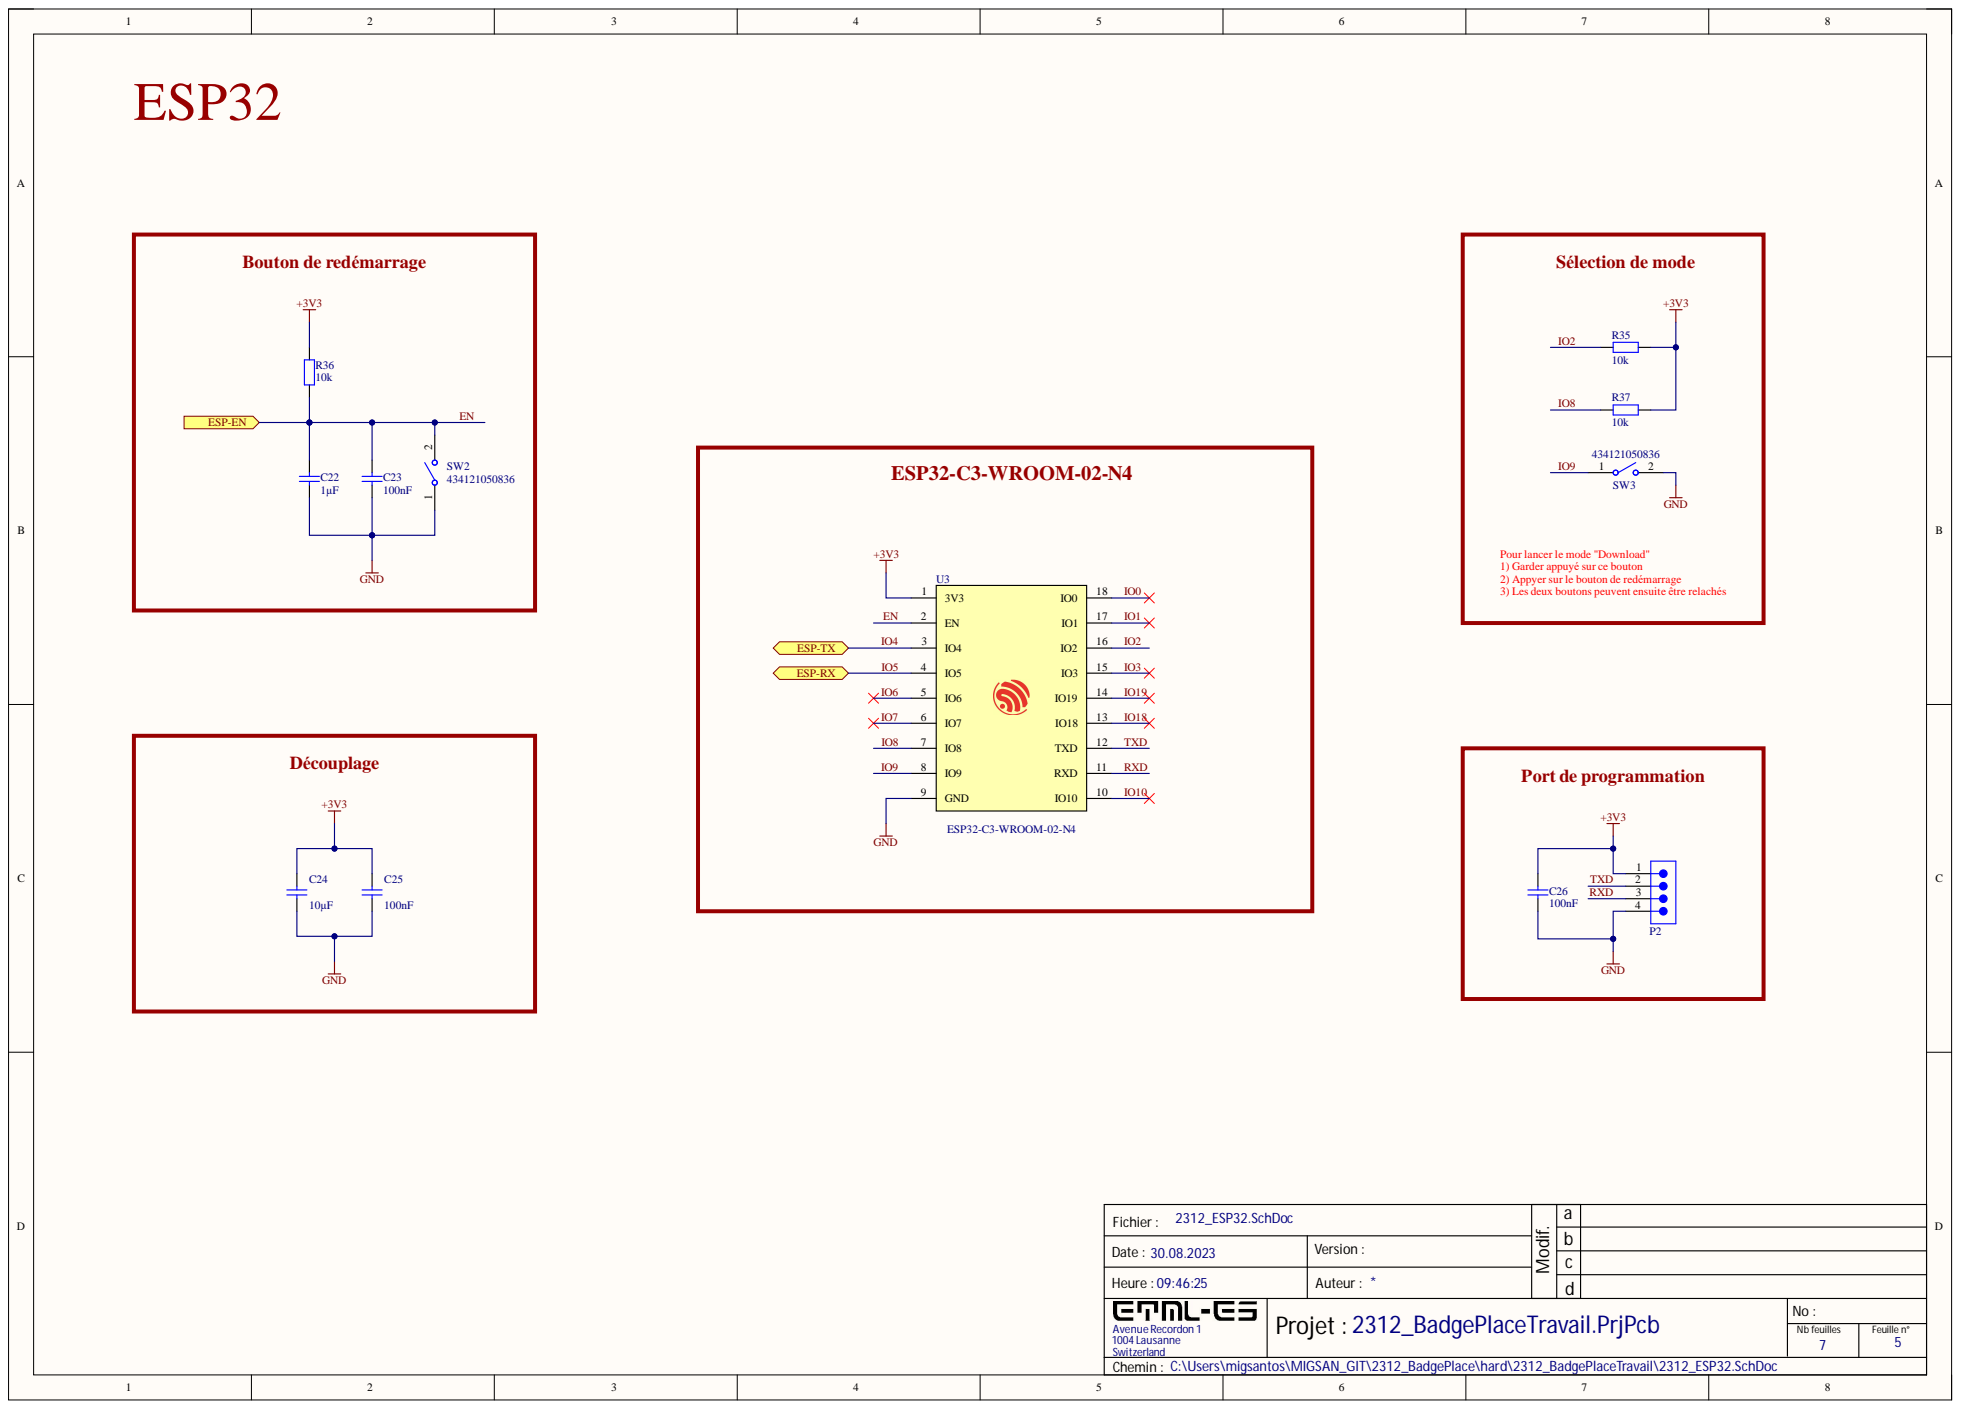
[picture p136: page 5]

lancer
Garder appuy
Appyer
Les deux boutons peuvent ensui

2 3 1 2_ESP3 2 . SchD oc F i chi e r :

abcd

Date : 30. 08. 2023 | Ve rsion :

H eure : 09: 46: 25 | Auteur : *

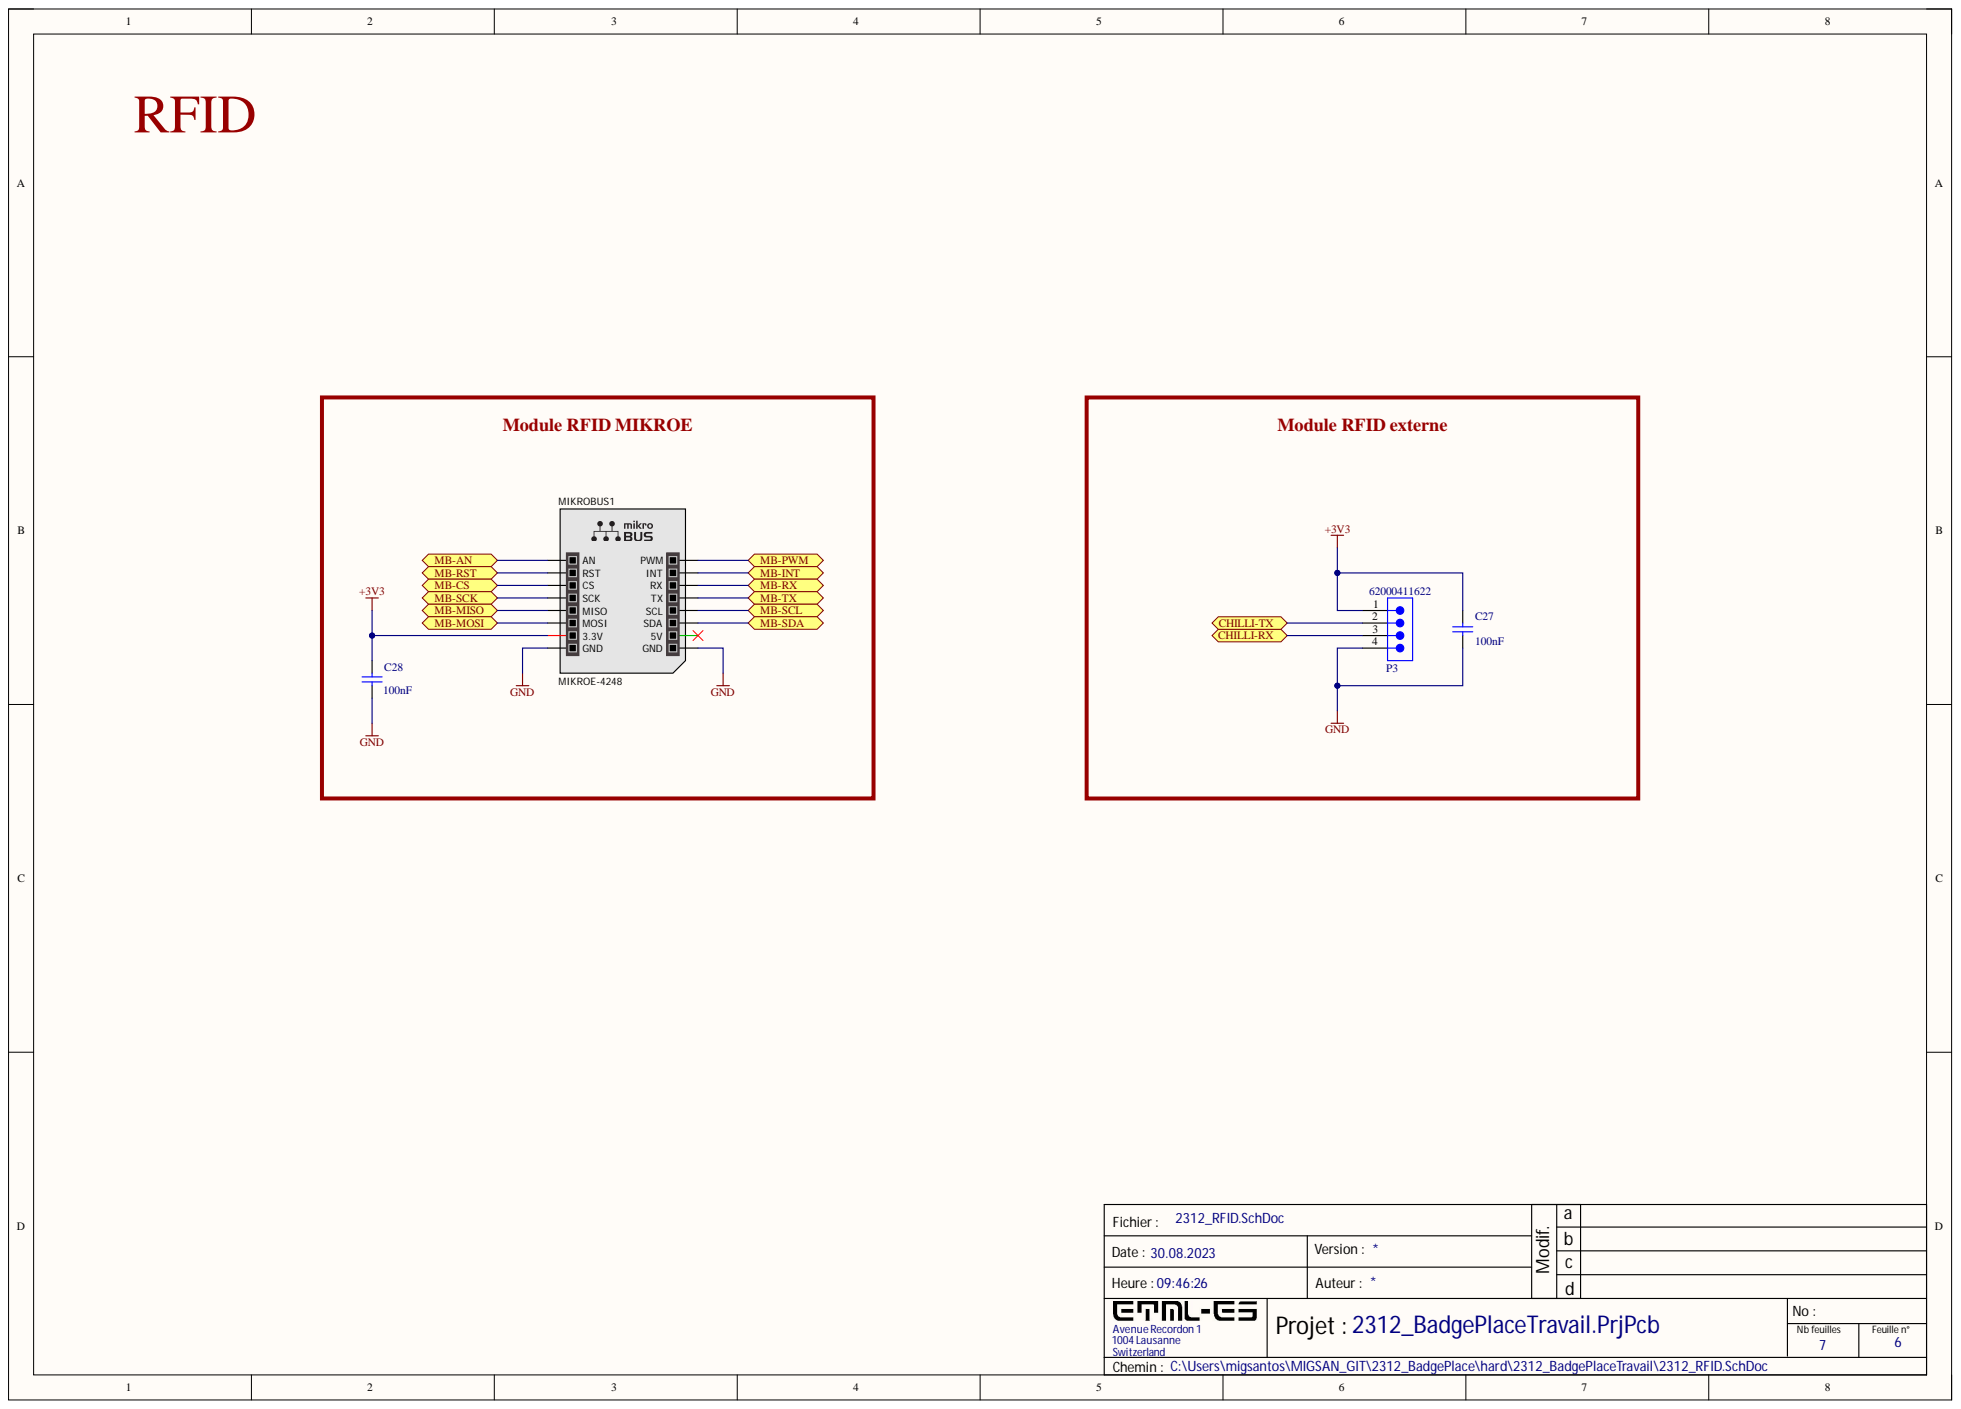
[picture p137: page 6]

2 3 1 2_R F I D . SchDoc F i chi e r :

abcd

Date : 30. 08. 2023 | Ve rsion : *

H eure : 09: 46: 26 | Auteur : *

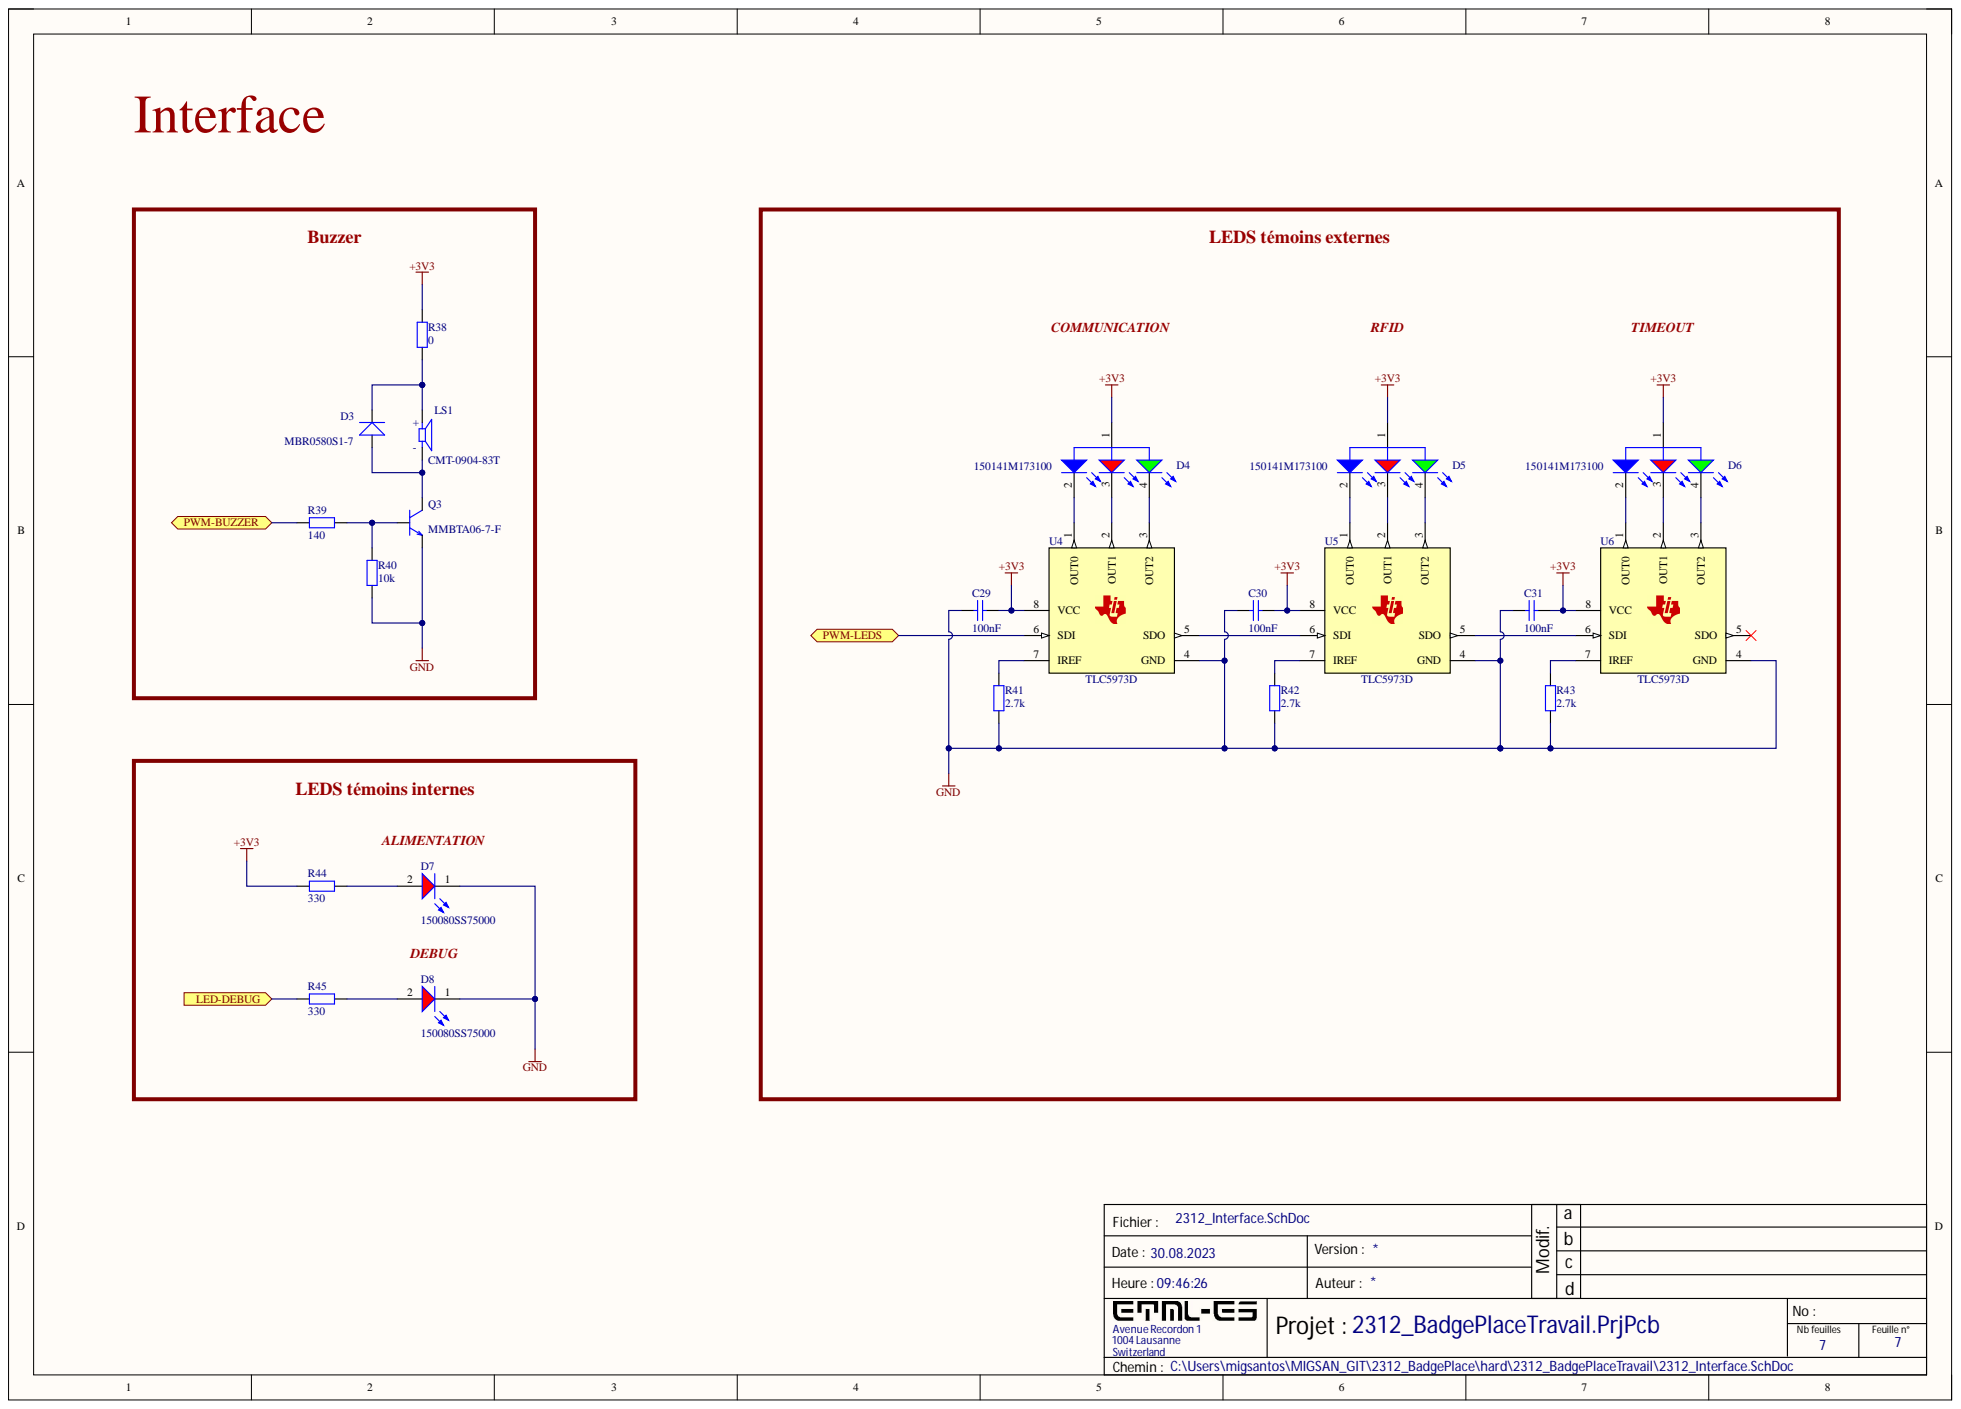
[picture p138: page 7]

2312_Interface.SchDoc Fichier : | | a

Date : 30.08.2023 | Version : *

Heure : 09:46:26 | Auteur : *
Avenue Recordon 1 1004 Lausanne Switzerland | Projet : 2312_BadgePlaceTravail.PrjPcb | No :

Nb feuilles 7 | Feuille n° 7

Chemin : C:\Users\migsantos\MIGSAN_GIT\2312_BadgePlace\hard\2312_BadgePlaceTravail\2312_Interface.SchDoc
