Miguel-SLO/2312_BadgePlace/(list of files, drawings)

Other design files:
hard/2312_BadgePlaceTravail/2312_BadgePlaceTravail.PrjPcb
hard/2312_BadgePlaceTravail/2312_ESP32.SchDoc
hard/2312_BadgePlaceTravail/2312_Ethernet.SchDoc
hard/2312_BadgePlaceTravail/2312_Interface.SchDoc
hard/2312_BadgePlaceTravail/2312_PIC32.SchDoc
hard/2312_BadgePlaceTravail/2312_Puissance.SchDoc
hard/2312_BadgePlaceTravail/2312_RFID.SchDoc
hard/2312_BadgePlaceTravail/2312_SchemaBloc.SchDoc
hard/2312_BadgePlaceTravail/ES_Class6C_2L.PcbDoc
hard/2312_Composants/2312-MS-0805/2312-MS-0805.PcbLib
hard/2312_Composants/2312-MS-0805/2312-MS-0805.SchLib
hard/2312_Composants/691137710003/691137710003.PcbLib
hard/2312_Composants/691137710003/691137710003.SchLib
hard/2312_Composants/ADW1203HLW/ADW1203HLW.PcbLib
hard/2312_Composants/ADW1203HLW/ADW1203HLW.SchLib
hard/2312_Composants/CRJ011-ML3-TH/CUI_CRJ011-ML3-TH.PcbLib
hard/2312_Composants/CRJ011-ML3-TH/CUI_CRJ011-ML3-TH.SchLib
hard/2312_Composants/CUI_CMT-0904-83T/CMT-0904-83T.PcbLib
hard/2312_Composants/CUI_CMT-0904-83T/CMT-0904-83T.SchLib
hard/2312_Composants/ESP32-C3-WROOM-02-N4/ESP32-C3-WROOM-02-N4.PcbLib
hard/2312_Composants/ESP32-C3-WROOM-02-N4/ESP32-C3-WROOM-02-N4.SchLib
hard/2312_Composants/LAN8720A-CP-TR-ABC/LAN8720A-CP-TR-ABC.PcbLib
hard/2312_Composants/LAN8720A-CP-TR-ABC/LAN8720A-CP-TR-ABC.SchLib
hard/2312_Composants/MBR0580S1-7/MBR0580S1-7.PcbLib
hard/2312_Composants/MBR0580S1-7/MBR0580S1-7.SchLib
hard/2312_Composants/MMBTA06-7-F/MMBTA06-7-F.PcbLib
hard/2312_Composants/MMBTA06-7-F/MMBTA06-7-F.SchLib
hard/2312_Composants/PIC32MX795F512H-80I-PT/PIC32MX795F512H-80I_PT.PcbLib
hard/2312_Composants/PIC32MX795F512H-80I-PT/PIC32MX795F512H-80I_PT.SchLib
hard/2312_Composants/RAC05-3.3SK/RAC05-3.3SK.PcbLib
hard/2312_Composants/RAC05-3.3SK/RAC05-3.3SK.SchLib
hard/2312_Composants/SOCKET mikroBUS 16 SMD/SOCKET mikroBUS 16 SMD.PcbLib
hard/2312_Composants/SOCKET mikroBUS 16 SMD/SOCKET mikroBUS 16 SMD.SCHLIB
hard/2312_Composants/TLC5973D/TLC5973D.PcbLib
hard/2312_Composants/TLC5973D/TLC5973D.SchLib
hard/2312_Composants/WCAP-CSGP (rev22f)/WCAP-CSGP.PcbLib
hard/2312_Composants/WCAP-CSRF (rev22e)/WCAP-CSRF.PcbLib
hard/2312_Composants/WCAP-CSRF (rev22e)/WCAP-CSRF.SchLib
hard/2312_Composants/WCAP-PSHP (rev22c)/WCAP-PSHP.PcbLib
hard/2312_Composants/WCAP-PSHP (rev22c)/WCAP-PSHP.SchLib
hard/2312_Composants/WE-SPXO (rev22a)/WE-SPXO.PcbLib
hard/2312_Composants/WE-SPXO (rev22a)/WE-SPXO.SchLib
hard/2312_Composants/WE-XTAL (rev22a)/WE-XTAL.PcbLib
hard/2312_Composants/WE-XTAL (rev22a)/WE-XTAL.SchLib
hard/2312_Composants/WL-SFTW (rev22b)/WL-SFTW.PcbLib
hard/2312_Composants/WL-SFTW (rev22b)/WL-SFTW.SchLib
hard/2312_Composants/WL-SMCW (rev22d)/WL-SMCW.PcbLib
hard/2312_Composants/WL-SMCW (rev22d)/WL-SMCW.SchLib
hard/2312_Composants/WR-FSH (rev22a)/WR-FSH.PcbLib
hard/2312_Composants/WR-FSH (rev22a)/WR-FSH.SchLib
hard/2312_Composants/WR-TBL (rev23d)/WR-TBL_Rising Cage Clamp_2.54mm.PcbLib
hard/2312_Composants/WR-TBL (rev23d)/WR-TBL_Rising Cage Clamp_3.50mm.PcbLib
hard/2312_Composants/WR-TBL (rev23d)/WR-TBL_Rising Cage Clamp_3.81mm.PcbLib
hard/2312_Composants/WR-TBL (rev23d)/WR-TBL_Rising Cage Clamp_6.35mm.PcbLib
hard/2312_Composants/WR-TBL (rev23d)/WR-TBL_Rising Cage Clamp_7.00mm.PcbLib
hard/2312_Composants/WR-TBL (rev23d)/WR-TBL_Rising Cage Clamp_7.50mm.PcbLib
hard/2312_Composants/WR-TBL (rev23d)/WR-TBL_Rising Cage Clamp_7.62mm.PcbLib
hard/2312_Composants/WR-TBL (rev23d)/WR-TBL_Rising Cage Clamp_9.52mm.PcbLib
hard/2312_Composants/WR-TBL (rev23d)/WR-TBL_Rising Cage Clamp_10.00mm.PcbLib
hard/2312_Composants/WR-TBL (rev23d)/WR-TBL_Spring Clamp_2.50mm.PcbLib
hard/2312_Composants/WR-TBL (rev23d)/WR-TBL_Spring Clamp_2.54mm.PcbLib
hard/2312_Composants/WR-TBL (rev23d)/WR-TBL_Spring Clamp_7.00mm.PcbLib
hard/2312_Composants/WR-TBL (rev23d)/WR-TBL_Spring Clamp_10.00mm.PcbLib
hard/2312_Composants/WR-TBL (rev23d)/WR-TBL_Spring Clamp_10.16mm.PcbLib
hard/2312_Composants/WR-TBL (rev23d)/WR-TBL_Wire Protector_3.50mm.PcbLib
hard/2312_Composants/WR-TBL (rev23d)/WR-TBL_Wire Protector_7.50mm.PcbLib
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
