Miguel-SLO/2312_BadgePlace/soft/2312_BadgePlace_PIC32/firmware/src/system_config/2312_Config/system_config.h

/*******************************************************************************
  MPLAB Harmony System Configuration Header

  File Name:
    system_config.h

  Summary:
    Build-time configuration header for the system defined by this MPLAB Harmony
    project.

  Description:
    An MPLAB Project may have multiple configurations.  This file defines the
    build-time options for a single configuration.

  Remarks:
    This configuration header must not define any prototypes or data
    definitions (or include any files that do).  It only provides macro
    definitions for build-time configuration options that are not instantiated
    until used by another MPLAB Harmony module or application.

    Created with MPLAB Harmony Version 2.06
*******************************************************************************/

// DOM-IGNORE-BEGIN
/*******************************************************************************
Copyright (c) 2013-2015 released Microchip Technology Inc.  All rights reserved.

Microchip licenses to you the right to use, modify, copy and distribute
Software only when embedded on a Microchip microcontroller or digital signal
controller that is integrated into your product or third party product
(pursuant to the sublicense terms in the accompanying license agreement).

You should refer to the license agreement accompanying this Software for
additional information regarding your rights and obligations.

SOFTWARE AND DOCUMENTATION ARE PROVIDED AS IS WITHOUT WARRANTY OF ANY KIND,
EITHER EXPRESS OR IMPLIED, INCLUDING WITHOUT LIMITATION, ANY WARRANTY OF
MERCHANTABILITY, TITLE, NON-INFRINGEMENT AND FITNESS FOR A PARTICULAR PURPOSE.
IN NO EVENT SHALL MICROCHIP OR ITS LICENSORS BE LIABLE OR OBLIGATED UNDER
CONTRACT, NEGLIGENCE, STRICT LIABILITY, CONTRIBUTION, BREACH OF WARRANTY, OR
OTHER LEGAL EQUITABLE THEORY ANY DIRECT OR INDIRECT DAMAGES OR EXPENSES
INCLUDING BUT NOT LIMITED TO ANY INCIDENTAL, SPECIAL, INDIRECT, PUNITIVE OR
CONSEQUENTIAL DAMAGES, LOST PROFITS OR LOST DATA, COST OF PROCUREMENT OF
SUBSTITUTE GOODS, TECHNOLOGY, SERVICES, OR ANY CLAIMS BY THIRD PARTIES
(INCLUDING BUT NOT LIMITED TO ANY DEFENSE THEREOF), OR OTHER SIMILAR COSTS.
*******************************************************************************/
// DOM-IGNORE-END

#ifndef _SYSTEM_CONFIG_H
#define _SYSTEM_CONFIG_H

// *****************************************************************************
// *****************************************************************************
// Section: Included Files
// *****************************************************************************
// *****************************************************************************
/*  This section Includes other configuration headers necessary to completely
    define this configuration.
*/


// DOM-IGNORE-BEGIN
#ifdef __cplusplus  // Provide C++ Compatibility

extern "C" {

#endif
// DOM-IGNORE-END

// *****************************************************************************
// *****************************************************************************
// Section: System Service Configuration
// *****************************************************************************
// *****************************************************************************
// *****************************************************************************
/* Common System Service Configuration Options
*/
#define SYS_VERSION_STR           "2.06"
#define SYS_VERSION               20600

// *****************************************************************************
/* Clock System Service Configuration Options
*/
#define SYS_CLK_FREQ                        80000000ul
#define SYS_CLK_BUS_PERIPHERAL_1            80000000ul
#define SYS_CLK_UPLL_BEFORE_DIV2_FREQ       48000000ul
#define SYS_CLK_CONFIG_PRIMARY_XTAL         8000000ul
#define SYS_CLK_CONFIG_SECONDARY_XTAL       32768ul
   
/*** Ports System Service Configuration ***/
#define SYS_PORT_AD1PCFG        ~0x3e83
#define SYS_PORT_CNPUE          0x400
#define SYS_PORT_CNEN           0x0
#define SYS_PORT_B_TRIS         0xFF83
#define SYS_PORT_B_LAT          0x0000
#define SYS_PORT_B_ODC          0x0000

#define SYS_PORT_C_TRIS         0xFFFF
#define SYS_PORT_C_LAT          0x0000
#define SYS_PORT_C_ODC          0x0000

#define SYS_PORT_D_TRIS         0xFFDE
#define SYS_PORT_D_LAT          0x0020
#define SYS_PORT_D_ODC          0x0000

#define SYS_PORT_E_TRIS         0xFFFF
#define SYS_PORT_E_LAT          0x0000
#define SYS_PORT_E_ODC          0x0000

#define SYS_PORT_F_TRIS         0xFFFC
#define SYS_PORT_F_LAT          0x0000
#define SYS_PORT_F_ODC          0x0000

#define SYS_PORT_G_TRIS         0xFDFF
#define SYS_PORT_G_LAT          0x0000
#define SYS_PORT_G_ODC          0x0000


/*** Interrupt System Service Configuration ***/
#define SYS_INT                     true

// *****************************************************************************
// *****************************************************************************
// Section: Driver Configuration
// *****************************************************************************
// *****************************************************************************
#define DRV_OC_DRIVER_MODE_STATIC 
/*** Timer Driver Configuration ***/
#define DRV_TMR_INTERRUPT_MODE             true

/*** Timer Driver 0 Configuration ***/
#define DRV_TMR_PERIPHERAL_ID_IDX0          TMR_ID_1
#define DRV_TMR_INTERRUPT_SOURCE_IDX0       INT_SOURCE_TIMER_1
#define DRV_TMR_INTERRUPT_VECTOR_IDX0       INT_VECTOR_T1
#define DRV_TMR_ISR_VECTOR_IDX0             _TIMER_1_VECTOR
#define DRV_TMR_INTERRUPT_PRIORITY_IDX0     INT_PRIORITY_LEVEL1
#define DRV_TMR_INTERRUPT_SUB_PRIORITY_IDX0 INT_SUBPRIORITY_LEVEL0
#define DRV_TMR_CLOCK_SOURCE_IDX0           DRV_TMR_CLKSOURCE_INTERNAL
#define DRV_TMR_PRESCALE_IDX0               TMR_PRESCALE_VALUE_8
#define DRV_TMR_OPERATION_MODE_IDX0         DRV_TMR_OPERATION_MODE_16_BIT
#define DRV_TMR_ASYNC_WRITE_ENABLE_IDX0     false
#define DRV_TMR_POWER_STATE_IDX0            

#define DRV_TMR_PERIPHERAL_ID_IDX1          TMR_ID_2
#define DRV_TMR_INTERRUPT_SOURCE_IDX1       INT_SOURCE_TIMER_2
#define DRV_TMR_INTERRUPT_VECTOR_IDX1       INT_VECTOR_T2
#define DRV_TMR_ISR_VECTOR_IDX1             _TIMER_2_VECTOR
#define DRV_TMR_INTERRUPT_PRIORITY_IDX1     INT_PRIORITY_LEVEL7
#define DRV_TMR_INTERRUPT_SUB_PRIORITY_IDX1 INT_SUBPRIORITY_LEVEL3
#define DRV_TMR_CLOCK_SOURCE_IDX1           DRV_TMR_CLKSOURCE_INTERNAL
#define DRV_TMR_PRESCALE_IDX1               TMR_PRESCALE_VALUE_1
#define DRV_TMR_OPERATION_MODE_IDX1         DRV_TMR_OPERATION_MODE_16_BIT

#define DRV_TMR_ASYNC_WRITE_ENABLE_IDX1     false
#define DRV_TMR_POWER_STATE_IDX1            
/*** Timer Driver 2 Configuration ***/
#define DRV_TMR_PERIPHERAL_ID_IDX2          TMR_ID_3
#define DRV_TMR_INTERRUPT_SOURCE_IDX2       INT_SOURCE_TIMER_3
#define DRV_TMR_INTERRUPT_VECTOR_IDX2       INT_VECTOR_T3
#define DRV_TMR_ISR_VECTOR_IDX2             _TIMER_3_VECTOR
#define DRV_TMR_INTERRUPT_PRIORITY_IDX2     INT_DISABLE_INTERRUPT
#define DRV_TMR_INTERRUPT_SUB_PRIORITY_IDX2 INT_SUBPRIORITY_LEVEL0
#define DRV_TMR_CLOCK_SOURCE_IDX2           DRV_TMR_CLKSOURCE_INTERNAL
#define DRV_TMR_PRESCALE_IDX2               TMR_PRESCALE_VALUE_64
#define DRV_TMR_OPERATION_MODE_IDX2         DRV_TMR_OPERATION_MODE_16_BIT
#define DRV_TMR_ASYNC_WRITE_ENABLE_IDX2     false
#define DRV_TMR_POWER_STATE_IDX2            

 // *****************************************************************************
/* USART Driver Configuration Options
*/
#define DRV_USART_INSTANCES_NUMBER                  2
#define DRV_USART_CLIENTS_NUMBER                    2
#define DRV_USART_INTERRUPT_MODE                    true
#define DRV_USART_BYTE_MODEL_SUPPORT                true
#define DRV_USART_READ_WRITE_MODEL_SUPPORT          false
#define DRV_USART_BUFFER_QUEUE_SUPPORT              false

// *****************************************************************************
// *****************************************************************************
// Section: Middleware & Other Library Configuration
// *****************************************************************************
// *****************************************************************************



// *****************************************************************************
// *****************************************************************************
// Section: Application Configuration
// *****************************************************************************
// *****************************************************************************
/*** Application Defined Pins ***/

/*** Functions for DEBUG pin ***/
#define DEBUGToggle() PLIB_PORTS_PinToggle(PORTS_ID_0, PORT_CHANNEL_G, PORTS_BIT_POS_9)
#define DEBUGOn() PLIB_PORTS_PinSet(PORTS_ID_0, PORT_CHANNEL_G, PORTS_BIT_POS_9)
#define DEBUGOff() PLIB_PORTS_PinClear(PORTS_ID_0, PORT_CHANNEL_G, PORTS_BIT_POS_9)
#define DEBUGStateGet() PLIB_PORTS_PinGetLatched(PORTS_ID_0, PORT_CHANNEL_G, PORTS_BIT_POS_9)
#define DEBUGStateSet(Value) PLIB_PORTS_PinWrite(PORTS_ID_0, PORT_CHANNEL_G, PORTS_BIT_POS_9, Value)

/*** Functions for MB_INT pin ***/
#define MB_INTToggle() PLIB_PORTS_PinToggle(PORTS_ID_0, PORT_CHANNEL_B, PORTS_BIT_POS_5)
#define MB_INTOn() PLIB_PORTS_PinSet(PORTS_ID_0, PORT_CHANNEL_B, PORTS_BIT_POS_5)
#define MB_INTOff() PLIB_PORTS_PinClear(PORTS_ID_0, PORT_CHANNEL_B, PORTS_BIT_POS_5)
#define MB_INTStateGet() PLIB_PORTS_PinGetLatched(PORTS_ID_0, PORT_CHANNEL_B, PORTS_BIT_POS_5)
#define MB_INTStateSet(Value) PLIB_PORTS_PinWrite(PORTS_ID_0, PORT_CHANNEL_B, PORTS_BIT_POS_5, Value)

/*** Functions for MB_PWM pin ***/
#define MB_PWMToggle() PLIB_PORTS_PinToggle(PORTS_ID_0, PORT_CHANNEL_B, PORTS_BIT_POS_4)
#define MB_PWMOn() PLIB_PORTS_PinSet(PORTS_ID_0, PORT_CHANNEL_B, PORTS_BIT_POS_4)
#define MB_PWMOff() PLIB_PORTS_PinClear(PORTS_ID_0, PORT_CHANNEL_B, PORTS_BIT_POS_4)
#define MB_PWMStateGet() PLIB_PORTS_PinGetLatched(PORTS_ID_0, PORT_CHANNEL_B, PORTS_BIT_POS_4)
#define MB_PWMStateSet(Value) PLIB_PORTS_PinWrite(PORTS_ID_0, PORT_CHANNEL_B, PORTS_BIT_POS_4, Value)

/*** Functions for MB_AN pin ***/
#define MB_ANToggle() PLIB_PORTS_PinToggle(PORTS_ID_0, PORT_CHANNEL_B, PORTS_BIT_POS_3)
#define MB_ANOn() PLIB_PORTS_PinSet(PORTS_ID_0, PORT_CHANNEL_B, PORTS_BIT_POS_3)
#define MB_ANOff() PLIB_PORTS_PinClear(PORTS_ID_0, PORT_CHANNEL_B, PORTS_BIT_POS_3)
#define MB_ANStateGet() PLIB_PORTS_PinGetLatched(PORTS_ID_0, PORT_CHANNEL_B, PORTS_BIT_POS_3)
#define MB_ANStateSet(Value) PLIB_PORTS_PinWrite(PORTS_ID_0, PORT_CHANNEL_B, PORTS_BIT_POS_3, Value)

/*** Functions for MB_CS pin ***/
#define MB_CSToggle() PLIB_PORTS_PinToggle(PORTS_ID_0, PORT_CHANNEL_B, PORTS_BIT_POS_2)
#define MB_CSOn() PLIB_PORTS_PinSet(PORTS_ID_0, PORT_CHANNEL_B, PORTS_BIT_POS_2)
#define MB_CSOff() PLIB_PORTS_PinClear(PORTS_ID_0, PORT_CHANNEL_B, PORTS_BIT_POS_2)
#define MB_CSStateGet() PLIB_PORTS_PinGetLatched(PORTS_ID_0, PORT_CHANNEL_B, PORTS_BIT_POS_2)
#define MB_CSStateSet(Value) PLIB_PORTS_PinWrite(PORTS_ID_0, PORT_CHANNEL_B, PORTS_BIT_POS_2, Value)

/*** Functions for MB_RST pin ***/
#define MB_RSTToggle() PLIB_PORTS_PinToggle(PORTS_ID_0, PORT_CHANNEL_B, PORTS_BIT_POS_6)
#define MB_RSTOn() PLIB_PORTS_PinSet(PORTS_ID_0, PORT_CHANNEL_B, PORTS_BIT_POS_6)
#define MB_RSTOff() PLIB_PORTS_PinClear(PORTS_ID_0, PORT_CHANNEL_B, PORTS_BIT_POS_6)
#define MB_RSTStateGet() PLIB_PORTS_PinGetLatched(PORTS_ID_0, PORT_CHANNEL_B, PORTS_BIT_POS_6)
#define MB_RSTStateSet(Value) PLIB_PORTS_PinWrite(PORTS_ID_0, PORT_CHANNEL_B, PORTS_BIT_POS_6, Value)

/*** Functions for TLC pin ***/
#define TLCToggle() PLIB_PORTS_PinToggle(PORTS_ID_0, PORT_CHANNEL_D, PORTS_BIT_POS_0)
#define TLCOn() PLIB_PORTS_PinSet(PORTS_ID_0, PORT_CHANNEL_D, PORTS_BIT_POS_0)
#define TLCOff() PLIB_PORTS_PinClear(PORTS_ID_0, PORT_CHANNEL_D, PORTS_BIT_POS_0)
#define TLCStateGet() PLIB_PORTS_PinGetLatched(PORTS_ID_0, PORT_CHANNEL_D, PORTS_BIT_POS_0)
#define TLCStateSet(Value) PLIB_PORTS_PinWrite(PORTS_ID_0, PORT_CHANNEL_D, PORTS_BIT_POS_0, Value)

/*** Functions for ESP_EN pin ***/
#define ESP_ENToggle() PLIB_PORTS_PinToggle(PORTS_ID_0, PORT_CHANNEL_D, PORTS_BIT_POS_5)
#define ESP_ENOn() PLIB_PORTS_PinSet(PORTS_ID_0, PORT_CHANNEL_D, PORTS_BIT_POS_5)
#define ESP_ENOff() PLIB_PORTS_PinClear(PORTS_ID_0, PORT_CHANNEL_D, PORTS_BIT_POS_5)
#define ESP_ENStateGet() PLIB_PORTS_PinGetLatched(PORTS_ID_0, PORT_CHANNEL_D, PORTS_BIT_POS_5)
#define ESP_ENStateSet(Value) PLIB_PORTS_PinWrite(PORTS_ID_0, PORT_CHANNEL_D, PORTS_BIT_POS_5, Value)

/*** Functions for AC_SET pin ***/
#define AC_SETToggle() PLIB_PORTS_PinToggle(PORTS_ID_0, PORT_CHANNEL_F, PORTS_BIT_POS_0)
#define AC_SETOn() PLIB_PORTS_PinSet(PORTS_ID_0, PORT_CHANNEL_F, PORTS_BIT_POS_0)
#define AC_SETOff() PLIB_PORTS_PinClear(PORTS_ID_0, PORT_CHANNEL_F, PORTS_BIT_POS_0)
#define AC_SETStateGet() PLIB_PORTS_PinGetLatched(PORTS_ID_0, PORT_CHANNEL_F, PORTS_BIT_POS_0)
#define AC_SETStateSet(Value) PLIB_PORTS_PinWrite(PORTS_ID_0, PORT_CHANNEL_F, PORTS_BIT_POS_0, Value)

/*** Functions for AC_RST pin ***/
#define AC_RSTToggle() PLIB_PORTS_PinToggle(PORTS_ID_0, PORT_CHANNEL_F, PORTS_BIT_POS_1)
#define AC_RSTOn() PLIB_PORTS_PinSet(PORTS_ID_0, PORT_CHANNEL_F, PORTS_BIT_POS_1)
#define AC_RSTOff() PLIB_PORTS_PinClear(PORTS_ID_0, PORT_CHANNEL_F, PORTS_BIT_POS_1)
#define AC_RSTStateGet() PLIB_PORTS_PinGetLatched(PORTS_ID_0, PORT_CHANNEL_F, PORTS_BIT_POS_1)
#define AC_RSTStateSet(Value) PLIB_PORTS_PinWrite(PORTS_ID_0, PORT_CHANNEL_F, PORTS_BIT_POS_1, Value)


/*** Application Instance 0 Configuration ***/

/*** Application Instance 1 Configuration ***/

/*** Application Instance 2 Configuration ***/

/*** Application Instance 3 Configuration ***/

//DOM-IGNORE-BEGIN
#ifdef __cplusplus
}
#endif
//DOM-IGNORE-END

#endif // _SYSTEM_CONFIG_H
/*******************************************************************************
 End of File
*/
