Miguel-SLO/2312_BadgePlace/(commit log)

2023-08-16 Ajout base Latex
    Ajout des fichiers pour réaliser l'organisation de base du rapport Latex
2023-08-17 Ajout consignes
    Ajout des documents de consigne du travail de diplôme fourni par l'ETML-ES
2023-08-17 Create Gantt-diplome_SLO_Santos.gan
    Création de la planification sous "Gantt-project" avec dates importantes.
2023-08-17 Mise en forme Gantt
    Mise en forme de base du diagramme de gantt
2023-08-18 Update Gantt-diplome_SLO_Santos.gan
    Ajout des différentes étapes et configuration des ressources.
    Exportation du PDF réussi
2023-08-21 Modifications Gantt
    Adaptation des différentes tâches et ajout du plan de référence initial.
2023-08-21 Raccourcis pour projets de référence
    Ajout des raccourcis vers les projets de références fournis dans le cahier des charges.
2023-08-21 Update Pré-étude
    Début de la pré-étude avec RFID.
2023-08-22 Update 2312_SchemaBloc_Hardware.drawio
    Réalisation du schéma-bloc de principe du circuit.
2023-08-22 MAJ Rapport et schemas-blocs
    [2312_BadgePlace_Journal.xlsx]
2023-08-23 MAJ Schémas-blocs
    Ajustement schéma bloc de principe.
    Création de schéma bloc hardware.
2023-08-23 Création projet Altium
    [2312_BadgePlaceTravail.PrjPcb, ES_Class6C_2L.PcbDoc]
2023-08-23 Update 2312_BadgePlace_Gantt.gan
    Mise à jour du Gantt pour intégrer la modélisation 3D, la commande des composants
2023-08-23 Create estimation_consommation.xlsx
    Fichier pour estimer la consommation du courant du circuit
    [estimation_consommation.xlsx]
2023-08-23 Ajouts logo divers
    Ajout de logo divers utilisé dans les schémas blocs
2023-08-24 Composant : B72214S0351K101
    [B72214S0351K101.PcbLib, B72214S0351K101.SchLib]
2023-08-24 Composant : SQMW56R8J
    [SQMW56R8J.PcbLib, SQMW56R8J.SchLib]
2023-08-24 3D : SQMW56R8J
    [SQMW56R8J.PcbLib, SQMW56R8J.stp]
2023-08-24 Début de schéma Altium
    Début de la réalisation du schéma d'alimentation.
    [2312_Alimentation.SchDoc, 2312_BadgePlaceTravail.PrjPcb, SQMW56R8J.PcbLib]
2023-08-24 Composant : LS10-13BxxR3P
    [LS10-13BxxR3P.PcbLib, LS10-13BxxR3P.SchLib]
2023-08-24 /!\ Suppression des composants
    [B72214S0351K101.PcbLib, B72214S0351K101.SchLib, LS10-13BxxR3P.PcbLib, LS10-13BxxR3P.SchLib, SQMW56R8J.PcbLib, SQMW56R8J.SchLib, SQMW56R8J.stp]
2023-08-24 Composant : TMPW_5-103
    [TMPW_5-103.PcbLib, TMPW_5-103.SchLib, TMPW_5-103.stp]
2023-08-24 Composant : 36911600000
    LittleFuse 36911600000
    [36911600000.PcbLib, 36911600000.SchLib, 36911600000.stp]
2023-08-24 Composant : 691137710003
    [691137710003.PcbLib, 691137710003.SchLib]
2023-08-24 Journal de travail + MAJ Altium
    [2312_Alimentation.SchDoc, 2312_BadgePlaceTravail.PrjPcb, 2312_BadgePlace_Journal.xlsx, ES_Class6C_2L.PcbDoc]
2023-08-25 Suppression composants
    [36911600000.PcbLib, 36911600000.SchLib, 36911600000.stp, TMPW_5-103.PcbLib, TMPW_5-103.SchLib, TMPW_5-103.stp]
2023-08-25 Composant : RAC05-3.3SK
    [RAC05-3.3SK.PcbLib, RAC05-3.3SK.STEP, RAC05-3.3SK.SchLib]
2023-08-25 Composant : ADW1203HLW
    [ADW1203HLW.PcbLib, ADW1203HLW.SchLib, ADW1203HLW.step]
2023-08-25 Altium update system
    [2312_Alimentation.SchDoc, 2312_BadgePlaceTravail.PrjPcb]
2023-08-26 Update fichiers Altium
    [2312_Alimentation.SchDoc, 2312_BadgePlaceTravail.PrjPcb, 2312_Interface.SchDoc, 2312_Microcontroleur.SchDoc, 2312_Puissance.SchDoc]
2023-08-26 Update fichiers Altium (2)
    [2312_BadgePlaceTravail.PrjPcb, 2312_Communication.SchDoc, 2312_Microcontroleur.SchDoc]
2023-08-26 Update altium 11:00
    [2312_BadgePlaceTravail.PrjPcb, 2312_Puissance.SchDoc, ADW1203HLW.SchLib, RAC05-3.3SK.SchLib, WCAP-CSGP.PcbLib, WCAP-PSHP.PcbLib, WCAP-PSHP.SchLib]
2023-08-26 Finalisation de la schématique ETHERNET
    [2312-MS-0805.PcbLib, 2312-MS-0805.SchLib, 2312_BadgePlaceTravail.PrjPcb, 2312_BadgePlace_Journal.xlsx, 2312_Ethernet.SchDoc, 2312_Microcontroleur.SchDoc, 2312_Puissance.SchDoc, 2312_SchemaBloc.SchDoc]
2023-08-27 Composant : WL-SBCD
    [WL-SBCD.PcbLib, WL-SBCD.SchLib]
2023-08-27 Composant : WL-SFTW
    [WL-SFTW.PcbLib, WL-SFTW.SchLib]
2023-08-27 Composant : TLC5973D
    [TLC5973D.PcbLib, TLC5973D.SchLib]
2023-08-27 Composant : WR-WTB
    [WR-WTB.SchLib]
2023-08-27 Composant : Socket MIKROBUS
    [SOCKET mikroBUS 16 SMD.PcbLib, SOCKET mikroBUS 16 SMD.SCHLIB]
2023-08-27 Composants : Logiques diverses
    [2312-MS-0805.SchLib, ADW1203HLW.SchLib, CMT-0904-83T.PcbLib, CMT-0904-83T.SchLib, CMT-0904-83T.step, CUI_CEM-1201_42.step, ESP32-C3-WROOM-02-N4.PcbLib, ESP32-C3-WROOM-02-N4.SchLib]
2023-08-27 Update Altium project
    [2312_BadgePlaceTravail.PrjPcb, 2312_Communication.SchDoc, 2312_Ethernet.SchDoc, 2312_Interface.SchDoc, 2312_Microcontroleur.SchDoc, 2312_Puissance.SchDoc]
2023-08-28 Update Altium History
    Suppression des fichiers d'historiques inutiles
2023-08-28 Projet Altium à jour
    Schématiques terminées à 80% ; Manque la schématique du PIC32
    [2312_BadgePlaceTravail.PrjPcb, 2312_Communication.SchDoc, 2312_ESP32.SchDoc, 2312_Ethernet.SchDoc, 2312_Interface.SchDoc, 2312_Microcontroleur.SchDoc, 2312_Puissance.SchDoc, 2312_SchemaBloc.SchDoc]
2023-08-28 Composant : WS-TASV
    [WS-TASV.PcbLib, WS-TASV.SchLib]
2023-08-28 Composant : WE-XTAL
    [WE-XTAL.PcbLib, WE-XTAL.SchLib]
2023-08-28 Composant : WCAP-CSRF
    [WCAP-CSRF.PcbLib, WCAP-CSRF.SchLib]
2023-08-28 Update footprint et symboles
    [ADW1203HLW.SchLib, LAN8720A-CP-TR-ABC.SchLib, PIC32MX795F512H-80I_PT.SchLib]
2023-08-28 Finalisation schématiques Altium
    [2312_ESP32.SchDoc, 2312_Ethernet.SchDoc, 2312_Interface.SchDoc, 2312_Microcontroleur.SchDoc, 2312_RFID.SchDoc, 2312_SchemaBloc.SchDoc, PIC32MX795F512H-80I_PT.SchLib]
2023-08-28 Rappel Altium
    [2312_SchemaBloc.SchDoc]
2023-08-29 Renommage schématique PIC32
    Renommage de "2312_Microcontroleur.SchDoc" -> "2312_PIC32.SchDoc"
    [2312_BadgePlaceTravail.PrjPcb, 2312_Microcontroleur.SchDoc, 2312_PIC32.SchDoc, 2312_SchemaBloc.SchDoc]
2023-08-29 Schémas terminés + BOM
    [2312_BadgePlaceTravail.PrjPcb, 2312_ESP32.SchDoc, 2312_Ethernet.SchDoc, 2312_Interface.SchDoc, 2312_PIC32.SchDoc, 2312_Puissance.SchDoc, 2312_RFID.SchDoc, 2312_SchemaBloc.SchDoc]
2023-08-29 Update composant : MBR0580S1-7
    [MBR0580S1-7.PcbLib, MBR0580S1-7.SchLib, MMBTA06-7-F.SchLib]
2023-08-29 Composant : WE-SPXO
    [WE-SPXO.PcbLib, WE-SPXO.SchLib]
2023-08-29 Composant : WR-FSH
    [WR-FSH.PcbLib, WR-FSH.SchLib]
2023-08-29 Composant : WL-SMCW
    [WL-SMCW.PcbLib, WL-SMCW.SchLib]
2023-08-29 Mise en page des schémas
    [2312_BadgePlaceTravail.PrjPcb, 2312_ESP32.SchDoc, 2312_Ethernet.SchDoc, 2312_Interface.SchDoc, 2312_PIC32.SchDoc, 2312_Puissance.SchDoc, 2312_RFID.SchDoc, 2312_SchemaBloc.SchDoc]
2023-08-30 Ajustements projets, début PCB
    [2312_BadgePlaceTravail.PrjPcb, 2312_ESP32.SchDoc, 2312_Ethernet.SchDoc, 2312_Interface.SchDoc, 2312_PIC32.SchDoc, 2312_Puissance.SchDoc, 2312_RFID.SchDoc, 2312_SchemaBloc.SchDoc]
2023-08-30 Fichiers STP composants externes
    [STP_471001264142 (rev1).stp, e_0870.0001i002.step]
2023-08-30 Début du placement PCB
    [2312_BadgePlaceTravail.PrjPcb, 2312_Ethernet.SchDoc]
2023-08-31 Placement PCB
    [2312_Ethernet.SchDoc, 2312_SchemaBloc.SchDoc, Chilli_UART-B1.step, LAN8720A-CP-TR-ABC.PcbLib, STP_471001264142 (rev1).stp, e_0100.2571_002.step, e_0870.0001i002.step]
2023-08-31 Sauvegarde Altium
    [2312_BadgePlaceTravail.PrjPcb, 2312_ESP32.SchDoc, 2312_Ethernet.SchDoc, 2312_Interface.SchDoc, 2312_PIC32.SchDoc, 2312_Puissance.SchDoc, 2312_RFID.SchDoc, 2312_SchemaBloc.SchDoc]
2023-08-31 Update PCB
2023-09-01 Début de routage
    [2312_Interface.SchDoc, 2312_PIC32.SchDoc, LAN8720A-CP-TR-ABC.PcbLib, TLC5973D.SchLib]
2023-09-01 Routage du port ethernet
    [2312_ESP32.SchDoc, 2312_PIC32.SchDoc, 2312_SchemaBloc.SchDoc, PIC32MX795F512H-80I_PT.SchLib]
2023-09-02 Routage en cours
    [2312-MS-0805.PcbLib, PIC32MX795F512H-80I_PT.PcbLib]
2023-09-02 Re-placement (avec succès !)
    [MMBTA06-7-F.PcbLib]
2023-09-02 Début de routage (50%)
2023-09-03 Routage PCB terminé à 90%
    [2312_BadgePlaceTravail.PrjPcb, 2312_ESP32.SchDoc, 2312_Ethernet.SchDoc, 2312_Interface.SchDoc, 2312_PIC32.SchDoc, 2312_Puissance.SchDoc, 2312_RFID.SchDoc, 2312_SchemaBloc.SchDoc]
2023-09-03 Vérification finale
    [2312_BadgePlaceTravail.PrjPcb, 2312_Ethernet.SchDoc, 2312_PIC32.SchDoc, CUI_CRJ011-ML3-TH.PcbLib, ESP32-C3-WROOM-02-N4.PcbLib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]
2023-09-04 Routage terminé et vérifié !
    [ES_Class6C_2L_Board_Outline_(ES).gbr, ES_Class6C_2L_Copper_Signal_Bot.gbr, ES_Class6C_2L_Copper_Signal_Top.gbr, ES_Class6C_2L_Legend_Bot.gbr, ES_Class6C_2L_Legend_Top.gbr, ES_Class6C_2L_Pads_Bot.gbr, ES_Class6C_2L_Pads_Top.gbr, ES_Class6C_2L_Profile.gbr]
2023-09-04 Contrôle des footprints (1)
    [2312_BadgePlaceTravail.PrjPcb, LAN8720A-CP-TR-ABC.PcbLib, TLC5973D.PcbLib]
2023-09-04 Corrections de footprints (2)
    [2312_BadgePlaceTravail.PrjPcb, LAN8720A-CP-TR-ABC.PcbLib]
2023-09-04 Final Altium : Commande du PCB !
    [MBR0580S1-7.PcbLib, MMBTA06-7-F.PcbLib, TLC5973D.PcbLib]
2023-09-05 Fin de séance d'écriture du rapport
    [2312_BadgePlace_Journal.xlsx]
2023-09-06 Début de la programmation UART
    [2312_BadgePlace_Journal.xlsx]
2023-09-07 Fin de sessions de prog et rapport
    [2312_BadgePlace_Journal.xlsx]
2023-09-08 Fin de la troisième semaine !
    [2312_BadgePlace_Journal.xlsx]
2023-09-12 Changement noms des pins
    Tirets non valide dans le nom des pins sous harmony !!
2023-09-12 Programme de test
2023-09-12 Config timers + OCs
2023-09-12 Creation configs avancées
    Création des machines d'états nécessaires + config des drivers harmony
2023-09-12 Fichiers et programmes ESP32
    [mfg_nvs.csv]
2023-09-12 Changement valeurs résistances
    [2312_Interface.SchDoc, 2312_Puissance.SchDoc]
2023-09-12 Tests projets harmony
    [2312_BadgePlaceTravail.PrjPcb]
2023-09-13 Projet MPLAB supprimé !
    Plusieurs erreurs de builds et de configuration. Projet recommencé à zero
2023-09-13 Configuration des pins sous Harmony
2023-09-13 Journée de programmation
    [2312_Interface.SchDoc]
2023-09-14 Création des librairies leds
2023-09-14 Compilation projet ESP32
2023-09-15 Réorganisation dossier soft
    [mfg_nvs.csv]
2023-09-18 Altium Draftsman
    [2312_BadgePlaceTravail.PrjPcb, CUI_CRJ011-ML3-TH.PcbLib]
2023-09-19 Fin de séance de prog
2023-09-19 Recommandations ESP32
2023-09-20 Prog RFID + ESP + rapport
    [2312_BadgePlace_Planing.xlsx, listings_fonctions.xlsx]
2023-09-21 Programmation et captures de l'ESP32
2023-09-22 Prog ESP terminée, début buzzer
    [bzr.c, bzr.h, counter.c, counter.h]
2023-09-23 Rédaction de rapport
    [2312_Ethernet.SchDoc, 2312_Interface.SchDoc, 2312_Puissance.SchDoc, 2312_RFID.SchDoc]
2023-09-24 MAJ Rapport + annexes
    [2312_BadgePlaceTravail.XLS, 2312_PIC32.SchDoc]
2023-09-25 MAJ commentaires code et fichier de fab
    [listings_fonctions.xlsx]
2023-09-26 Boitier pour le projet
    [2312_Case.FCStd]
2023-09-27 Modélisation boitier "bottom"
    [2312_Case-2312_Bottom.3mf, 2312_Case-2312_Bottom.stl, 2312_Case.FCStd]
2023-09-27 Réalisation du boitier terminé !
    [2312_Case-2312_Bottom.3mf, 2312_Case-2312_Holder.stl, 2312_Case-2312_Mikroe.stl, 2312_Case-2312_Top.3mf, 2312_Case-2312_Top.stl, 2312_Case.FCStd, 2312_Case_bottom.step, 2312_FullCase.step]
2023-09-27 Fin du boitier
    [2312_Bottom_case.stl, 2312_Cable_holder.stl, 2312_Case-2312_Holder.3mf, 2312_Case-2312_Top.3mf, 2312_Case-2312_Top.stl, 2312_Mikroe_cache.stl, 2312_Top_case.stl]
2023-09-28 Remise du rapport final
    [2312_BadgePlaceTravail.PrjPcb, 2312_BadgePlace_Journal.xlsx, 2312_BadgePlace_Planing.xlsx, 2312_ESP32.SchDoc, 2312_Ethernet.SchDoc, 2312_Interface.SchDoc, 2312_PIC32.SchDoc, 2312_Puissance.SchDoc]
2023-09-28 Update fichiers 3D
    [2312_Bottom_case.stl, 2312_Cable_holder.stl, 2312_Mikroe_cache.stl, 2312_Top_case.stl]
2023-09-28 Prog réussie !
    [2312_Boitier_base-couvercle.FCStd, 2312_Case-2312_Bottom.3mf, 2312_Case-2312_Bottom.stl, 2312_Case-2312_Holder.3mf]
2023-09-29 Prog de présentation terminé !
2023-10-04 Petites modifs
    [2312_Case-2312_Bottom.step, 2312_Case-2312_Top.3mf, 2312_Case_bottom.step, TLC5973D.SchLib]
2023-10-05 Fin de présentation
2023-10-10 Fin de projet
